tjankovic/2-77-ppd/design_notebook/A_04.jpg

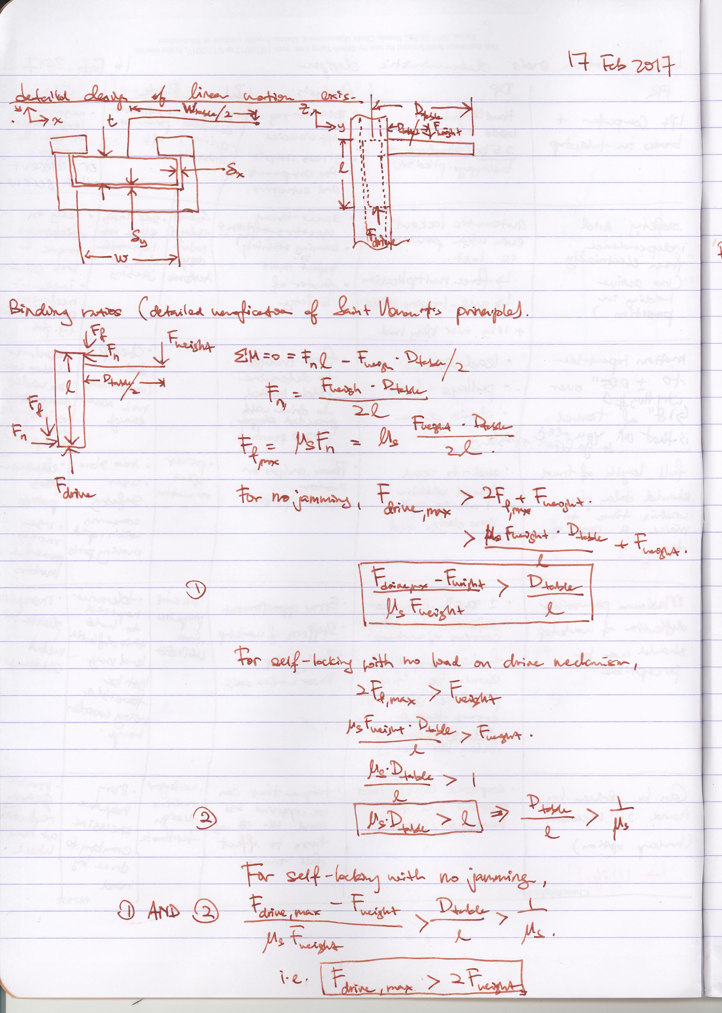
design_notebook/A_04.jpg
