tjankovic/2-77-ppd/design_notebook/A_01.jpg

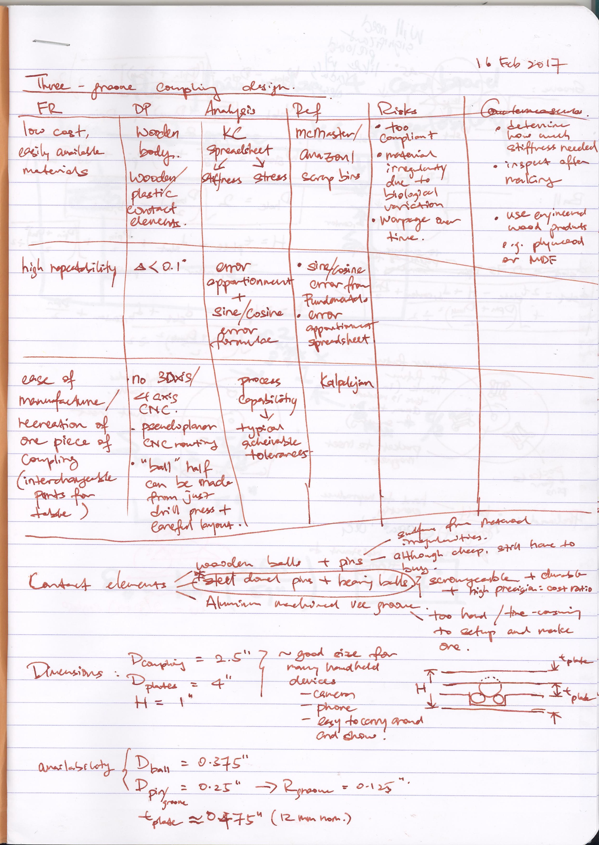
design_notebook/A_01.jpg
