tjankovic/2-77-ppd/design_spreadsheets/Detailed Engineering.xlsx

Sheet: structure
Desktop - simply supported |  |  | Material: baltic birch plywood
span length (mm) | 750 |  | mass density (kg/mm^3) | 0.00000068
thickness (mm) -- z | 18 |  | shear strength plywood (MPa) | 1.9 | http://www.matweb.com/search/DataSheet.aspx?MatGUID=bd6620450973496ea2578c283e9fb807
depth (mm) -- y | 500 |  | tensile strength plywood (MPa) | 30 | http://www.matweb.com/search/DataSheet.aspx?MatGUID=216748b4202446868305405c8cfe51a3
width (mm) -- x | 750
area (mm^2) | 9000 |  | Loading: center of desktop
I_thickness bending (mm^4) | 243000 |  | design live load (N) | 197
distance to extreme fiber (mm) | 9 |  | dead load (N) | 45.0279 | Technically distributed, but concentrated load is conservative
first moment of area (mm^3) | 20250 |  | total central load (N) | 242.0279
max bending moment (Nmm) | 45380.23125
max bending stress (Mpa) | 1.680749306
Tensile Safety Factor | 17.84918185
max shear force (N) | 121.01395
max shear stress (Mpa) | 0.02016899167
Shear Safety Factor | 94.20401532
Bracket -- cantilever leg + flange leg |  |  | Material: steel | average values provided by markforged
cantilever leg – bending |  |  | mass density (kg/mm^3) | 1.6e-06 | http://www.matweb.com/search/DataSheet.aspx?MatGUID=afc003f4fb40465fa3df05129f0e88e6
cantilever length (mm) | 25 |  | tensile strength (Mpa) | 370 | http://www.matweb.com/search/DataSheet.aspx?MatGUID=afc003f4fb40465fa3df05129f0e88e6
skin thickness (mm) | 1 |  | shear yield strength (Mpa) | 214.6 | https://en.wikipedia.org/wiki/Shear_strength
width (mm) | 45
spacer thickness (mm) | 18 |  | Loading: center of desktop, at edge
area (mm^2) | 90 |  | design live load (N) | 197
I_thickness bending (mm^4) | 8130.0 |  | dead load (N) | 45.0279 | Technically distributed, but concentrated load is at edge conservative
I_width_bending (mm^4) | 15187.5 |  | total central load (N) | 242.0279
distance to extreme fiber (mm) | 10 |  | load per bracket (N) | 121.01395
first moment of area (mm^3) | 5.625 |  | desktop depth (mm) | 500
max bending moment (Nmm) | 3025.34875
max bending stress (Mpa) | 3.721216175
Tensile Safety Factor | 99.42985912
max shear force (N) | 121.01395
max shear stress (Mpa) | 0.001860608087
Shear Safety Factor | 115338.6366
cantilever leg – torsion
cantilever length (mm) | 25
thickness (mm) | 1
width (mm) | 45
area (mm^2) | 45
I_polar (mm^4) | 23317.5
distance to extreme fiber (mm) | 22.50555487
max torque per bracket (Nmm) | 30253.4875
max torsional stress (Mpa) | 29.20002243
Torsion Safety Factor | 7.349309424
flange leg – axial loading
length under tension (mm) | 25
thickness (mm) | 1
width (mm) | 50
area (mm^2) | 50
max axial load (N) | 121.01395
max tensile stress (Mpa) | 2.420279
Safety Factor | 152.8749371
Columns - cantilever |  |  | Material: Solid European Birch
backplate |  |  | shear strength birch (MPa) | 11.8 | http://www.matweb.com/search/DataSheet.aspx?MatGUID=216748b4202446868305405c8cfe51a3
thickness (mm) x | 18 |  | tensile strength birch (MPa) | 130 | http://www.matweb.com/search/DataSheet.aspx?MatGUID=216748b4202446868305405c8cfe51a3
depth (mm) -- y | 125 |  | vertical load (N) | 242.0279 | worst-case where load concentrated at edge
height (mm) -- z | 600 |  | offset from column (mm) | 375
area (mm^2) | 2250
I_depth bending (mm^4) | 60750
spacers
thickness (mm) x | 50
depth (mm) -- y | 18
height (mm) -- z | 600
area_total (mm^2) | 1800
I_depth bending_both (mm^4) | 375000
keepers
thickness (mm) x | 18
depth (mm) -- y | 30.5
height (mm) -- z | 600
area_total (mm^2) | 1098
I_depth bending_both (mm^4) | 29646
overall
centroid distance from backplate (mm) | 35.39
I_depth bending (mm^4) | 4037678.517
distance to extreme fiber (mm) | 50.61
max bending moment (Nmm) | 45380.23125
max bending stress (MPa) | 0.5687972691
Safety Factor | 228.5524335
Feet -- cantilever |  |  | Material: Solid European Birch
length (mm) | 250 |  | shear strength birch (MPa) | 11.8 | http://www.matweb.com/search/DataSheet.aspx?MatGUID=216748b4202446868305405c8cfe51a3
height (mm) -- z | 50 |  | tensile strength birch (MPa) | 130 | http://www.matweb.com/search/DataSheet.aspx?MatGUID=216748b4202446868305405c8cfe51a3
thickness (mm) -- x | 18 |  | tip load (N) | 242.0279
area_total (mm^2) | 1800 |  | tip offset (mm) | 250
I_height bending_both (mm^4) | 375000
distance to extreme fiber (mm) | 25
first moment of area (mm^3) | 11250 | conservatively assume load at extreme corner, therefore felt entirely by one foot
max bending moment (Nmm) | 60506.975
max bending stress (MPa) | 4.033798333
Axial Safety Factor | 32.22768945
max shear force (N) | 242.0279
max shear stress (Mpa) | 0.4033798333
Shear Safety Factor | 29.25282581

Sheet: joints and bearings
bracket to slider
bolt hole bearing stress | worst-case where lateral friction in joint is completely relieved |  | Material: Mild Steel
bolt diameter (mm) | 5 |  | mass density (kg/mm^3) | 7.8e-06 | http://www.matweb.com/search/DataSheet.aspx?MatGUID=afc003f4fb40465fa3df05129f0e88e6
flange thickness (mm) | 2.67 |  | tensile yield strength (Mpa) | 250 | http://www.matweb.com/search/DataSheet.aspx?MatGUID=afc003f4fb40465fa3df05129f0e88e6
number of bolts | 4 |  | shear yield strength (Mpa) | 145 | https://en.wikipedia.org/wiki/Shear_strength
bearing area per bolt (mm^2) | 13.35
total bearing area (mm^2) | 53.4 |  | Loading: center of desktop
bearing stress (Mpa) | 2.27 |  | design live load (N) | 197
Safety Factor | 110.32 |  | dead load (N) | 45.0279 | Technically distributed, but concentrated load is conservative
 |  |  | total central load (N) | 242.0279
 |  |  | load per bracket (N) | 121.01395
slider in boxway
theta_y – slider prying keeper rail | conservatively assume load concentrated at tip of keeper rail |  | Material: Solid European Birch
slider length (mm) | 125 |  | shear strength birch (MPa) | 11.8 | http://www.matweb.com/search/DataSheet.aspx?MatGUID=216748b4202446868305405c8cfe51a3
keeper rail thickness (mm) | 18 |  | tensile strength birch (MPa) | 130 | http://www.matweb.com/search/DataSheet.aspx?MatGUID=216748b4202446868305405c8cfe51a3
keeper rail overhang (mm) | 12.5 |  | compressive yield strength (Mpa) | 10.8
contact patch length (mm) – extreme thirds of slider | 41.7
contact patch area (mm^2) | 520.8 |  | Loading: cantilever tip of bracket
contact patch separation (mm) | 41.66666667 |  | slider thickness – x (mm) | 50
effective cantilever width (mm) | 125 |  | bracket cantilevered length (mm) | 25
I_effective, keeper rail (mm^4) | 60750 |  | load per bracket (N) | 121.01395
distance to extreme fiber (mm) | 9 |  | moment about centroid of slider (Nmm) | 6050.6975
max bending moment (Nmm) | 1815.20925 |  | reaction force at contact patch (N) | 145.21674
max bending stress (Mpa) | 0.2689198889
Bending Safety Factor | 483.4153418
bearing stress (Mpa) | 0.2788161408
Crush Safety Factor | 38.73520367
theta x – sider prying spacer rail | conservatively assume load concentrated at tip of keeper rail |  | Loading: point load at front edge of desktop
slider length (mm) | 125 |  | desktop depth – y (mm) | 250
spacer rail height (mm) | 50 |  | total central load (N) | 242.0279 | worst-case where load concentrated at edge
spacer rail thickness (mm) | 18 |  | moment about centroid of slider (Nmm) | 60506.975
contact patch length (mm) – extreme thirds of slider | 41.7 |  | reaction force at contact patch (N) | 1452.1674
contact patch area (mm^2) | 2083.3
contact patch separation (mm) | 41.66666667
effective cantilever width (mm) | 125
I_effective, spacer rail (mm^4) | 60750
distance to extreme fiber (mm) | 9
max bending moment (Nmm) | 72608.37
max bending stress (Mpa) | 10.75679556
Bending Safety Factor | 12.08538354
bearing stress (Mpa) | 0.697040352
Crush Safety Factor | 15.49408147
column to foot
bolts in shear -- worst case where friction completely relieved |  |  | Bolt: ISO Class 12.9 SHCS
fulcrum offset from bolt (mm) | 101 |  | Proof load (Mpa) | 970
bolt diameter (mm) | 5 |  | Approximate shear strength (Mpa) | 562.6 | Von Mises
bolt engagement length (mm) | 12
number of bolts | 2 |  | Loading: point load at front edge of desktop
shear area per bolt (mm^2) | 19.63495408 |  | desktop depth – y (mm) | 250
shear load per bolt (N) | 299.5394802 |  | total central load (N) | 242.0279
max shear stress (Mpa) | 15.25542046 |  | moment about centroid of slider (Nmm) | 60506.975
Safety Factor | 36.87869513 |  | shear load to be carried by rear bolts (N) | 599.0789604
bolt hole radial crush -- worst case where friction completely relieved |  |  | Material: Solid European Birch
bolt engagement length (mm) | 12 |  | shear strength birch (MPa) | 11.8 | http://www.matweb.com/search/DataSheet.aspx?MatGUID=216748b4202446868305405c8cfe51a3
effective contact patch length (mm) | 6 | halve engagement length, considering use of threaded insert | tensile strength birch (MPa) | 130 | http://www.matweb.com/search/DataSheet.aspx?MatGUID=216748b4202446868305405c8cfe51a3
effective contact patch area (mm^2) | 30 |  | compressive yield strength (Mpa) | 10.8
bearing stress over contact patch (Mpa) | 9.98464934
Safety Factor | 1.08166042
joint friction from clamping -- how far until above 2 cases become relevant |  |  | Bolt frictional characteristics
bolt torque (Nmm) | 3000 | 3 Nm | coefficient of friction - steel on steel, lubricated | 0.3
clamping force per bolt (N) | 2000
coefficient of friction -- wood-to-wood | 0.3 | conservatively, actual range 0.2-0.6
frictional limit from clamping (N) | 1200
Safety Factor until friction fully relieved | 2.003074852
bolt pull-through from preload
flat head bolt head diameter (mm) | 12
flat head bolt clearance hole diameter (mm) | 6.6
flat head bolt bearing area (mm^2) | 78.88539153
bearing stress (Mpa) | 25.35323665
Safety Factor until wood locally crushed | 0.4259811143 | Overdriving
feet thickness (mm) | 18
shear area (mm^2) | 678.5840132
shear stress in wood below bolt (Mpa) | 2.947313761
Safety Factor until bolt pulls through | 4.003645678
fixed leadscrew block to boxway
bolts pullout -- worst case where preload completely relieved |  |  | Bolt: ISO Class 12.9 SHCS
fulcrum offset from bolt (mm) | 11.7 |  | Proof load (Mpa) | 970
bolt minor diameter (mm) | 5 |  | Approximate shear strength (Mpa) | 562.6
bolt engagement length (mm) | 12
number of bolts | 2 |  | Loading on block: load per leadscrew, concentrated on one side
cross-sectional area per bolt (mm^2) | 19.63495408 |  | total central load (N) | 242.0279
tensile load per bolt (N) | 217.2045256 |  | offset of edge from load (mm) | 21
max tensile stress in bolt (Mpa) | 11.06213565 |  | moment between fulcrum and bolts (Nmm) | 5082.5859
Safety Factor Until Bolt Breaks | 87.6865038
shear load per bolt (N) | 121.01395
max shear stress in bolt (Mpa) | 6.163189864
Safety Factor Until Bolt Shears | 91.28389882
max shear stress in wood below bolt (Mpa) | 0.2954630249
Safety Factor until bolt pulls through | 39.93731535
bolt hole radial crush -- worst case where clamping completely relieved |  |  | Material: Solid European Birch
bolt engagement length (mm) | 18 |  | shear strength birch (MPa) | 11.8
effective contact patch length (mm) | 6 | halve engagement length, considering use of threaded insert | tensile strength birch (MPa) | 130
effective contact patch area (mm^2) | 30 |  | compressive yield strength (Mpa) | 10.8
bearing stress over contact patch (Mpa) | 4.033798333
Safety Factor | 2.677377278
joint preload -- how far until above 2 cases become relevant |  |  | Bolt frictional characteristics
bolt torque (Nmm) | 2000 | 2 Nm, lightly nipped down | coefficient of friction - steel on steel, lubricated | 0.3
clamping force per bolt (N) | 1333.333333
coefficient of friction -- aluminum-to-wood | 0.3 | conservatively, actual range 0.2-0.6
frictional limit from clamping (N) | 800
Safety Factor until friction fully relieved | 3.683164509
bolt pull-through from preload
sex bolt head diameter (mm) | 13
sex bolt clearance hole diameter (mm) | 7.93 | 5/16"
sex bolt bearing area (mm^2) | 83.34260465
bearing stress (Mpa) | 15.99822011
Safety Factor until wood locally crushed | 0.6750750977 | Overdriving
boxway baseplate thickness (mm) | 18
shear area (mm^2) | 735.1326809
shear stress in wood below bolt (Mpa) | 1.813731545
Safety Factor until bolt pulls through | 6.505924226

Sheet: tip vs. slip
Coefficient of friction, wood on wood | 0.25
CG Height (mm) | 300 | approximating as midway up to first order
Mass of entire structure (kg) | 8.78
Dead weight of structure (N) | 86.1318
Desktop height at top of travel (mm) | 398.2 | from Solidworks
Design live load (N) | 197
Feet support span (mm) | 500
Desktop depth (mm) | 500
Offset of CG from front edge (mm) | 250
Offset of design load from front edge (mm) | 375 | conservatively assume concentrated 3/4 of the way back
Support force magnitude (N) | 283.1318
Support force offset from front edge at cusp of tipping (mm) | 500
Max lateral load before sliding (N) | 70.78295
Moments about front edge of feet at cusp of tipping
From dead weight (Nmm) | -21532.95
From design load (Nmm) | -73875
From support force (Nmm) | 141565.9
Tolerable lateral load before tipping (N) | 115.9164992
Factor of safety against tipping | 1.637633063

Sheet: actuator
Base Analysis
Lifting load capacity
motor torque rating (Nmm) | 600 | motor datasheet
number of motors | 2
leadscrew diameter (mm) | 10
leadnut coefficient of friction | 0.25 | igus polymer nut, light oil lubrication
coefficient of friction, slider pads on wood | 0.20
dead load (N) | 45.0279
design live load (N) | 197
total load (N) | 242.0279
slider effective length (mm) | 100
edge loading offset from center of friction (mm) | 250
moment resisted by sliders, per slider (Nmm) | 24625
contact force at each pad (N) | 246.25
frictional force at each pad (N) | 49.25
total frictional force in system, 4 pads in contact (N) | 197
total actuation force required (N) | 439.0279
lifting force at verge of stalling, per motor (N) | 240.00
ok to lift? | YES
Actuation speed (power analysis)
motor drive voltage, per motor (V) | 12 | wall wart power supply
motor drive current, per motor (A) | 0.50 | wall wart power supply, total 1A, split between 2 motors, switch-mode so almost 100% efficient
electrical power input, per motor (W) | 6
motor efficiency | 0.90 | approximate for stepper motors
drivetrain efficiency | 0.30 | approximate for sliding contact nut
net efficiency, motor to slider | 0.27
power available to lift per motor (W) | 1.62
max lifting speed allowed (mm/s) | 7.379941001
max lifting speed allowed (mm/min) | 442.7964601

Sheet: ls-friction-sweep
Close the loop: what gives? - leadscrew coefficient of friction
motor torque rating (Nmm) | 600
number of motors | 2
leadscrew diameter (mm) | 10
leadnut coefficient of friction | 0.43 | Max value allowable before failure to lift, ceteris paribus
coefficient of friction, slider pads on wood | 0.20
dead load (N) | 45.0279
design live load (N) | 117.72 | actual liftable live load = 12 kg
total load (N) | 162.7479
slider effective length (mm) | 100
edge loading offset from center of friction (mm) | 250
moment resisted by sliders, per slider (Nmm) | 14715
contact force at each pad (N) | 147.15
frictional force at each pad (N) | 29.43
total frictional force in system, 4 pads in contact (N) | 117.72
total actuation force required (N) | 280.4679
lifting force at verge of stalling, per motor (N) | 140.23
surplus lifting force (N) | -4.24929226e-07

Sheet: slider-friction-sweep
Close the loop: what gives? - slider coefficient of friction
motor torque rating (Nmm) | 600
number of motors | 2
leadscrew diameter (mm) | 10
leadnut coefficient of friction | 0.25
coefficient of friction, slider pads on wood | 0.54 | Max value allowable before failure to lift, ceteris paribus
dead load (N) | 45.0279
design live load (N) | 117.72 | actual live load lifted = 12kg
total load (N) | 162.7479
slider effective length (mm) | 100
edge loading offset from center of friction (mm) | 250
moment resisted by sliders, per slider (Nmm) | 14715
contact force at each pad (N) | 147.15
frictional force at each pad (N) | 79.31302525
total frictional force in system, 4 pads in contact (N) | 317.252101
total actuation force required (N) | 480.000001
lifting force at verge of stalling, per motor (N) | 240.00
surplus lifting force (N) | -9.999999406e-07

Sheet: min-deviation-sweep
Close the loop: what gives? - ls or slider coefficient of friction, minimum deviation condition
motor torque rating (Nmm) | 600
number of motors | 2
leadscrew diameter (mm) | 10
leadnut coefficient of friction | 0.37
coefficient of friction, slider pads on wood | 0.28
dead load (N) | 45.0279
design live load (N) | 117.72
total load (N) | 162.7479
slider effective length (mm) | 100
edge loading offset from center of friction (mm) | 250
moment resisted by sliders, per slider (Nmm) | 14715
contact force at each pad (N) | 147.15
frictional force at each pad (N) | 40.90967773
total frictional force in system, 4 pads in contact (N) | 163.6387109
total actuation force required (N) | 326.3866109
lifting force at verge of stalling, per motor (N) | 163.19
surplus lifting force (N) | 2.313407776e-07
initial estimate for leadscrew frictional coefficient | 0.25
initial estimate for slider frictional coefficient | 0.20
sum sq of parameter shift from ls and slider frictional coefficients | 0.020
