tjankovic/2-77-ppd/design_spreadsheets/Bearing Preload/Bearing Preload Toy Design.ods

Material Properties
Young’s Modulus (Gpa) | 0.001
Young’s Modulus (N/mm^2) | 1
Geometry
Slider length (mm) | 101.5
Slider height (mm) | 43
Area (mm^2) | 4364.5
Rubber pad thickness (mm) | 9.5
Stiffness (N/mm) | 459.4
Preload
Surface imperfection characteristic dimension (mm) | 0.1
Preload displacement (mm) | 1
Preload force (N) | 459
Friction
Coefficient of static friction | 0.3
Additional friction force caused by preload (N) | 138
Fabrication |  | inches
Original slider width (mm) | 49.149 | 1.935
Original radial clearance (mm) | 0.5 | 0.0196850394
Slot width (mm) | 50.292 | 1.98
New overall undeformed width (mm) | 51.292 | 2.0193700787
Bearing pad thickness (mm) | 5.08 | 0.2
New slider body thickness (mm) | 36.712 | 1.4453543307
