tjankovic/2-77-ppd/design_spreadsheets/Bearing Preload/Compliant Slider Preload.xlsx

Compliant material shore A: | 10
approximate modulus (N/mm^2) | 0.4126825567
uncompressed thickness of patch (mm) | 3.175
width of patch (mm) | 50
height of patch (mm) | 50
patch area (mm^2) | 2500
coefficient of friction | 0.15 | tribo tape on waxed wood
allowable actuation force penalty per patch (N) | 20
desired preload force (N) | 133.3333333
desired preload stress (N/mm^2) | 0.05333333333
desired preload strain | 0.1292357345
desired preload deflection (mm) | 0.410323457
thickness of tribo tape (mm) | 0.65
total thickness of foam and tribo tape (mm) | 3.825
depth of inlay (mm) | 3.414676543
depth of inlay rounded to reasonable number (mm) | 3.5
actual preload strain | 0.1023622047
actual preload stress (N/mm^2) | 0.04224309636
actual preload force (N) | 105.6077409
actual actuation force penalty per patch (N) | 15.84116113 |  | 75.125
