tjankovic/2-77-ppd/kinematic_coupling/Analysis/kinematic_coupling_R2.xlsx

Kinematic_Coupling_3Groove_Design.xls
To design three groove kinematic couplings
Written by Alex Slocum long ago. Last modified 2012/10/28 by Alex Slocum
Metric units only! Enters numbers in BOLD, Results in RED |  |  |  |  | Material properties
Standard 120 degree equal size groove coupling? (contact forces are inclined at 45 to the XY plane. For non standard designs, enter geometry after results section) |  |  |  | TRUE | User defined material | Aluminum
 |  |  |  |  | Yield stress
System geometry (XY plane is assumed to contain the ball centers) |  |  |  |  | plastic | 34500000
Dbeq (mm) = | 9.525 | Equivalent diameter ball to contact the groove at the same points | 3/8" |  | RC 62 Steel | 1724000000
Rbminor (mm) = | 4.7625 | "Ball" minor radius |  |  | CARBIDE | 2758000000
Rbmajor (mm) = | 4.7625 | "Ball" major radius |  |  | user defined | 276000000
Rgroove (mm) = | 3.175 | Groove radius (negative for a trough) | 1/4" |  | Elastic modulus
Costheta = | 1 | Is ball major radius along groove axis? |  |  | plastic | 2070000000
Dcoupling (mm) = | 63.5 | Coupling diameter | 2.5" |  | RC 62 Steel | 204100000000
Fpreload (N) = | -1.48 | Preload force over each ball (negative pushes ball into groove) | 1 lbf centralized, 0.333 lbf/ball |  | CARBIDE | 310300000000
Xerr (mm) = | 0.0 | X location of error reporting |  |  | user defined | 68000000000
Yerr (mm) = | 0.0 | Y location of error reporting |  |  | Poisson ratio
Zerr (mm) = | 0.0 | Z location of error reporting |  |  | plastic | 0.20
Auto select material values (enter other_4 to the right) |  |  |  |  | RC 62 Steel | 0.29
Matlabball = | 2 | Enter 1 for plastic, 2 for steel, 3 for carbide, 4 for user defined, 5 where each ball and groove is defined individually |  |  | CARBIDE | 0.30
Matlabgroove = | 2 |  |  |  | user defined | 0.29
Min. yield strength (Pa, psi) |  | 1724000000 | 249855.0725
Largest contact ellipse major diameter (mm) |  | 0.165
Smallest contact ellipse major diameter (mm) |  | 0.090
Largest contact stress ratio |  | 0.51
RMS applied force (N) |  | 23.32380758
RMS stiffness (N/micron) |  | 59.91923827
Z displacement caused by preload (mm) |  | 0.0001778583012
Applied Z load at zero inclination (N) | -10
inclination angle (degrees) | 0
Applied force's Z,Y,Z values and coordinates |  |  |  | Coupling centroid location
FLx (N) = | 12.00 | XL (mm) = | 0 | xc (mm) | 0.000 |  | XL (m) = | 0.000
FLy (N) = | 0 | YL (mm) = | 0 | yc (mm) | 0.000 |  | YL (m) = | 0.000
FLz (N) = | -20 | ZL (mm) = | 0 | zc (mm) | 0.000 |  | ZL (m) = | 0.000
Results: Hertz stresses and deformations
Error displacements at the point of interest due to applied load (preload displacement subtracted off) (micron)
DeltaX (mm) | -0.0002 |  | DeltaY (mm) | 0.0000 |  | DeltaZ (mm) | 0.0003
resulting rotation (degrees) wrt center) | -0.0004 |  |  | 0.0000
Vector displacement (mm) | 0.0004
Groove normal forces (preload + applied load) (N) |  | Contact stress (preload + applied load) (Pa) |  | Max shear stress/(ult. tensile/2) | Deflection (+into ball) (m) |  |  | Contact ellipse size (m)
 |  |  |  |  | from: | Applied Load | Preload only | Rmajor | Rminor
Ball-Groove 1 |  | Ball-Groove 1 |  |  | Ball-Groove 1 |  |  | Ball-Groove 1
Fbnone | 11.4 | sigone | 1471880669 | 0.512 | delone | 9.855162823e-07 | 2.514735207e-07 | 8.237648434e-05 | 4.496073615e-05
Fbntwo | 0.1 | sigtwo | 307105377.5 | 0.107 | deltwo | -1.976202491e-07 | 2.514735207e-07 | 1.718779299e-05 | 9.381024597e-06
Ball-Groove 2 |  | Ball-Groove 2 |  |  | Ball-Groove 2 |  |  | Ball-Groove 2
Fbnthree | 2.9 | sigthree | 935572878.2 | 0.326 | delthree | 2.483087962e-07 | 2.514735207e-07 | 5.23611125e-05 | 2.857847337e-05
Fbnfour | 8.6 | sigfour | 1338640408 | 0.466 | delfour | 7.717011168e-07 | 2.514735207e-07 | 7.491947161e-05 | 4.08907302e-05
Ball-Groove 3 |  | Ball-Groove 3 |  |  |  |  |  | Ball-Groove 3
Fbnfive | 2.9 | sigfive | 935572878.2 | 0.326 | delfive | 2.483087962e-07 | 2.518101264e-07 | 5.23611125e-05 | 2.857847337e-05
Fbnsix | 8.6 | sigsix | 1338640408 | 0.466 | delsix | 7.717011168e-07 | 2.514735207e-07 | 7.491947161e-05 | 4.08907302e-05
Results: Error motions |  |  | Xerr | Yerr | Zerr
Error motions are at X,Y,Z coordinates (m) |  |  | 0.000 | 0.000 | 0.000
deltaX | -2.011163539e-07 |  | RMS | 3.892540735e-07
deltaY | 0 |  | Homogenous Transformation Matrix:
deltaZ | 3.332730801e-07 |  | 1 | -5.061173026e-07 | 0 | -2.011163539e-07
EpsX | -1.723110154e-06 | -9.872693944e-05 | 5.061173026e-07 | 1 | 1.723110154e-06 | 0
EpsY | 0 |  | 0 | -1.723110154e-06 | 1 | 3.332730801e-07
EpsZ | 5.061173026e-07 |  | 0 | 0 | 0 | 1
Generic data entry for non-120 degree couplings
NOTE! For calculation of angular errors, the coupling is assumed to lie in the XY plane.
Ball 1 must lie in quadrants 1 0r 2, and Balls 2 & 3 must lie in quadrants 3 and 4
Enter X,Y,Z coordinates and alpha, beta, gamma direction cosines for Ball 1
Dball (m) | 0.0095
Dcoupling (m) | 0.064
 | Contact point 1 |  | Contact point 2
Xba = | 0.003368 | Xbb = | -0.003368
Yba = | 0.031750 | Ybb = | 0.031750
Zba = | -0.003368 | Zbb = | -0.003368
Aba = | -0.707107 | Abb = | 0.707107
Bba = | 0.000000 | Bbb = | 0.000000
Gba = | 0.707107 | Gbb = | 0.707107 |  | User values if matlabs = 5
Enter characteristics for groove 1 and ball 1
Egone = | 204100000000 | Groove material elastic modulus, or enter value (mm):
vgone = | 0.29000 | Groove material Poisson ratio, or enter value (mm):
Rgone = | 0.003175 | Groove radius of curvature
Ebone = | 204100000000 | Ball material elastic modulus, or enter value (Pa):
vbone = | 0.29 | Ball material Poisson ratio, or enter value (Pa):
Eeone = | 1.114204607e+11 | Equivelent modulus
Dbone = | 0.009525 | Equivelent diameter ball that would contact the groove at the same points
Rpone = | 0.0047625 | "Ball" major radius of curvature, or enter value (mm):
Raone = | 0.0047625 | "Ball" minor radius of curvture, or enter value (mm):
Reone = | 0.001360714286 | Equivelent radius
ctone = | 0.4285714286 | Cos(theta)
theta_1 = | 1.127885283
alpha_1 = | 1.387752383
beta_1 = | 0.757429371
lambda_1 = | 0.7164610809
Sone = | 1724000000 | Allowable Hertz stress, or enter value:
Enter X,Y,Z coordinates and alpha, beta, gamma direction cosines for Ball 2
 | Contact point 3 |  | Contact point 4
Xbc = | -0.029180 | Xbd = | -0.025813
Ybc = | -0.012959 | Ybd = | -0.018791
Zbc = | -0.003368 | Zbd = | -0.003368
Abc = | 0.353553 | Abd = | -0.353553
Bbc = | -0.612372 | Bbd = | 0.612372
Gbc = | 0.707107 | Gbd = | 0.707107 |  | User values if matlabs = 5
Enter characteristics for groove 2 and pin 2
Egtwo = | 204100000000 | Groove material elastic modulus, or enter value (mm):
vgtwo = | 0.29000 | Groove material Poisson ratio, or enter value (mm):
Rgtwo = | 0.003175 | Groove radius of curvature
Ebtwo = | 204100000000 | Ball material elastic modulus, or enter value (Pa):
vbtwo = | 0.29 | Ball material Poisson ratio, or enter value (Pa):
Eetwo = | 1.114204607e+11 | Equivelent modulus
Dbtwo = | 0.009525 | Equivelent diameter ball that would contact the groove at the same points
Rptwo = | 0.0047625 | "Ball" major radius of curvature, or enter value (mm):
Ratwo = | 0.0047625 | "Ball" minor radius of curvture, or enter value (mm):
Retwo = | 0.001360714286 | Equivelent radius
cttwo = | 0.4285714286 | Cos(theta)
theta_2 = | 1.127885283
alpha_2 = | 1.387752383
beta_2 = | 0.757429371
lambda_2 = | 0.7164610809
Stwo = | 1724000000 | Allowable Hertz stress
Enter X,Y,Z coordinates and alpha, beta, gamma direction cosines for Ball 3
 | Contact point 5 |  | Contact point 6
Xbe = | 0.025813 | Xbf = | 0.029180
Ybe = | -0.018791 | Ybf = | -0.012959
Zbe = | -0.003368 | Zbf = | -0.003368
Abe = | 0.353553 | Abf = | -0.353553
Bbe = | 0.612372 | Bbf = | -0.612372
Gbe = | 0.707107 | Gbf = | 0.707107 |  | User values if matlabs = 5
Enter characteristics for groove 3 and ball 3
Egthree = | 204100000000 | Groove material elastic modulus, or enter value (mm):
vgthree = | 0.29000 | Groove material Poisson ratio, or enter value (mm):
Rgthree = | 0.003175 | Groove radius of curvature
Ebthree = | 204100000000 | Ball material elastic modulus, or enter value (Pa):
vbthree = | 0.29 | Ball material Poisson ratio, or enter value (Pa):
Eethree = | 1.114204607e+11 | Equivelent modulus
Dbthree = | 0.009525 | Equivelent diameter ball that would contact the groove at the same points
Rpthree = | 0.0047625 | "Ball" major radius of curvature, or enter value (mm):
Rathree = | 0.0047625 | "Ball" minor radius of curvture, or enter value (mm):
Rethree = | 0.001360714286 | Equivelent radius
ctthree = | 0.4285714286 | Cos(theta)
theta_3 = | 1.127885283
alpha_3 = | 1.387752383
beta_3 = | 0.757429371
lambda_3 = | 0.7164610809
Sthree = | 1724000000 | Allowable Hertz stress
Preload forces' X,Y,Z components and coordinates
Fpxone = | 0 | Fpxtwo = | 0 | Fpxthree = | 0
Fpyone = | 0 | Fpytwo = | 0 | Fpythree = | 0
Fpzone = | -1.48 | Fpztwo = | -1.48 | Fpzthree = | -1.48
Xpone = | 0 | Xptwo = | -0.02749630657 | Xpthree = | 0.02749630657
Ypone = | 0.03175 | Yptwo = | -0.015875 | Ypthree = | -0.015875
Zpone = | 0.01905 | Zptwo = | 0.01905 | Zpthree = | 0.01905
Calculations:
Build Force Moment equilibrium matrices: AF = B (Equations 1-6)
Matrix A |  |  |  |  |  | Matrix F | B with loads | B w/o loads
Fbn1 | Fbn2 | Fbn3 | Fbn4 | Fbn5 | Fbn6
-0.7071067812 | 0.7071067812 | 0.3535533906 | -0.3535533906 | 0.3535533906 | -0.3535533906 | Fbn1 | -12 | 0 | Sum forces X direction
0 | 0 | -0.6123724357 | 0.6123724357 | 0.6123724357 | -0.6123724357 | Fbn2 | 0 | 0 | Sum forces Y direction
0.7071067812 | 0.7071067812 | 0.7071067812 | 0.7071067812 | 0.7071067812 | 0.7071067812 | Fbn3 | 24.44 | 4.44 | Sum forces Z direction
0.0224506403 | 0.0224506403 | -0.01122532015 | -0.01122532015 | -0.01122532015 | -0.01122532015 | Fbn4 | 0 | 0 | Sum moments X axis
0 | 0 | 0.01944282483 | 0.01944282483 | -0.01944282483 | -0.01944282483 | Fbn5 | 0 | 0 | Sum moments Y axis
0.0224506403 | -0.0224506403 | 0.0224506403 | -0.0224506403 | 0.0224506403 | -0.0224506403 | Fbn6 | 0 | 0 | Sum moments Z axis
Res. Forces with applied loads |  | Res forces with preload only
fbnone | 11.42 | fone | 1.05
fbntwo | 0.10 | ftwo | 1.05
fbnthree | 2.93 | fthree | 1.05
fbnfour | 8.59 | ffour | 1.05
fbnfive | 2.93 | ffive | 1.05
fbnsix | 8.59 | fsix | 1.05
Original ball corrdinates
xboneO | 0.0000000 | xbtwoO | -0.0274963 | xbthreeO | 0.0274963
yboneO | 0.0317500 | ybtwoO | -0.0158750 | ybthreeO | -0.0158750
zboneO | 0.0000000 | zbtwoO | 0.0000000 | zbthreeO | 0.0000000
New ball coordinates (=original + ball deflection*direction cosines)
xboneN | -0.0000004183 | xbtwoN | -0.0274964 | xbthreeN | 0.0274962
yboneN | 0.0317500 | ybtwoN | -0.0158748 | ybthreeN | -0.0158752
zboneN | 0.0000003 | zbtwoN | 0.0000004 | zbthreeN | 0.0000004
Ball centers' deflections
dxone | -4.183019322e-07 | dxtwo | -9.252356478e-08 | dxthree | -9.252356478e-08
dyone | 0 | dytwo | 1.602555151e-07 | dythree | -1.602555151e-07
dzone | 2.78563314e-07 | dztwo | 3.606279632e-07 | dzthree | 3.606279632e-07
Theory applicability check:
Initiial dist. between balls |  | Final dist. between balls |  | Difference
LotI | 0.05499261314 | LotN | 0.05499231147 | DLotI | 3.016740986e-07
LttI | 0.05499261314 | LttN | 0.05499261314 | DLttI | -9.340098139e-13
LtoI | 0.05499261314 | LtoN | 0.05499291482 | DLtoI | -3.016749631e-07
Change in length/distance between balls |  |  | Deflection/ball radius |  | Ratio (should be >5)
5.485720379e-06 |  |  | 0.0002069325527 |  | 37.72203802
1.698427772e-11 |  |  | 0.0001620369799 |  | 9540410.408
5.4857361e-06 |  |  | 0.0001620369799 |  | 29.53787367
Coupling centroid is assumed to be at intersection of coupling triangle's angle bisectors |  |  |  |  |  | but if only apply load over balls, gives erroroneous value
Initial centroid |  | Distance from ball to centroid |  | Error motion at centroid from weighted ball motions |  | initial theory was dzone*(LotI-Dcone)/LotI+dztwo*(LttI-Dctwo)/LttI+dzthree*(LtoI-Dcthree)/LtoI
xci | 0.000000000 | Dcone | 0.031750000 | dxc | -2.011163539e-07 | -4.022327078e-07
yci | 0.000000000 | Dctwo | 0.031750000 | dyc | 0
zci | 0.000000000 | Dcthree | 0.031750000 | dzc | 3.332730801e-07
Original angles between balls |  |  | Original altitude lengths
Angone | 60.0000000000 | angle at ball 1 | Aone | 0.0476 | Ball 1 to side 2 3
Angtwo | 60.0000000000 | angle at ball 2 | Atwo | 0.0476 | Ball 2 to side 1 3
Angthree | 60.0000000000 | angle at ball 3 | Athree | 0.0476 | Ball 3 to side 2 1
New angles between balls |  |  | Original sides' angle with X axis
AngoneN | 60.0000 | angle at ball 1 | Aot | 60 | Side opposite ball 3
AngtwoN | 60.0005 | angle at ball 2 | Att | 0 | Side opposite ball 1
AngthreeN | 59.9995 | angle at ball 3 | Ato | 120 | Side opposite ball 2
New sides' angle with X axis
AotN | 60.00021047 | Side opposite ball 3 |  | 0
AttN | -0.0003339344735 | Side opposite ball 1 |  | 0
AtoN | 120.0002105 | Side opposite ball 2
Original altitudes' slope angles and Y intercepts
AmtwoO | 30 | AbtwoO | 0
AmthreeO | 150 | AbthreeO | 0
Rotation about opposite side (radians)
Ttt | 5.849130543e-06 | rotation about side 23 due to Z motion at ball 1
Tto | 7.572240697e-06 | rotation about side 13 due to Z motion at ball 2
Tot | 7.572240697e-06 | rotation about side 12 due to Z motion at ball 3
Coupling error rotations
EpsX | -1.723110154e-06 |  | EpsZ1 | 1.317486401e-05 | Z rot from ball 1
EpsY | 0 |  | EpsZ2 | -5.828256049e-06 | Z rot from ball 2
EpsZ | 5.061173026e-07 |  | EpsZ3 | -5.828256049e-06 | Z rot from ball 3
Coupling HTM |  |  |  |  | Point of interest
1 | -5.061173026e-07 | 0 | -2.011163539e-07 | Xerr | 0
5.061173026e-07 | 1 | 1.723110154e-06 | 0 | Yerr | 0
0 | -1.723110154e-06 | 1 | 3.332730801e-07 | Zerr | 0
0 | 0 | 0 | 1 | 1 | 1
Error displacements at the point of interest
DeltaX | -2.011163539e-07
DeltaY | 0
DeltaZ | 3.332730801e-07
 | 0
