tjankovic/2-77-ppd/desk CAD/twin_column_design/renderings/march 26/full desk oblique.JPG

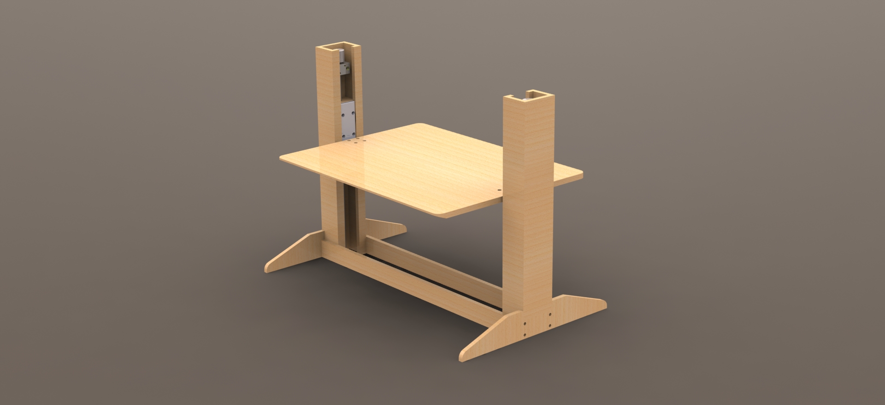
desk CAD/twin_column_design/renderings/march 26/full desk oblique.JPG
