tjankovic/2-77-ppd/Purchasing/Budget.xlsx

Item | Unit | Quantity | Unit Price | Total Cost |  | Beech cut list
3/4" baltic birch plywood 30"x30" panel | panel | 1 | $28.00 | $28.00 |  | Thickness (in) | dressed width (in) | nominal width (in) | length (mm) | length (in) | pieces | volume (in^3)
European beech 3/4" boards | board foot | 8 | $5.50 | $44.00 | boxway backplate | 0.75 | 5 | 6 | 600 | 23.62204724 | 2 | 212.5984252 | 5.94652231
3/4" natural birch plywood 2'x4' panel | panel | 1 | $29.00 | $29.00 | boxway side rails | 0.75 | 2 | 3 | 600 | 23.62204724 | 4 | 212.5984252
Lumber delivery |  | 1 | $40.00 | $40.00 | boxway keeper rails | 0.75 | 1 | 2 | 600 | 23.62204724 | 4 | 141.7322835
 |  |  |  |  | legs | 0.75 | 4 | 5 | 500 | 19.68503937 | 2 | 147.6377953
 |  |  |  | $141.00 | cross ties | 0.75 | 2 | 3 | 800 | 31.49606299 | 2 | 141.7322835
 |  |  |  |  |  |  |  |  |  |  | Total Volume (in^3) | 856.2992126
 |  |  |  |  |  |  |  |  |  |  | Total board footage | 5.94652231
