tjankovic/2-77-ppd/Purchasing/wood material list.xlsx

European beech cut list
Thickness (in) | dressed width (in) | length (mm) | length (in) | quantity
0.75 | 5 | 600 | 23.62204724 | 2
0.75 | 2 | 600 | 23.62204724 | 4
0.75 | 1 | 600 | 23.62204724 | 4
0.75 | 4 | 500 | 19.68503937 | 2
0.75 | 2 | 800 | 31.49606299 | 2
0.75 | 3 | 300 | 11.81102362 | 3
Plywood
Item | Quantity
Baltic birch 30"x30"x3/4" | 1
Natural birch 2'x4'x3/4" | 1
