tjankovic/2-77-ppd/design_spreadsheets/first_order_analysis_single_column_rear_mounted.xls

Sheet: Error Apportionment Summary
Axis_error_apportionment_estimator.xls
To apportion errors between types and axes. By Alex Slocum, last modified SYL 02/27/2017 for Standing Desk
Enter numbers in BOLD, Results in RED
Number of moving axes, N | 1
Total allowable error, dtot (e.g., mm) | 5
 |  |  |  | Apportion of error within each axis (amount allocated to each of X, Y, Z directions) to be determined by sensitive directions
 |  |  |  | Bearings (fb) | Structure (fs) | Actuator (fa) | Sensor (fs) | Cables (fc)
Source of error | Factor (f) | Apportion of error (dtot/f) | Apportion of error per axis | 0.45 | 0.45 | 0.1 | 0 | 0
Based on linear sum of errors
Geometric, fg | 1 | 1.000 | 1.000 | 0.450 | 0.450 | 0.100 | 0.000 | 0.000
Thermal, ft | 0 | 0.000 | 0.000 | 0.000 | 0.000 | 0.000 | 0.000 | 0.000
Load-induced (deflection), fl | 3.8 | 3.800 | 3.800 | 1.710 | 1.710 | 0.380 | 0.000 | 0.000
Process, fp | 0.2 | 0.200 | 0.200 | 0.090 | 0.090 | 0.020 | 0.000 | 0.000
Based on root square sum of errors
Geometric, fg | 1 | 1.271 | 1.271 | 0.888 | 0.888 | 0.197 | 0.000 | 0.000
Thermal, ft | 0 | 0.000 | 0.000 | 0.000 | 0.000 | 0.000 | 0.000 | 0.000
Load-induced (deflection), fl | 3.8 | 4.829 | 4.829 | 3.373 | 3.373 | 0.750 | 0.000 | 0.000
Process, fp | 0.2 | 0.254 | 0.254 | 0.178 | 0.178 | 0.039 | 0.000 | 0.000
 | Average (expected case) of linear and RSS
Geometric, fg | 1 | 1.135 | 1.135 | 0.669 | 0.669 | 0.149 | 0.000 | 0.000
Thermal, ft | 0 | 0.000 | 0.000 | 0.000 | 0.000 | 0.000 | 0.000 | 0.000
Load-induced (deflection), fl | 3.8 | 4.315 | 4.315 | 2.542 | 2.542 | 0.565 | 0.000 | 0.000
Process, fp | 0.2 | 0.227 | 0.227 | 0.134 | 0.134 | 0.030 | 0.000 | 0.000

Sheet: Load Configurations
Live Load
Designed distributed load (N) | 147.15 | 15 kg from stuff on desk
Designed point load (N) | 49.05 | 5 kg from leaning
 | 196.2
Dead Load
Table weight (N) | 63.4584375
Total Load
Total force driving table downwards (N) | 259.6584375

Sheet: Structure
Tabletop
Table width, W_t (mm) | 750 |  | Material Properties for Plywood |  | Source
Table depth, D_t (mm) | 500 |  | Densities (kg/m^3) | 690 | http://www.plywoodeurope.com/plywood-density.html
Table thickness, T_t (mm) | 25 |  | Flexure modulus (GPa) | 9.25 | http://www.matweb.com/search/datasheet.aspx?matguid=bd6620450973496ea2578c283e9fb807&ckck=1
Table mass, M_t (kg) | 6.5
Table weight, F_w,t (N) | 63.4584375 |  | Material Properties for Birch Lumber |  | Source
I_front,back (mm^4) | 976562.5 |  | Flexure modulus (GPa) | 10.6 | http://www.matweb.com/search/datasheet.aspx?matguid=f842feea2ae14f5d9897dbedc72608e8
I_side,side (mm^4) | 651041.6667 |  | Shear modulus (GPa) | 4.1 | http://homepages.which.net/~paul.hills/Materials/MaterialsBody.html | approximating with douglas fir
Vertical Column
Length (mm) | 650
Width (mm) | 150
Depth (mm) | 100
I_front,back (mm^4) | 12500000 | Currently assuming solid, need to account for boxway cutout
I_side,side (mm^4) | 28125000 | Currently assuming solid, need to account for boxway cutout |  |  |  |  | Cantilever Formulae
 |  |  |  |  |  |  | Free-end deflection, point load at free end | (P*L^3)/(3*E*I)
Crossbeam |  |  |  |  |  |  | Slope at free end, point load at free end | (P*L^2)/(2*E*I)
Length (mm) | 800 | Currently picking width + 1in clearance to alleviate pinching |  |  |  |  | Free-end deflection, moment at free end | (M*L^2)/(2*E*I)
Width (mm) | 50 |  |  |  |  |  | Slope at free end, moment at free end | (M*L)/(E*I)
Thickness (mm) | 100
I_side,side (mm^4) | 4166666.667
J (mm^4) | 5208333.333 | http://www.engineersedge.com/polar-moment-inertia.htm
Legs
Length (mm) | 500
Width (mm) | 75
Thickness (mm) | 18
I_front,back (mm^4) | 36450

Sheet: Bearings
Inputs
Bearing length, l_b (mm) | 200
Bearing thickness, t_b (mm) | 60
Bearing width, w_b (mm) | 100
Coefficient of friction, nu | 0.25
Radial clearance, d_rc (mm) | 0.25
Geometric error
Approximate angular error, small angle (deg) | 0.0025
Error at corner due to roll (mm) | 0.9
Error at corner due to pitch (mm) | 1.2
Total error at corner due to wiggle (mm) | 2.2
Self-locking/binding
Max static friction caused by table deadweight only, 2*F_f,max (N) | 59.49228516 | Worst-case scenario for safety
Self-locking under worst-case scenario (due to bearing alone)? | FALSE | F_f = (mu*W*L_t)/(2*L_b) | F_f > (P+W)/2
Minimum passive leadscrew thrust to lock (N) | 200.1661523 | Negative when bearing self-locks

Sheet: Actuation
Motor Specifications
Holding torque (Nmm) | 450
Pullout torque (Nmm) | 337.5 | Estimated as 75% holding torque, need to find torque curve/test
Efficiency | 0.5
Designed operating torque (Nmm) | 303.75 | 90% of pullout torque for safety factor + thermal stability
Leadscrew
Leadscrew diameter (mm) | 8
Leadscrew pitch required (mm/rev) | 1.752316207
Force Analysis for Binding
Payload weight (N) | 259.6584375
Worst-case additional load due to friction (N) | 284.9115234 | 2 * F_f,max
Total actuation force required (N) | 544.5699609

Sheet: Preliminary Error Budgeting
Load-induced errors |  |  | Geometric errors
Tabletop deflection |  |  | Free corner deflection due to bearing clearance (mm) | 2.2
Free-end deflection, front-rear, live loads on corner (mm) | 0.9
Free-end deflection, sideways, live loads on corner (mm) | 0.4
Corner deflection due to tabletop bending (mm) | 1.3
Column bending
theta_end,x (deg) | 0.00055
theta_end,y (deg) | 0.00018
Total corner deflection due to column flexing (mm) | 0.34 | small angle approximation
Crossbeam torsion
theta_mid,front,back (deg) | 0.0018
Corner deflection due to crossbeam torsion (mm) | 0.92 | small angle approximation
Crossbeam bending
theta_mid,side (deg) | 0.0013
Corner deflection due to crossbeam bending (mm) | 0.50 | small angle approximation
Leg bending
Total load-induced error | 3.1 |  | Total geometric error | 2.2

Sheet: Edit History
Event # | Date: | By: | Summary of edits made
1 | 2016-03-18 | Alex Slocum | Formatting to be more clear
2 | 2017-02-27 | Shien Yang Lee | Specify allowable errors for desk
3 | 2017-03-10 | Shien Yang Lee | Populate binding and self-locking formulae
4 | 2017-03-10 | Shien Yang Lee | Add actuator and load configuration
5 | 2017-03-11 | Shien Yang Lee | Edit to consider single boxway leadscrew drive
