tjankovic/2-77-ppd/design_spreadsheets/first_order_analysis_self_locking_belt_drive.xls

Sheet: Error Apportionment Summary
Axis_error_apportionment_estimator.xls
To apportion errors between types and axes. By Alex Slocum, last modified SYL 02/27/2017 for Standing Desk
Enter numbers in BOLD, Results in RED
Number of moving axes, N | 1
Total allowable error, dtot (e.g., mm) | 3
 |  |  |  | Apportion of error within each axis (amount allocated to each of X, Y, Z directions) to be determined by sensitive directions
 |  |  |  | Bearings (fb) | Structure (fs) | Actuator (fa) | Sensor (fs) | Cables (fc)
Source of error | Factor (f) | Apportion of error (dtot/f) | Apportion of error per axis | 1 | 1 | 0.2 | 0 | 0
Based on linear sum of errors
Geometric, fg | 1 | 1.364 | 1.364 | 0.620 | 0.620 | 0.124 | 0.000 | 0.000
Thermal, ft | 0 | 0.000 | 0.000 | 0.000 | 0.000 | 0.000 | 0.000 | 0.000
Load-induced (deflection), fl | 1 | 1.364 | 1.364 | 0.620 | 0.620 | 0.124 | 0.000 | 0.000
Process, fp | 0.2 | 0.273 | 0.273 | 0.124 | 0.124 | 0.025 | 0.000 | 0.000
Based on root square sum of errors
Geometric, fg | 1 | 2.100 | 2.100 | 1.471 | 1.471 | 0.294 | 0.000 | 0.000
Thermal, ft | 0 | 0.000 | 0.000 | 0.000 | 0.000 | 0.000 | 0.000 | 0.000
Load-induced (deflection), fl | 1 | 2.100 | 2.100 | 1.471 | 1.471 | 0.294 | 0.000 | 0.000
Process, fp | 0.2 | 0.420 | 0.420 | 0.294 | 0.294 | 0.059 | 0.000 | 0.000
 | Average (expected case) of linear and RSS
Geometric, fg | 1 | 1.732 | 1.732 | 1.045 | 1.045 | 0.209 | 0.000 | 0.000
Thermal, ft | 0 | 0.000 | 0.000 | 0.000 | 0.000 | 0.000 | 0.000 | 0.000
Load-induced (deflection), fl | 1 | 1.732 | 1.732 | 1.045 | 1.045 | 0.209 | 0.000 | 0.000
Process, fp | 0.2 | 0.346 | 0.346 | 0.209 | 0.209 | 0.042 | 0.000 | 0.000

Sheet: Bearings
Sliding bearing
Inputs
Bearing length, l_b (mm) | 50
Bearing thickness, t_b (mm) | 30
Bearing width, w_b (mm) | 30
Coefficient of friction, nu | 0.4
Radial clearance, d_rc (mm) | 0.5
Geometric error
Approximate angular error, small angle (deg) | 0.02
Error at corner due to roll (mm) | 7.5
Error at corner due to pitch (mm) | 10.0
Total error at corner due to wiggle (mm) | 17.5
Binding
Max static friction caused by table deadweight (N) | 137.070225
Self-locking under worst-case scenario? | TRUE | F_f = (mu*W*L_t)/(2*L_b) | F_f > (P+W)/2

Sheet: Actuation
Belt/chain drive
Belt attachment point offset from center of bearing (mm) | 25
Belt attachment angle, alpha (deg) | 0
Actuation force (N) | 5000
Effective reduction required (x) | 158.0246914
Sufficient force to move down under worst-case scenario? | 4784.050875
Motor Specifications
Holding torque (Nmm) | 450
Pullout torque (Nmm) | 337.5 | Estimated as 75% holding torque, need to find torque curve/test
Efficiency | 0.75
Designed operating torque (Nmm) | 253.125 | 75% of pullout torque for safety factor + thermal stability
Output shaft diameter (mm) | 8
Simple Conservation of Energy Calculation
Payload weight (N) | 241.890075

Sheet: Structure
Inputs
Table width, W_t (mm) | 750 | Material | Densities (kg/m^3) | Source
Table depth, D_t (mm) | 500 | Plywood | 690 | http://www.plywoodeurope.com/plywood-density.html
Table thickness, T_t (mm) | 18
Table mass, M_t (kg) | 4.7
Table weight, F_w,t (N) | 45.690075

Sheet: Load Configurations
Live Load
Designed distributed load (N) | 147.15
Designed point load (N) | 49.05

Sheet: Edit History
Event # | Date: | By: | Summary of edits made
1 | 2016-03-18 | Alex Slocum | Formatting to be more clear
2 | 2017-02-27 | Shien Yang Lee | Specify allowable errors for desk
3 | 2017-03-10 | Shien Yang Lee | Populate binding and self-locking formulae
4 | 2017-03-10 | Shien Yang Lee | Add actuator and load configuration
