tjankovic/2-77-ppd/design_spreadsheets/Error Budgets/error_budget_spreadsheet_twin_column.xlsx

Sheet: Summary
Error_Budget_Spreadsheet.xls
Suumary of Results
Written by Aex Slocum 2015.08.30, last edit 2016.05.24 by AHS |  |  |  |  |  |  |  | For servo axes, cells give value to servo motions, & corresponding coordinates of axes in worksheet "Axes' CS and Loads" are to be driven by these values
Last edit: | 2017.05.14 | By: | Shien Yang Lee | Please enter edits in "Edit History" Worksheet
Inputs in BLACK in Yellow background cells: |  | Input | BE CONSISTANT WITH UNITS!
Outputs in RED in Green background cells: |  | Output |  |  |  |  |  | User enter servo axes:
Axes' coordinates and applied loads are defined in worksheet "Axes' CS & Loads" |  |  |  |  |  |  |  | Name | Axis | position | offset from CS origin | Extra length of actuator for mounting
Axes' coordinates and applied loads are defined in worksheet "Axes' CS & Loads" |  |  |  |  |  |  |  | Z servo | 3 | 0 | 50 | 125
 |  |  |  |  |  |  |  |  |  |  |  |  | NOTE: because Z axis has bearing blocks fixed to Y carriage.
All Axes | For the Entire Machine
 | Number of axes | All axes' Geometric Errors |  |  |  | F=kX displacement
 | 5 | Random |  |  | Systematic
 |  | Sum | RSS | Avg(SUM, RSS) | Sum | Sum
 | deltaX | 1.6 | 1.1 | 1.3 | 0.0 | 0.01725920366
 | deltaY | 1.7 | 1.2 | 1.5 | 0.0 | 0.4
 | deltaZ | 2.8 | 1.9 | 2.3 | 0.0 | -2.5
 | Vector displacement | 3.6 | 2.5 | 3.0 | 0.0 | 2.5
Axis | Table | Geometric Errors |  | F=kX displacement
1 |  | Random | Systematic |  | Random Geometric Errors at point of interest in final (ref) CS |  |  |  |  | Systematic Geometric Errors at point of interest in final (ref) CS |  |  |  |  | F=kx Displacements at point of interest in final (ref) CS
Axis on? |  | Avg(SUM, RSS) | Sum | Sum |  | Pure translation | By epsx gain | By epsy gain | By epsz gain |  | Pure translation | By epsx gain | By epsy gain | By epsz gain |  | Pure translation | By epsx gain | By epsy gain | By epsz gain
yes | deltaX | 0.380348 | 0.000000 | -0.000001 | deltaX | 0.050000 | 0.000000 | 0.000009 | 0.353585 | deltaX | 0.000000 | 0.000000 | 0.000000 | 0.000000 | deltaX | 0.000000 | 0.000000 | -0.000001 | 0.000000
1 | deltaY | 0.486615 | 0.000000 | 0.000054 | deltaY | 0.050000 | 0.000250 | 0.000000 | 0.460136 | deltaY | 0.000000 | 0.000000 | 0.000000 | 0.000000 | deltaY | 0.000000 | 0.000054 | 0.000000 | 0.000000
 | deltaZ | 0.535241 | 0.000000 | -0.855575 | deltaZ | 0.050000 | 0.500000 | 0.017678 | 0.000000 | deltaZ | 0.000000 | 0.000000 | 0.000000 | 0.000000 | deltaZ | -0.745889 | -0.107419 | -0.002268 | 0.000000
Axis | Bracket | Geometric Errors |  | F=kX displacement
2 |  | Random | Systematic |  | Random Geometric Errors at point of interest in final (ref) CS |  |  |  |  | Systematic Geometric Errors at point of interest in final (ref) CS |  |  |  |  | F=kx Displacements at point of interest in final (ref) CS
Axis on? |  | Avg(SUM, RSS) | Sum | Sum |  | Pure translation | By epsx gain | By epsy gain | By epsz gain |  | Pure translation | By epsx gain | By epsy gain | By epsz gain |  | Pure translation | By epsx gain | By epsy gain | By epsz gain
yes | deltaX | 0.023005 | 0.000000 | 0.001848 | deltaX | 0.010000 | 0.000000 | 0.016617 | 0.000000 | deltaX | 0.000000 | 0.000000 | 0.000000 | 0.000000 | deltaX | 0.000000 | 0.000000 | 0.001848 | 0.000000
1 | deltaY | 0.023013 | 0.000000 | -0.001590 | deltaY | 0.010000 | 0.016625 | 0.000000 | 0.000000 | deltaY | 0.000000 | 0.000000 | 0.000000 | 0.000000 | deltaY | 0.000000 | -0.001590 | 0.000000 | 0.000000
 | deltaZ | 0.161958 | 0.000000 | -0.021538 | deltaZ | 0.010000 | 0.083342 | 0.100008 | 0.000000 | deltaZ | 0.000000 | 0.000000 | 0.000000 | 0.000000 | deltaZ | -0.002449 | -0.007969 | -0.011120 | 0.000000
Axis | Z-bearing | Geometric Errors |  | F=kX displacement
3 |  | Random | Systematic |  | Random Geometric Errors at point of interest in final (ref) CS |  |  |  |  | Systematic Geometric Errors at point of interest in final (ref) CS |  |  |  |  | F=kx Displacements at point of interest in final (ref) CS
Axis on? |  | Avg(SUM, RSS) | Sum | Sum |  | Pure translation | By epsx gain | By epsy gain | By epsz gain |  | Pure translation | By epsx gain | By epsy gain | By epsz gain |  | Pure translation | By epsx gain | By epsy gain | By epsz gain
yes | deltaX | 0.989629 | 0.000000 | 0.055025 | deltaX | 0.220000 | 0.000000 | 0.155512 | 0.779244 | deltaX | 0.000000 | 0.000000 | 0.000000 | 0.000000 | deltaX | 0.000000 | 0.000000 | 0.055025 | 0.000000
1 | deltaY | 1.089894 | 0.000000 | -0.010064 | deltaY | 0.220000 | 0.219450 | 0.000000 | 0.842428 | deltaY | 0.000000 | 0.000000 | 0.000000 | 0.000000 | deltaY | 0.000000 | -0.010064 | 0.000000 | 0.000000
 | deltaZ | 1.782505 | 0.000000 | -0.391214 | deltaZ | 0.220000 | 1.100110 | 0.842116 | 0.000000 | deltaZ | 0.000000 | 0.000000 | 0.000000 | 0.000000 | deltaZ | -0.042797 | -0.050451 | -0.297966 | 0.000000
Axis | Column | Geometric Errors |  | F=kX displacement
4 |  | Random | Systematic |  | Random Geometric Errors at point of interest in final (ref) CS |  |  |  |  | Systematic Geometric Errors at point of interest in final (ref) CS |  |  |  |  | F=kx Displacements at point of interest in final (ref) CS
Axis on? |  | Avg(SUM, RSS) | Sum | Sum |  | Pure translation | By epsx gain | By epsy gain | By epsz gain |  | Pure translation | By epsx gain | By epsy gain | By epsz gain |  | Pure translation | By epsx gain | By epsy gain | By epsz gain
yes | deltaX | 0.128203 | 0.000000 | -0.039208 | deltaX | 0.010000 | 0.000000 | 0.091207 | 0.050478 | deltaX | 0.000000 | 0.000000 | 0.000000 | 0.000000 | deltaX | -0.023571 | 0.000000 | -0.015637 | 0.000000
1 | deltaY | 0.075408 | 0.000000 | 0.397054 | deltaY | 0.010000 | 0.025278 | 0.000000 | 0.054571 | deltaY | 0.000000 | 0.000000 | 0.000000 | 0.000000 | deltaY | 0.012564 | 0.384489 | 0.000000 | 0.000000
 | deltaZ | 0.230306 | 0.000000 | -0.802626 | deltaZ | 0.010000 | 0.050492 | 0.196749 | 0.000000 | deltaZ | 0.000000 | 0.000000 | 0.000000 | 0.000000 | deltaZ | -0.000876 | -0.768018 | -0.033732 | 0.000000
Axis | Leg | Geometric Errors |  | F=kX displacement
5 |  | Random | Systematic |  | Random Geometric Errors at point of interest in final (ref) CS |  |  |  |  | Systematic Geometric Errors at point of interest in final (ref) CS |  |  |  |  | F=kx Displacements at point of interest in final (ref) CS
Axis on? |  | Avg(SUM, RSS) | Sum | Sum |  | Pure translation | By epsx gain | By epsy gain | By epsz gain |  | Pure translation | By epsx gain | By epsy gain | By epsz gain |  | Pure translation | By epsx gain | By epsy gain | By epsz gain
yes | deltaX | 0.031002 | 0.000000 | -0.000404 | deltaX | 0.010000 | 0.000000 | 0.025027 | 0.000027 | deltaX | 0.000000 | 0.000000 | 0.000000 | 0.000000 | deltaX | 0.000000 | 0.000000 | -0.000404 | 0.000000
1 | deltaY | 0.074670 | 0.000000 | 0.000131 | deltaY | 0.010000 | 0.025000 | 0.000000 | 0.054000 | deltaY | 0.000000 | 0.000000 | 0.000000 | 0.000000 | deltaY | 0.000000 | 0.000131 | 0.000000 | 0.000000
 | deltaZ | 0.059453 | 0.000000 | -0.421805 | deltaZ | 0.010000 | 0.000012 | 0.053987 | 0.000000 | deltaZ | 0.000000 | 0.000000 | 0.000000 | 0.000000 | deltaZ | -0.420934 | 6.563942626e-08 | -0.000871 | 0.000000
Axis | X-axis | Geometric Errors |  | F=kX displacement
6 |  | Random | Systematic |  | Random Geometric Errors at point of interest in final (ref) CS |  |  |  |  | Systematic Geometric Errors at point of interest in final (ref) CS |  |  |  |  | F=kx Displacements at point of interest in final (ref) CS
Axis on? |  | Avg(SUM, RSS) | Sum | Sum |  | Pure translation | By epsx gain | By epsy gain | By epsz gain |  | Pure translation | By epsx gain | By epsy gain | By epsz gain |  | Pure translation | By epsx gain | By epsy gain | By epsz gain
no | deltaX | 0.015501 | 0.000000 | -0.000248 | deltaX | 0.005000 | 0.000000 | 0.012513 | 0.000013 | deltaX | 0.000000 | 0.000000 | 0.000000 | 0.000000 | deltaX | 0.000974 | 0.000000 | -0.001223 | 0.000000
0 | deltaY | 0.037335 | 0.000000 | 0.000350 | deltaY | 0.005000 | 0.012500 | 0.000000 | 0.027000 | deltaY | 0.000000 | 0.000000 | 0.000000 | 0.000000 | deltaY | 0.000159 | 0.000191 | 0.000000 | 0.000000
 | deltaZ | 0.029726 | 0.000000 | -0.002793 | deltaZ | 0.005000 | 0.000006 | 0.026994 | 0.000000 | deltaZ | 0.000000 | 0.000000 | 0.000000 | 0.000000 | deltaZ | -0.000155 | 9.552240318e-08 | -0.002638 | 0.000000
Axis | Bed & Frame | Geometric Errors |  | F=kX displacement
7 |  | Random | Systematic |  | Random Geometric Errors at point of interest in final (ref) CS |  |  |  |  | Systematic Geometric Errors at point of interest in final (ref) CS |  |  |  |  | F=kx Displacements at point of interest in final (ref) CS
Axis on? |  | Avg(SUM, RSS) | Sum | Sum |  | Pure translation | By epsx gain | By epsy gain | By epsz gain |  | Pure translation | By epsx gain | By epsy gain | By epsz gain |  | Pure translation | By epsx gain | By epsy gain | By epsz gain
no | deltaX | 0.005000 | 0.000000 | 0.000000 | deltaX | 0.005000 | 0.000000 | 0.000000 | 0.000000 | deltaX | 0.000000 | 0.000000 | 0.000000 | 0.000000 | deltaX | 0.000000 | 0.000000 | 0.000000 | 0.000000
0 | deltaY | 0.005000 | 0.000000 | 0.000000 | deltaY | 0.005000 | 0.000000 | 0.000000 | 0.000000 | deltaY | 0.000000 | 0.000000 | 0.000000 | 0.000000 | deltaY | 0.000000 | 0.000000 | 0.000000 | 0.000000
 | deltaZ | 0.005000 | 0.000000 | -0.001759 | deltaZ | 0.005000 | 0.000000 | 0.000000 | 0.000000 | deltaZ | 0.000000 | 0.000000 | 0.000000 | 0.000000 | deltaZ | -0.001759 | 0.000000 | 0.000000 | 0.000000
Axis | Thing 8 | Geometric Errors |  | F=kX displacement
8 |  | Random | Systematic |  | Random Geometric Errors at point of interest in final (ref) CS |  |  |  |  | Systematic Geometric Errors at point of interest in final (ref) CS |  |  |  |  | F=kx Displacements at point of interest in final (ref) CS
Axis on? |  | Avg(SUM, RSS) | Sum | Sum |  | Pure translation | By epsx gain | By epsy gain | By epsz gain |  | Pure translation | By epsx gain | By epsy gain | By epsz gain |  | Pure translation | By epsx gain | By epsy gain | By epsz gain
no | deltaX | 0.005000 | 0.000000 | 0.000000 | deltaX | 0.005000 | 0.000000 | 0.000000 | 0.000000 | deltaX | 0.000000 | 0.000000 | 0.000000 | 0.000000 | deltaX | 0.000000 | 0.000000 | 0.000000 | 0.000000
0 | deltaY | 0.005000 | 0.000000 | 0.000000 | deltaY | 0.005000 | 0.000000 | 0.000000 | 0.000000 | deltaY | 0.000000 | 0.000000 | 0.000000 | 0.000000 | deltaY | 0.000000 | 0.000000 | 0.000000 | 0.000000
 | deltaZ | 0.005000 | 0.000000 | -0.000092 | deltaZ | 0.005000 | 0.000000 | 0.000000 | 0.000000 | deltaZ | 0.000000 | 0.000000 | 0.000000 | 0.000000 | deltaZ | -0.000092 | 0.000000 | 0.000000 | 0.000000
Axis | Thing 9 | Geometric Errors |  | F=kX displacement
9 |  | Random | Systematic |  | Random Geometric Errors at point of interest in final (ref) CS |  |  |  |  | Systematic Geometric Errors at point of interest in final (ref) CS |  |  |  |  | F=kx Displacements at point of interest in final (ref) CS
Axis on? |  | Avg(SUM, RSS) | Sum | Sum |  | Pure translation | By epsx gain | By epsy gain | By epsz gain |  | Pure translation | By epsx gain | By epsy gain | By epsz gain |  | Pure translation | By epsx gain | By epsy gain | By epsz gain
no | deltaX | 0.005001 | 0.000000 | -1.809489474e-09 | deltaX | 0.005000 | 0.000000 | 4.999999532e-07 | 4.999999582e-07 | deltaX | 0.000000 | 0.000000 | 0.000000 | 0.000000 | deltaX | 0.000000 | 0.000000 | -1.809489474e-09 | 0.000000
0 | deltaY | 0.005550 | 0.000000 | 0.000000 | deltaY | 0.005000 | 0.000000 | 0.000000 | 0.001000 | deltaY | 0.000000 | 0.000000 | 0.000000 | 0.000000 | deltaY | 0.000000 | 0.000000 | 0.000000 | 0.000000
 | deltaZ | 0.005550 | 0.000000 | -0.000096 | deltaZ | 0.005000 | 0.000000 | 0.001000 | 0.000000 | deltaZ | 0.000000 | 0.000000 | 0.000000 | 0.000000 | deltaZ | -0.000092 | 0.000000 | -0.000004 | 0.000000
Axis | Thing 10 | Geometric Errors |  | F=kX displacement
10 |  | Random | Systematic |  | Random Geometric Errors at point of interest in final (ref) CS |  |  |  |  | Systematic Geometric Errors at point of interest in final (ref) CS |  |  |  |  | F=kx Displacements at point of interest in final (ref) CS
Axis on? |  | Avg(SUM, RSS) | Sum | Sum |  | Pure translation | By epsx gain | By epsy gain | By epsz gain |  | Pure translation | By epsx gain | By epsy gain | By epsz gain |  | Pure translation | By epsx gain | By epsy gain | By epsz gain
no | deltaX | 0.005001 | 0.000000 | -7.237957898e-09 | deltaX | 0.005000 | 0.000000 | 0.000001 | 0.000001 | deltaX | 0.000000 | 0.000000 | 0.000000 | 0.000000 | deltaX | 0.000000 | 0.000000 | -7.237957898e-09 | 0.000000
0 | deltaY | 0.006193 | 0.000000 | 0.000000 | deltaY | 0.005000 | 0.000000 | 0.000000 | 0.002000 | deltaY | 0.000000 | 0.000000 | 0.000000 | 0.000000 | deltaY | 0.000000 | 0.000000 | 0.000000 | 0.000000
 | deltaZ | 0.006193 | 0.000000 | -0.000107 | deltaZ | 0.005000 | 0.000000 | 0.002000 | 0.000000 | deltaZ | 0.000000 | 0.000000 | 0.000000 | 0.000000 | deltaZ | -0.000092 | 0.000000 | -0.000014 | 0.000000

Sheet: CSs and Loads
Error Budget Spreadsheet
Axes' Coordinate Systems and Loads Applied
Written by Aex Slocum 2015.08.30
Inputs in BLACK in Yellow background cells: |  | Input
Outputs in RED in Green background cells: |  | Output
Axes' coordinates and applied loads are defined in worksheet "Axes' CS & Loads"
Axes' coordinates and applied loads are defined in worksheet "Axes' CS & Loads"
Number of axes used (NOT including reference frame), Naxes |  | 5 | Note that axes beyond this number are automatically "turned off"
 | NOTE axis 1 is the axis (structure) that HOLDS the tool, it doe NOT have to be located at tool point)
CS 1 | Coordinates of point of interest (POI) in this CS (0,0,0 is at CS center of stiffness) |  |  | Error motions of CS Origin along & about its axes. Values from Axis_1 worksheet
 | X coordinate of point of interest in this CS | -325 |  | Random Geometric Errors |  | Systematic Geometric Errors |  |  |  |  |  |  | Random Errors at point of interest in current CS |  |  |  |  | Random Geometric Errors at point of interest in final (ref) CS |  |  |  |  |  | F=kx=attachment defl+structural defl at POI in current CS
 | Y coordinate of point of interest in CS | 250 |  | deltaX | 0.050000 | deltaX | 0.000000 |  |  |  |  |  |  | Pure translation | By epsx gain | By epsy gain | By epsz gain |  | Pure translation | By epsx gain | By epsy gain | By epsz gain |  | Pure translation | By epsx gain | By epsy gain | By epsz gain
 | Z coordinate of point of interest in CS | 0 |  | deltaY | 0.050000 | deltaY | 0.000000 |  |  |  |  |  | deltaX | 0.050000 | 0.000000 | 0.000009 | 0.353585 | deltaX | 0.050000 | 0.000000 | 0.000009 | 0.353585 | deltaX | 0.000000 | 0 | -1.133877693e-06 | 0
1 | Coordinates of this CS in the next CS |  |  | deltaZ | 0.050000 | deltaZ | 0.000000 |  |  |  |  |  | deltaY | 0.050000 | 0.000250 | 0.000000 | 0.460136 | deltaY | 0.050000 | 0.000250 | 0.000000 | 0.460136 | deltaY | 0.000000 | 5.37093093e-05 | 0 | 0
1 | Rotation about this CS's X axis to align Y axes (degrees) | 0 |  | EpsilonX | 0.002000 | EpsilonX | 0.000000 |  |  |  |  |  | deltaZ | 0.050000 | 0.500000 | 0.017678 | 0.000000 | deltaZ | 0.050000 | 0.500000 | 0.017678 | 0.000000 | deltaZ | -0.745889 | -0.1074186096 | -0.002267755198 | 0
Enter name below | Rotation about resulting Y axis to align axes (degrees) | 0 |  | EpsilonY | 0.000054 | EpsilonY | 0.000000 |  |  |  |  |  | unity | 1 | 1 | 1 | 1 | unity | 1.000000 | 1.000000 | 1.000000 | 1.000000 | unity | 1 | 1 | 1 | 1 |  | 1.000000 | 0.000000 | 0.000000 | 0.000000 | 1.000000 | 0.000000 | 0.001000 | 0.000000 | 1.000000 | -0.001000 | 0.000000 | 0.000000
 | rotation about resulting Z axis to align axes (degrees) | 0 | where is CS 1's origin in CS 2? | EpsilonZ | 0.001415 | EpsilonZ | 0.000000 |  |  |  |  |  |  |  |  |  |  |  |  |  |  |  |  |  |  |  |  |  | 0.000000 | 1.000000 | -0.001000 | 0.000000 | 0.000000 | 1.000000 | 0.000000 | 0.000000 | 0.001000 | 1.000000 | 0.000000 | 0.000000
 | X translation of this CS's origin along next CS's X axis | 25 |  | This CS origin F=kx Displacements + structural angular displ from next CS |  | Stiffness of this CS origin wrt its axes |  | Next CS CS Origin structural angular displ |  | Next CS CS Origin structural angular displ in this CS |  |  | Systematic Errors at point of interest in current CS |  |  |  |  | Systematic Geometric Errors at point of interest in final (ref) CS |  |  |  |  |  | F=kx=attachment defl+structural defl at POI in final (ref) CS |  |  |  |  | 0.000000 | 0.001000 | 1.000000 | 0.000000 | -0.001000 | 0.000000 | 1.000000 | 0.000000 | 0.000000 | 0.000000 | 1.000000 | 0.000000
 | Y translation of aligned CS along next CS's Y axis | 0 |  | deltaX | 0.000000 | KX | 2312800 | EpsilonX | -0.000385 | EpsilonX | -0.000385212452 |  |  | Pure translation | By epsx gain | By epsy gain | By epsz gain |  | Pure translation | By epsx gain | By epsy gain | By epsz gain |  | Pure translation | By epsx gain | By epsy gain | By epsz gain |  | 0.000000 | 0.000000 | 0.000000 | 1.000000 | 0.000000 | 0.000000 | 0.000000 | 1.000000 | 0.000000 | 0.000000 | 0.000000 | 1.000000
Table | Z translation of aligned CS along next CS's Z axis | -50 |  | deltaY | 0.000000 | KY | 2319135.545 | EpsilonY | -0.000007 | EpsilonY | -6.818754542e-06 |  | deltaX | 0.000000 | 0.000000 | 0.000000 | 0.000000 | deltaX | 0.000000 | 0.000000 | 0.000000 | 0.000000 | deltaX | 0 | 0 | -1.133877693e-06 | 0
 | Resulting coordintes of point of interest in the next CS |  |  | deltaZ | -0.000103 | KZ | 2312800 | EpsilonZ | 0.000000 | EpsilonZ | 0 |  | deltaY | 0.000000 | 0.000000 | 0.000000 | 0.000000 | deltaY | 0.000000 | 0.000000 | 0.000000 | 0.000000 | deltaY | 0 | 5.37093093e-05 | 0 | 0
 | X coordinate of point of interest in next CS | -300.000 |  | EpsilonX | -0.000430 | KrotX | 1580291667 | Unity | 1 | Unity | 1 |  | deltaZ | 0.000000 | 0.000000 | 0.000000 | 0.000000 | deltaZ | 0.000000 | 0.000000 | 0.000000 | 0.000000 | deltaZ | -0.7458889976 | -0.1074186096 | -0.002267755198 | 0
 | Y coordinate of point of interest in next CS | 250.000 |  | EpsilonY | -0.000007 | KrotY | 4.887137917e+11 |  |  |  |  |  | unity | 1 | 1 | 1 | 1 | unity | 1 | 1 | 1 | 1 | unity | 1 | 1 | 1 | 1
 | Z coordinate of point of interest in next CS | -50.000 |  | EpsilonZ | 0.000000 | KrotZ | 490428875000 |  |  |  |  |  |  |  |  |  |  |  |  |  |  |  |  |  |  |  |  |  |  |  |  |  |  |  |  |  |  |  |  |  |  | Position, error, & error gain of tool tip due to epsx |  |  |  | Position, error, & error gain of tool tip due to epsY |  |  |  | Position, error, & error gain of tool tip due to epsZ
 | Applied loads at point of interest in this axis' CS |  |  | This CS POI F=kx structural displacements |  | POI displacements = Structure compliance matrix * Force & Moment at POI |  |  |  |  |  | POI's F's & M's | Error gain matrix: rotational errors' effects (at this CS origin) on point of interest |  |  |  |  |  |  |  |  |  |  |  |  |  |  |  | HTM for epsX = | 0.001 |  |  | HTM for epsY = 0.001 | 0.001 |  |  | HTM for epsZ = | 0.001 |  |  |  | position | error | error gain |  | position | error | error gain |  | position | error | error gain
 | Fx= | 0 |  | deltaX | 0.000000 | -3.628033295e-06 | 0 | 0 | 0 | 0 | 0 | 0 |  | epsx's gains | epsy's gains | epsz's gains |  |  |  |  |  |  |  |  |  |  | X in CS_N-1 | -325 | 1.000000 | 0.000000 | 0.000000 | 0.000000 | 1.000000 | 0.000000 | 0.001000 | 0.000000 | 1.000000 | -0.001000 | 0.000000 | 0.000000 | x | -325.000000 | 0.000000 | 0.000000 | x | -324.999838 | 0.000162 | 0.162500 | x | -325.249837 | -0.249837 | -249.837458
 | Fy= | 0 |  | deltaY | 0.000000 | 0 | 4.664614236e-08 | 0 | 0 | 0 | 0 | 0 | deltaX | 0.000 | 0.162 | -249.837 |  |  |  |  |  |  |  |  |  |  | Y in CS_N-1 | 250 | 0.000000 | 1.000000 | -0.001000 | 0.000000 | 0.000000 | 1.000000 | 0.000000 | 0.000000 | 0.001000 | 1.000000 | 0.000000 | 0.000000 | y | 249.999875 | -0.000125 | -0.125000 | y | 250.000000 | 0.000000 | 0.000000 | y | 249.674875 | -0.325125 | -325.124946
 | Fz= | -239.02604 |  | deltaZ | -0.745786 | 0 | 0 | 0.002743420238 | 8.569617571e-06 | 0 | 0 | -239.02604 | deltaY | -0.125 | 0.000 | -325.125 |  |  |  |  |  |  |  |  |  |  | Z in CS_N-1 | 0 | 0.000000 | 0.001000 | 1.000000 | 0.000000 | -0.001000 | 0.000000 | 1.000000 | 0.000000 | 0.000000 | 0.000000 | 1.000000 | 0.000000 | z | 0.250000 | 0.250000 | 249.999958 | z | 0.325000 | 0.325000 | 324.999946 | z | 0.000000 | 0.000000 | 0.000000
 | unity | 1 |  | EpsilonX | -0.002044 | 0 | 0 | 8.569617571e-06 | -4.487141098e-10 | 0 | 0 | -10506.51 | deltaZ | 250.000 | 325.000 | 0.000 |  |  |  |  |  |  |  |  |  |  |  | 1 | 0.000000 | 0.000000 | 0.000000 | 1.000000 | 0.000000 | 0.000000 | 0.000000 | 1.000000 | 0.000000 | 0.000000 | 0.000000 | 1.000000 |  | 1.000000 |  |  |  | 1.000000 |  |  |  | 1.000000
 | Mx= | -10506.51 |  | EpsilonY | 0.000000 | 0 | 0 | 0 | 0 | 2.239526725e-08 | 0 | 0 |  | HTM Rotation matrix to align this CS with the next CS |  |  |  |  | HTM Rotation matrix to align this CS with final (ref) CS |  |  |  |  |  |  |  |  |  | HTM for ThetaX user specified orientation |  |  |  | HTM for ThetaY user specified orientation |  |  |  | HTM for ThetaZ user specified orientation
 | My= | 0 |  | EpsilonZ | 0.000000 | 0 | 0 | 0 | 0 | 0 | 3.807848356e-13 | 0 |  | 1.000 | 0.000 | 0.000 | 0.000 |  | 1.000 | 0.000 | 0.000 | 0.000 |  |  |  |  | X in CS_N | -325 | 1 | 0 | 0 | 0 | 1 | 0 | 0 | 0 | 1 | 0 | 0 | 0
 | Mz= | 0 |  |  |  |  |  |  |  |  |  |  |  | 0.000 | 1.000 | 0.000 | 0.000 |  | 0.000 | 1.000 | 0.000 | 0.000 |  |  |  |  | Y in CS_N | 250 | 0 | 1 | 0 | 0 | 0 | 1 | 0 | 0 | 0 | 1 | 0 | 0
 | unity | 1 |  |  |  |  |  |  |  |  |  |  |  | 0.000 | 0.000 | 1.000 | 0.000 |  | 0.000 | 0.000 | 1.000 | 0.000 |  |  |  |  | Z in CS_N | 0 | 0 | 0 | 1 | 0 | 0 | 0 | 1 | 0 | 0 | 0 | 1 | 0
 | Applied loads at Center of Stiffness in this axis' CS |  | Resulting loads at this CS Center of Stiffness |  |  |  |  |  |  |  |  |  |  | 0.000 | 0.000 | 0.000 | 1.000 |  | 0.000 | 0.000 | 0.000 | 1.000 |  |  |  |  |  | 1 | 0 | 0 | 0 | 1 | 0 | 0 | 0 | 1 | 0 | 0 | 0 | 1
 | Fx= | 0 | Fx= | 0
 | Fy= | 0 | Fy= | 0
 | Fz= | 0 | Fz= | -239.02604
 | unity | 1 | unity | 1
 | Mx= | 0 | Mx= | -70263.02
 | My= | 0 | My= | -77683.463
 | Mz= | 0 | Mz= | 0
 | unity | 1 | unity | 1
CS 2 | Coordinates of previous axis CS origin becomes the point of interest (POI) in present CS |  |  | Error motions of CS Origin along & about its axes. Values from Axis_2 worksheet
 | X coordinate of point of interest in this CS | -300.000 |  | Random Geometric Errors |  | Systematic Geometric Errors |  |  |  |  |  |  | Random Errors at point of interest in current CS |  |  |  |  | Random Geometric Errors at point of interest in final (ref) CS |  |  |  |  |  | F=kx=attachment defl+structural defl at POI in current CS
 | Y coordinate of point of interest in CS | 250.000 |  | deltaX | 0.010000 | deltaX | 0.000000 |  |  |  |  |  |  | Pure translation | By epsx gain | By epsy gain | By epsz gain |  | Pure translation | By epsx gain | By epsy gain | By epsz gain |  | Pure translation | By epsx gain | By epsy gain | By epsz gain
 | Z coordinate of point of interest in CS | -50.000 |  | deltaY | 0.010000 | deltaY | 0.000000 |  |  |  |  |  | deltaX | 0.010000 | 0.000000 | 0.016617 | 0.000000 | deltaX | 0.010000 | 0.000000 | 0.016617 | 0.000000 | deltaX | 0.000000 | 0 | 0.001847554904 | 0
2 | Coordinates of this CS in the next CS |  |  | deltaZ | 0.010000 | deltaZ | 0.000000 |  |  |  |  |  | deltaY | 0.010000 | 0.016625 | 0.000000 | 0.000000 | deltaY | 0.010000 | 0.016625 | 0.000000 | 0.000000 | deltaY | 0.000000 | -0.001589732935 | 0 | 0
1 | Rotation about this CS's X axis to align Y axes (degrees) | 0 |  | EpsilonX | 0.000333 | EpsilonX | 0.000000 |  |  |  |  |  | deltaZ | 0.010000 | 0.083342 | 0.100008 | 0.000000 | deltaZ | 0.010000 | 0.083342 | 0.100008 | 0.000000 | deltaZ | -0.002449 | -0.007969382999 | -0.01111961204 | 0
Enter name below | Rotation about resulting Y axis to align axes (degrees) | 0 |  | EpsilonY | 0.000333 | EpsilonY | 0.000000 |  |  |  |  |  | unity | 1 | 1 | 1 | 1 | unity | 1.000000 | 1.000000 | 1.000000 | 1.000000 | unity | 1 | 1 | 1 | 1
 | rotation about resulting Z axis to align axes (degrees) | 0 |  | EpsilonZ | 0.000000 | EpsilonZ | 0.000000
 | X translation of this CS's origin along next CS's X axis | 30 |  | This CS origin F=kx Displacements + structural angular displ from next CS |  | Stiffness of this CS origin wrt its axes |  | Next CS CS Origin structural angular displ |  | Next CS CS Origin structural angular displ in this CS |  |  | Systematic Errors at point of interest in current CS |  |  |  |  | Systematic Geometric Errors at point of interest in final (ref) CS |  |  |  |  |  | F=kx=attachment defl+structural defl at POI in final (ref) CS
 | Y translation of aligned CS along next CS's Y axis | 0 |  | deltaX | 0.000000 | KX | 2000000 | EpsilonX | 0.000000 | EpsilonX | 0 |  |  | Pure translation | By epsx gain | By epsy gain | By epsz gain |  | Pure translation | By epsx gain | By epsy gain | By epsz gain |  | Pure translation | By epsx gain | By epsy gain | By epsz gain
Bracket | Z translation of aligned CS along next CS's Z axis | 0 |  | deltaY | 0.000000 | KY | 2000000 | EpsilonY | 0.000000 | EpsilonY | 0 |  | deltaX | 0.000000 | 0.000000 | 0.000000 | 0.000000 | deltaX | 0.000000 | 0.000000 | 0.000000 | 0.000000 | deltaX | 0 | 0 | 0.001847554904 | 0
 | Resulting coordintes of point of interest in the next CS |  |  | deltaZ | -0.000120 | KZ | 2000000 | EpsilonZ | 0.000000 | EpsilonZ | 0 |  | deltaY | 0.000000 | 0.000000 | 0.000000 | 0.000000 | deltaY | 0.000000 | 0.000000 | 0.000000 | 0.000000 | deltaY | 0 | -0.001589732935 | 0 | 0
 | X coordinate of point of interest in next CS | -270.000 |  | EpsilonX | -0.000032 | KrotX | 2204375000 | Unity | 1 | Unity | 1 |  | deltaZ | 0.000000 | 0.000000 | 0.000000 | 0.000000 | deltaZ | 0.000000 | 0.000000 | 0.000000 | 0.000000 | deltaZ | -0.002449254155 | -0.007969382999 | -0.01111961204 | 0
 | Y coordinate of point of interest in next CS | 250.000 |  | EpsilonY | -0.000037 | KrotY | 1934791667 |  |  |  |  |  | unity | 1 | 1 | 1 | 1 | unity | 1 | 1 | 1 | 1 | unity | 1 | 1 | 1 | 1
 | Z coordinate of point of interest in next CS | -50.000 |  | EpsilonZ | 0.000000 | KrotZ | 134791666.7 |  |  |  |  |  |  |  |  |  |  |  |  |  |  |  |  |  |  |  |  |  |  |  |  |  |  |  |  |  |  |  |  |  |  | Position, error, & error gain of tool tip due to epsx |  |  |  | Position, error, & error gain of tool tip due to epsY |  |  |  | Position, error, & error gain of tool tip due to epsZ
 | Loads from previous axes applied at previous axis CS origin but in present CS orientation |  |  | This CS POI F=kx structural displacements |  | POI displacements = Structure compliance matrix * Force & Moment at POI |  |  |  |  |  | POI's F's & M's | Error gain matrix: rotational errors' effects (at this CS origin) on point of interest |  |  |  |  |  |  |  |  |  |  |  |  |  |  |  | HTM for epsX = | 0.001 |  |  | HTM for epsY = 0.001 | 0.001 |  |  | HTM for epsZ = | 0.001 |  |  |  | position | error | error gain |  | position | error | error gain |  | position | error | error gain
 | Fx= | 0 |  | deltaX | 0.000000 | 6.709608159e-07 | 0 | 0 | 0 | 0 | 0 | 0 |  | epsx's gains | epsy's gains | epsz's gains |  |  |  |  |  |  |  |  |  |  | X in CS_N-1 | -300.0 | 1.000000 | 0.000000 | 0.000000 | 0.000000 | 1.000000 | 0.000000 | 0.001000 | 0.000000 | 1.000000 | -0.001000 | 0.000000 | 0.000000 | x | -300.000000 | 0.000000 | 0.000000 | x | -300.049850 | -0.049850 | -49.849992 | x | -300.249850 | -0.249850 | -249.849958
 | Fy= | 0 |  | deltaY | 0.000000 | 0 | 8.283466863e-07 | 0 | 0 | 0 | -4.970080118e-08 | 0 | deltaX | 0.000 | -49.850 | -249.850 |  |  |  |  |  |  |  |  |  |  | Y in CS_N-1 | 250 | 0.000000 | 1.000000 | -0.001000 | 0.000000 | 0.000000 | 1.000000 | 0.000000 | 0.000000 | 0.001000 | 1.000000 | 0.000000 | 0.000000 | y | 250.049875 | 0.049875 | 49.874992 | y | 250.000000 | 0.000000 | 0.000000 | y | 249.699875 | -0.300125 | -300.124950
 | Fz= | -239.02604 |  | deltaZ | -0.002330 | 0 | 0 | 4.754540929e-07 | 0 | 2.852724557e-08 | 0 | -239.02604 | deltaY | 49.875 | 0.000 | -300.125 |  |  |  |  |  |  |  |  |  |  | Z in CS_N-1 | -50 | 0.000000 | 0.001000 | 1.000000 | 0.000000 | -0.001000 | 0.000000 | 1.000000 | 0.000000 | 0.000000 | 0.000000 | 1.000000 | 0.000000 | z | -49.749975 | 0.250025 | 250.024958 | z | -49.699975 | 0.300025 | 300.024950 | z | -50.000000 | 0.000000 | 0.000000
 | unity | 1 |  | EpsilonX | -0.000385 | 0 | 0 | 0 | 5.48243517e-09 | 0 | 0 | -70263.02 | deltaZ | 250.025 | 300.025 | 0.000 |  |  |  |  |  |  |  |  |  |  |  | 1 | 0.000000 | 0.000000 | 0.000000 | 1.000000 | 0.000000 | 0.000000 | 0.000000 | 1.000000 | 0.000000 | 0.000000 | 0.000000 | 1.000000 |  | 1.000000 |  |  |  | 1.000000 |  |  |  | 1.000000
 | Mx= | -70263.02 |  | EpsilonY | -0.000007 | 0 | 0 | 2.852724557e-08 | 0 | 0 | 0 | -77683.463 |  | HTM Rotation matrix to align this CS with the next CS |  |  |  |  | HTM Rotation matrix to align this CS with final (ref) CS |  |  |  |  |  |  |  |  |  | HTM for ThetaX user specified orientation |  |  |  | HTM for ThetaY user specified orientation |  |  |  | HTM for ThetaZ user specified orientation
 | My= | -77683.463 |  | EpsilonZ | 0.000000 | 0 | -4.970080118e-08 | 0 | 0 | 0 | 3.976064094e-09 | 0 |  | 1.000 | 0.000 | 0.000 | 0.000 |  | 1.000 | 0.000 | 0.000 | 0.000 |  |  |  |  | X in CS_N | -300 | 1 | 0 | 0 | 0 | 1 | 0 | 0 | 0 | 1 | 0 | 0 | 0
 | Mz= | 0 |  |  |  |  |  |  |  |  |  |  |  | 0.000 | 1.000 | 0.000 | 0.000 |  | 0.000 | 1.000 | 0.000 | 0.000 |  |  |  |  | Y in CS_N | 250 | 0 | 1 | 0 | 0 | 0 | 1 | 0 | 0 | 0 | 1 | 0 | 0
 | unity | 1 |  |  |  |  |  |  |  |  |  |  |  | 0.000 | 0.000 | 1.000 | 0.000 |  | 0.000 | 0.000 | 1.000 | 0.000 |  |  |  |  | Z in CS_N | -50 | 0 | 0 | 1 | 0 | 0 | 0 | 1 | 0 | 0 | 0 | 1 | 0
 | Applied loads loads at Center of Stiffness in this axis' CS |  | Resulting loads at this CS Center of Stiffness |  |  |  |  |  |  |  |  |  |  | 0.000 | 0.000 | 0.000 | 1.000 |  | 0.000 | 0.000 | 0.000 | 1.000 |  |  |  |  |  | 1 | 0 | 0 | 0 | 1 | 0 | 0 | 0 | 1 | 0 | 0 | 0 | 1
 | Fx= | 0 | Fx= | 0
 | Fy= | 0 | Fy= | 0
 | Fz= | 0 | Fz= | -239.02604
 | unity | 1 | unity | 1
 | Mx= | 0 | Mx= | -70263.02
 | My= | 0 | My= | -71707.812
 | Mz= | 0 | Mz= | 0
 | unity | 1 | unity | 1
CS 3 | Coordinates of previous axis CS origin becomes the point of interest (POI) in present CS |  |  | Error motions of CS Origin along & about its axes. Values from Axis_3 worksheet
 | X coordinate of point of interest in this CS | -270.000 |  | Random Geometric Errors |  | Systematic Geometric Errors |  |  |  |  |  |  | Random Errors at point of interest in current CS |  |  |  |  | Random Geometric Errors at point of interest in final (ref) CS |  |  |  |  |  | F=kx=attachment defl+structural defl at POI in current CS
 | Y coordinate of point of interest in CS | 250.000 |  | deltaX | 0.220000 | deltaX | 0.000000 |  |  |  |  |  |  | Pure translation | By epsx gain | By epsy gain | By epsz gain |  | Pure translation | By epsx gain | By epsy gain | By epsz gain |  | Pure translation | By epsx gain | By epsy gain | By epsz gain
 | Z coordinate of point of interest in CS | -50.000 |  | deltaY | 0.220000 | deltaY | 0.000000 |  |  |  |  |  | deltaX | 0.220000 | 0.000000 | 0.155512 | 0.779244 | deltaX | 0.220000 | 0.000000 | 0.155512 | 0.779244 | deltaX | 0.000000 | 0 | 0.05502482142 | 0
3 | Coordinates of this CS in the next CS |  |  | deltaZ | 0.220000 | deltaZ | 0.000000 |  |  |  |  |  | deltaY | 0.220000 | 0.219450 | 0.000000 | 0.842428 | deltaY | 0.220000 | 0.219450 | 0.000000 | 0.842428 | deltaY | 0.000000 | -0.01006394991 | 0 | 0
1 | Rotation about this CS's X axis to align Y axes (degrees) | 0 |  | EpsilonX | 0.004400 | EpsilonX | 0.000000 |  |  |  |  |  | deltaZ | 0.220000 | 1.100110 | 0.842116 | 0.000000 | deltaZ | 0.220000 | 1.100110 | 0.842116 | 0.000000 | deltaZ | -0.042797 | -0.0504509088 | -0.2979660565 | 0
Enter name below | Rotation about resulting Y axis to align axes (degrees) | 0 |  | EpsilonY | 0.003119 | EpsilonY | 0.000000 |  |  |  |  |  | unity | 1 | 1 | 1 | 1 | unity | 1.000000 | 1.000000 | 1.000000 | 1.000000 | unity | 1 | 1 | 1 | 1
 | rotation about resulting Z axis to align axes (degrees) | 0 |  | EpsilonZ | 0.003119 | EpsilonZ | 0.000000
 | X translation of this CS's origin along next CS's X axis | 0 |  | This CS origin F=kx Displacements + structural angular displ from next CS |  | Stiffness of this CS origin wrt its axes |  | Next CS CS Origin structural angular displ |  | Next CS CS Origin structural angular displ in this CS |  |  | Systematic Errors at point of interest in current CS |  |  |  |  | Systematic Geometric Errors at point of interest in final (ref) CS |  |  |  |  |  | F=kx=attachment defl+structural defl at POI in final (ref) CS
 | Y translation of aligned CS along next CS's Y axis | 0 |  | deltaX | 0.000000 | KX | 30136 | EpsilonX | -0.000144 | EpsilonX | -0.0001435934107 |  |  | Pure translation | By epsx gain | By epsy gain | By epsz gain |  | Pure translation | By epsx gain | By epsy gain | By epsz gain |  | Pure translation | By epsx gain | By epsy gain | By epsz gain
Z-bearing | Z translation of aligned CS along next CS's Z axis | 175 |  | deltaY | 0.000000 | KY | 482176 | EpsilonY | -0.000269 | EpsilonY | -0.0002693862 |  | deltaX | 0.000000 | 0.000000 | 0.000000 | 0.000000 | deltaX | 0.000000 | 0.000000 | 0.000000 | 0.000000 | deltaX | 0 | 0 | 0.05502482142 | 0
 | Resulting coordintes of point of interest in the next CS |  |  | deltaZ | -0.042797 | KZ | 5585.053606 | EpsilonZ | 0.000000 | EpsilonZ | 0 |  | deltaY | 0.000000 | 0.000000 | 0.000000 | 0.000000 | deltaY | 0.000000 | 0.000000 | 0.000000 | 0.000000 | deltaY | 0 | -0.01006394991 | 0 | 0
 | X coordinate of point of interest in next CS | -270.000 |  | EpsilonX | -0.000202 | KrotX | 1207474200 | Unity | 1 | Unity | 1 |  | deltaZ | 0.000000 | 0.000000 | 0.000000 | 0.000000 | deltaZ | 0.000000 | 0.000000 | 0.000000 | 0.000000 | deltaZ | -0.04279744777 | -0.0504509088 | -0.2979660565 | 0
 | Y coordinate of point of interest in next CS | 250.000 |  | EpsilonY | -0.001103 | KrotY | 77374200 |  |  |  |  |  | unity | 1 | 1 | 1 | 1 | unity | 1 | 1 | 1 | 1 | unity | 1 | 1 | 1 | 1
 | Z coordinate of point of interest in next CS | 125.000 |  | EpsilonZ | 0.000000 | KrotZ | 126949934200 |  |  |  |  |  |  |  |  |  |  |  |  |  |  |  |  |  |  |  |  |  |  |  |  |  |  |  |  |  |  |  |  |  |  | Position, error, & error gain of tool tip due to epsx |  |  |  | Position, error, & error gain of tool tip due to epsY |  |  |  | Position, error, & error gain of tool tip due to epsZ
 | Loads from previous axes applied at previous axis CS origin but in present CS orientation |  |  | This CS POI F=kx structural displacements |  | POI displacements = Structure compliance matrix * Force & Moment at POI |  |  |  |  |  | POI's F's & M's | Error gain matrix: rotational errors' effects (at this CS origin) on point of interest |  |  |  |  |  |  |  |  |  |  |  |  |  |  |  | HTM for epsX = | 0.001 |  |  | HTM for epsY = 0.001 | 0.001 |  |  | HTM for epsZ = | 0.001 |  |  |  | position | error | error gain |  | position | error | error gain |  | position | error | error gain
 | Fx= | 0 |  | deltaX | 0.000000 | 0 | 0 | 0 | 0 | 0 | 0 | 0 |  | epsx's gains | epsy's gains | epsz's gains |  |  |  |  |  |  |  |  |  |  | X in CS_N-1 | -270 | 1.000000 | 0.000000 | 0.000000 | 0.000000 | 1.000000 | 0.000000 | 0.001000 | 0.000000 | 1.000000 | -0.001000 | 0.000000 | 0.000000 | x | -270.000000 | 0.000000 | 0.000000 | x | -270.049865 | -0.049865 | -49.864992 | x | -270.249865 | -0.249865 | -249.864958
 | Fy= | 0 |  | deltaY | 0.000000 | 0 | 0 | 0 | 0 | 0 | 0 | 0 | deltaX | 0.000 | -49.865 | -249.865 |  |  |  |  |  |  |  |  |  |  | Y in CS_N-1 | 250 | 0.000000 | 1.000000 | -0.001000 | 0.000000 | 0.000000 | 1.000000 | 0.000000 | 0.000000 | 0.001000 | 1.000000 | 0.000000 | 0.000000 | y | 250.049875 | 0.049875 | 49.874992 | y | 250.000000 | 0.000000 | 0.000000 | y | 249.729875 | -0.270125 | -270.124955
 | Fz= | -239.02604 |  | deltaZ | 0.000000 | 0 | 0 | 0 | 0 | 0 | 0 | -239.02604 | deltaY | 49.875 | 0.000 | -270.125 |  |  |  |  |  |  |  |  |  |  | Z in CS_N-1 | -50 | 0.000000 | 0.001000 | 1.000000 | 0.000000 | -0.001000 | 0.000000 | 1.000000 | 0.000000 | 0.000000 | 0.000000 | 1.000000 | 0.000000 | z | -49.749975 | 0.250025 | 250.024958 | z | -49.729975 | 0.270025 | 270.024955 | z | -50.000000 | 0.000000 | 0.000000
 | unity | 1 |  | EpsilonX | 0.000000 | 0 | 0 | 0 | 0 | 0 | 0 | -70263.02 | deltaZ | 250.025 | 270.025 | 0.000 |  |  |  |  |  |  |  |  |  |  |  | 1 | 0.000000 | 0.000000 | 0.000000 | 1.000000 | 0.000000 | 0.000000 | 0.000000 | 1.000000 | 0.000000 | 0.000000 | 0.000000 | 1.000000 |  | 1.000000 |  |  |  | 1.000000 |  |  |  | 1.000000
 | Mx= | -70263.02 |  | EpsilonY | 0.000000 | 0 | 0 | 0 | 0 | 0 | 0 | -71707.812 |  | HTM Rotation matrix to align this CS with the next CS |  |  |  |  | HTM Rotation matrix to align this CS with final (ref) CS |  |  |  |  |  |  |  |  |  | HTM for ThetaX user specified orientation |  |  |  | HTM for ThetaY user specified orientation |  |  |  | HTM for ThetaZ user specified orientation
 | My= | -71707.812 |  | EpsilonZ | 0.000000 | 0 | 0 | 0 | 0 | 0 | 0 | 0 |  | 1.000 | 0.000 | 0.000 | 0.000 |  | 1.000 | 0.000 | 0.000 | 0.000 |  |  |  |  | X in CS_N | -270 | 1 | 0 | 0 | 0 | 1 | 0 | 0 | 0 | 1 | 0 | 0 | 0
 | Mz= | 0 |  |  |  |  |  |  |  |  |  |  |  | 0.000 | 1.000 | 0.000 | 0.000 |  | 0.000 | 1.000 | 0.000 | 0.000 |  |  |  |  | Y in CS_N | 250 | 0 | 1 | 0 | 0 | 0 | 1 | 0 | 0 | 0 | 1 | 0 | 0
 | unity | 1 |  |  |  |  |  |  |  |  |  |  |  | 0.000 | 0.000 | 1.000 | 0.000 |  | 0.000 | 0.000 | 1.000 | 0.000 |  |  |  |  | Z in CS_N | -50 | 0 | 0 | 1 | 0 | 0 | 0 | 1 | 0 | 0 | 0 | 1 | 0
 | Applied loads loads at Center of Stiffness in this axis' CS |  | Resulting loads at this CS Center of Stiffness |  |  |  |  |  |  |  |  |  |  | 0.000 | 0.000 | 0.000 | 1.000 |  | 0.000 | 0.000 | 0.000 | 1.000 |  |  |  |  |  | 1 | 0 | 0 | 0 | 1 | 0 | 0 | 0 | 1 | 0 | 0 | 0 | 1
 | Fx= | 0 | Fx= | 0
 | Fy= | 0 | Fy= | 0
 | Fz= | 0 | Fz= | -239.02604
 | unity | 1 | unity | 1
 | Mx= | 0 | Mx= | -70263.02
 | My= | 0 | My= | -64537.0308
 | Mz= | 0 | Mz= | 0
 | unity | 1 | unity | 1
CS 4 | Coordinates of previous axis CS origin becomes the point of interest (POI) in present CS |  |  | Error motions of CS Origin along & about its axes. Values from Axis_4 worksheet
 | X coordinate of point of interest in this CS | -270.000 |  | Random Geometric Errors |  | Systematic Geometric Errors |  |  |  |  |  |  | Random Errors at point of interest in current CS |  |  |  |  | Random Geometric Errors at point of interest in final (ref) CS |  |  |  |  |  | F=kx=attachment defl+structural defl at POI in current CS
 | Y coordinate of point of interest in CS | 250.000 |  | deltaX | 0.010000 | deltaX | 0.000000 |  |  |  |  |  |  | Pure translation | By epsx gain | By epsy gain | By epsz gain |  | Pure translation | By epsx gain | By epsy gain | By epsz gain |  | Pure translation | By epsx gain | By epsy gain | By epsz gain
 | Z coordinate of point of interest in CS | 125.000 |  | deltaY | 0.010000 | deltaY | 0.000000 |  |  |  |  |  | deltaX | 0.010000 | 0.000000 | 0.091207 | 0.050478 | deltaX | 0.010000 | 0.000000 | 0.091207 | 0.050478 | deltaX | -0.023571 | 0 | -0.01563703503 | 0
4 | Coordinates of this CS in the next CS |  |  | deltaZ | 0.010000 | deltaZ | 0.000000 |  |  |  |  |  | deltaY | 0.010000 | 0.025278 | 0.000000 | 0.054571 | deltaY | 0.010000 | 0.025278 | 0.000000 | 0.054571 | deltaY | 0.012564 | 0.3844890915 | 0 | 0
1 | Rotation about this CS's X axis to align Y axes (degrees) | 0 |  | EpsilonX | 0.000202 | EpsilonX | 0.000000 |  |  |  |  |  | deltaZ | 0.010000 | 0.050492 | 0.196749 | 0.000000 | deltaZ | 0.010000 | 0.050492 | 0.196749 | 0.000000 | deltaZ | -0.000876 | -0.7680179205 | -0.03373174687 | 0
Enter name below | Rotation about resulting Y axis to align axes (degrees) | 0 |  | EpsilonY | 0.000729 | EpsilonY | 0.000000 |  |  |  |  |  | unity | 1 | 1 | 1 | 1 | unity | 1.000000 | 1.000000 | 1.000000 | 1.000000 | unity | 1 | 1 | 1 | 1
 | rotation about resulting Z axis to align axes (degrees) | 0 |  | EpsilonZ | 0.000202 | EpsilonZ | 0.000000
 | X translation of this CS's origin along next CS's X axis | 0 |  | This CS origin F=kx Displacements + structural angular displ from next CS |  | Stiffness of this CS origin wrt its axes |  | Next CS CS Origin structural angular displ |  | Next CS CS Origin structural angular displ in this CS |  |  | Systematic Errors at point of interest in current CS |  |  |  |  | Systematic Geometric Errors at point of interest in final (ref) CS |  |  |  |  |  | F=kx=attachment defl+structural defl at POI in final (ref) CS
 | Y translation of aligned CS along next CS's Y axis | -250 |  | deltaX | 0.000000 | KX | 2588000 | EpsilonX | -0.003062 | EpsilonX | -0.003062424312 |  |  | Pure translation | By epsx gain | By epsy gain | By epsz gain |  | Pure translation | By epsx gain | By epsy gain | By epsz gain |  | Pure translation | By epsx gain | By epsy gain | By epsz gain
Column | Z translation of aligned CS along next CS's Z axis | 0 |  | deltaY | 0.000000 | KY | 0 | EpsilonY | -0.000097 | EpsilonY | -9.731752329e-05 |  | deltaX | 0.000000 | 0.000000 | 0.000000 | 0.000000 | deltaX | 0.000000 | 0.000000 | 0.000000 | 0.000000 | deltaX | -0.0235712925 | 0 | -0.01563703503 | 0
 | Resulting coordintes of point of interest in the next CS |  |  | deltaZ | -0.000092 | KZ | 2588000 | EpsilonZ | 0.000000 | EpsilonZ | 0 |  | deltaY | 0.000000 | 0.000000 | 0.000000 | 0.000000 | deltaY | 0.000000 | 0.000000 | 0.000000 | 0.000000 | deltaY | 0.01256442344 | 0.3844890915 | 0 | 0
 | X coordinate of point of interest in next CS | -270.000 |  | EpsilonX | -0.003073 | KrotX | 6745622000 | Unity | 1 | Unity | 1 |  | deltaZ | 0.000000 | 0.000000 | 0.000000 | 0.000000 | deltaZ | 0.000000 | 0.000000 | 0.000000 | 0.000000 | deltaZ | -0.0008761775928 | -0.7680179205 | -0.03373174687 | 0
 | Y coordinate of point of interest in next CS | 0.000 |  | EpsilonY | -0.000125 | KrotY | 2334591667 |  |  |  |  |  | unity | 1 | 1 | 1 | 1 | unity | 1 | 1 | 1 | 1 | unity | 1 | 1 | 1 | 1
 | Z coordinate of point of interest in next CS | 125.000 |  | EpsilonZ | 0.000000 | KrotZ | 6476038667 |  |  |  |  |  |  |  |  |  |  |  |  |  |  |  |  |  |  |  |  |  |  |  |  |  |  |  |  |  |  |  |  |  |  | Position, error, & error gain of tool tip due to epsx |  |  |  | Position, error, & error gain of tool tip due to epsY |  |  |  | Position, error, & error gain of tool tip due to epsZ
 | Loads from previous axes applied at previous axis CS origin but in present CS orientation |  |  | This CS POI F=kx structural displacements |  | POI displacements = Structure compliance matrix * Force & Moment at POI |  |  |  |  |  | POI's F's & M's | Error gain matrix: rotational errors' effects (at this CS origin) on point of interest |  |  |  |  |  |  |  |  |  |  |  |  |  |  |  | HTM for epsX = | 0.001 |  |  | HTM for epsY = 0.001 | 0.001 |  |  | HTM for epsZ = | 0.001 |  |  |  | position | error | error gain |  | position | error | error gain |  | position | error | error gain
 | Fx= | 0 |  | deltaX | -0.023571 | 4.261094895e-05 | 0 | 0 | 0 | 3.652367053e-07 | 0 | 0 |  | epsx's gains | epsy's gains | epsz's gains |  |  |  |  |  |  |  |  |  |  | X in CS_N-1 | -270 | 1.000000 | 0.000000 | 0.000000 | 0.000000 | 1.000000 | 0.000000 | 0.001000 | 0.000000 | 1.000000 | -0.001000 | 0.000000 | 0.000000 | x | -270.000000 | 0.000000 | 0.000000 | x | -269.874865 | 0.125135 | 125.134979 | x | -270.249865 | -0.249865 | -249.864958
 | Fy= | 0 |  | deltaY | 0.012564 | 0 | 2.086231706e-05 | 0 | -1.788198606e-07 | 0 | 0 | 0 | deltaX | 0.000 | 125.135 | -249.865 |  |  |  |  |  |  |  |  |  |  | Y in CS_N-1 | 250 | 0.000000 | 1.000000 | -0.001000 | 0.000000 | 0.000000 | 1.000000 | 0.000000 | 0.000000 | 0.001000 | 1.000000 | 0.000000 | 0.000000 | y | 249.874875 | -0.125125 | -125.124979 | y | 250.000000 | 0.000000 | 0.000000 | y | 249.729875 | -0.270125 | -270.124955
 | Fz= | -239.02604 |  | deltaZ | -0.000784 | 0 | 0 | 3.279216886e-06 | 0 | 0 | 0 | -239.02604 | deltaY | -125.125 | 0.000 | -270.125 |  |  |  |  |  |  |  |  |  |  | Z in CS_N-1 | 125 | 0.000000 | 0.001000 | 1.000000 | 0.000000 | -0.001000 | 0.000000 | 1.000000 | 0.000000 | 0.000000 | 0.000000 | 1.000000 | 0.000000 | z | 125.249937 | 0.249937 | 249.937458 | z | 125.269937 | 0.269937 | 269.937455 | z | 125.000000 | 0.000000 | 0.000000
 | unity | 1 |  | EpsilonX | -0.000144 | 0 | -1.788198606e-07 | 0 | 2.043655549e-09 | 0 | 0 | -70263.02 | deltaZ | 249.937 | 269.937 | 0.000 |  |  |  |  |  |  |  |  |  |  |  | 1 | 0.000000 | 0.000000 | 0.000000 | 1.000000 | 0.000000 | 0.000000 | 0.000000 | 1.000000 | 0.000000 | 0.000000 | 0.000000 | 1.000000 |  | 1.000000 |  |  |  | 1.000000 |  |  |  | 1.000000
 | Mx= | -70263.02 |  | EpsilonY | -0.000269 | 3.652367053e-07 | 0 | 0 | 0 | 4.174133775e-09 | 0 | -64537.0308 |  | HTM Rotation matrix to align this CS with the next CS |  |  |  |  | HTM Rotation matrix to align this CS with final (ref) CS |  |  |  |  |  |  |  |  |  | HTM for ThetaX user specified orientation |  |  |  | HTM for ThetaY user specified orientation |  |  |  | HTM for ThetaZ user specified orientation
 | My= | -64537.0308 |  | EpsilonZ | 0.000000 | 0 | 0 | 0 | 0 | 0 | 3.258441977e-09 | 0 |  | 1.000 | 0.000 | 0.000 | 0.000 |  | 1.000 | 0.000 | 0.000 | 0.000 |  |  |  |  | X in CS_N | -270 | 1 | 0 | 0 | 0 | 1 | 0 | 0 | 0 | 1 | 0 | 0 | 0
 | Mz= | 0 |  |  |  |  |  |  |  |  |  |  |  | 0.000 | 1.000 | 0.000 | 0.000 |  | 0.000 | 1.000 | 0.000 | 0.000 |  |  |  |  | Y in CS_N | 250 | 0 | 1 | 0 | 0 | 0 | 1 | 0 | 0 | 0 | 1 | 0 | 0
 | unity | 1 |  |  |  |  |  |  |  |  |  |  |  | 0.000 | 0.000 | 1.000 | 0.000 |  | 0.000 | 0.000 | 1.000 | 0.000 |  |  |  |  | Z in CS_N | 125 | 0 | 0 | 1 | 0 | 0 | 0 | 1 | 0 | 0 | 0 | 1 | 0
 | Applied loads loads at Center of Stiffness in this axis' CS |  | Resulting loads at this CS Center of Stiffness |  |  |  |  |  |  |  |  |  |  | 0.000 | 0.000 | 0.000 | 1.000 |  | 0.000 | 0.000 | 0.000 | 1.000 |  |  |  |  |  | 1 | 0 | 0 | 0 | 1 | 0 | 0 | 0 | 1 | 0 | 0 | 0 | 1
 | Fx= | 0 | Fx= | 0
 | Fy= | 0 | Fy= | 0
 | Fz= | 0 | Fz= | -239.02604
 | unity | 1 | unity | 1
 | Mx= | 0 | Mx= | -70263.02
 | My= | 0 | My= | -64537.0308
 | Mz= | 0 | Mz= | 0
 | unity | 1 | unity | 1
CS 5 | Coordinates of previous axis CS origin becomes the point of interest (POI) in present CS |  |  | Error motions of CS Origin along & about its axes. Values from Axis_5 worksheet
 | X coordinate of point of interest in this CS | -270.000 |  | Random Geometric Errors |  | Systematic Geometric Errors |  |  |  |  |  |  | Random Errors at point of interest in current CS |  |  |  |  | Random Geometric Errors at point of interest in final (ref) CS |  |  |  |  |  | F=kx=attachment defl+structural defl at POI in current CS
 | Y coordinate of point of interest in CS | 0.000 |  | deltaX | 0.010000 | deltaX | 0.000000 |  |  |  |  |  |  | Pure translation | By epsx gain | By epsy gain | By epsz gain |  | Pure translation | By epsx gain | By epsy gain | By epsz gain |  | Pure translation | By epsx gain | By epsy gain | By epsz gain
 | Z coordinate of point of interest in CS | 125.000 |  | deltaY | 0.010000 | deltaY | 0.000000 |  |  |  |  |  | deltaX | 0.010000 | 0.000000 | 0.025027 | 0.000027 | deltaX | 0.010000 | 0.000000 | 0.025027 | 0.000027 | deltaX | 0.000000 | 0 | -0.0004037112579 | 0
5 | Coordinates of this CS in the next CS |  |  | deltaZ | 0.010000 | deltaZ | 0.000000 |  |  |  |  |  | deltaY | 0.010000 | 0.025000 | 0.000000 | 0.054000 | deltaY | 0.010000 | 0.025000 | 0.000000 | 0.054000 | deltaY | 0.000000 | 0.0001312788416 | 0 | 0
1 | Rotation about this CS's X axis to align Y axes (degrees) | 0 |  | EpsilonX | 0.000200 | EpsilonX | 0.000000 |  |  |  |  |  | deltaZ | 0.010000 | 0.000012 | 0.053987 | 0.000000 | deltaZ | 0.010000 | 0.000012 | 0.053987 | 0.000000 | deltaZ | -0.420934 | 6.563942626e-08 | -0.0008708739176 | 0
Enter name below | Rotation about resulting Y axis to align axes (degrees) | 0 |  | EpsilonY | 0.000200 | EpsilonY | 0.000000 |  |  |  |  |  | unity | 1 | 1 | 1 | 1 | unity | 1.000000 | 1.000000 | 1.000000 | 1.000000 | unity | 1 | 1 | 1 | 1
 | rotation about resulting Z axis to align axes (degrees) | 0 |  | EpsilonZ | 0.000200 | EpsilonZ | 0.000000
 | X translation of this CS's origin along next CS's X axis | 0 |  | This CS origin F=kx Displacements + structural angular displ from next CS |  | Stiffness of this CS origin wrt its axes |  | Next CS CS Origin structural angular displ |  | Next CS CS Origin structural angular displ in this CS |  |  | Systematic Errors at point of interest in current CS |  |  |  |  | Systematic Geometric Errors at point of interest in final (ref) CS |  |  |  |  |  | F=kx=attachment defl+structural defl at POI in final (ref) CS
 | Y translation of aligned CS along next CS's Y axis | 0 |  | deltaX | 0.000000 | KX | 4000000 | EpsilonX | 0.000000 | EpsilonX | 0 |  |  | Pure translation | By epsx gain | By epsy gain | By epsz gain |  | Pure translation | By epsx gain | By epsy gain | By epsz gain |  | Pure translation | By epsx gain | By epsy gain | By epsz gain
Leg | Z translation of aligned CS along next CS's Z axis | 0 |  | deltaY | 0.000000 | KY | 4000000 | EpsilonY | 0.000000 | EpsilonY | 0 |  | deltaX | 0.000000 | 0.000000 | 0.000000 | 0.000000 | deltaX | 0.000000 | 0.000000 | 0.000000 | 0.000000 | deltaX | 0 | 0 | -0.0004037112579 | 0
 | Resulting coordintes of point of interest in the next CS |  |  | deltaZ | -0.000060 | KZ | 4000000 | EpsilonZ | 0.000000 | EpsilonZ | 0 |  | deltaY | 0.000000 | 0.000000 | 0.000000 | 0.000000 | deltaY | 0.000000 | 0.000000 | 0.000000 | 0.000000 | deltaY | 0 | 0.0001312788416 | 0 | 0
 | X coordinate of point of interest in next CS | -270.000 |  | EpsilonX | -0.000001 | KrotX | 10004000000 | Unity | 1 | Unity | 1 |  | deltaZ | 0.000000 | 0.000000 | 0.000000 | 0.000000 | deltaZ | 0.000000 | 0.000000 | 0.000000 | 0.000000 | deltaZ | -0.4209339665 | 6.563942626e-08 | -0.0008708739176 | 0
 | Y coordinate of point of interest in next CS | 0.000 |  | EpsilonY | -0.000003 | KrotY | 20004000000 |  |  |  |  |  | unity | 1 | 1 | 1 | 1 | unity | 1 | 1 | 1 | 1 | unity | 1 | 1 | 1 | 1
 | Z coordinate of point of interest in next CS | 125.000 |  | EpsilonZ | 0.000000 | KrotZ | 10004000000 |  |  |  |  |  |  |  |  |  |  |  |  |  |  |  |  |  |  |  |  |  |  |  |  |  |  |  |  |  |  |  |  |  |  | Position, error, & error gain of tool tip due to epsx |  |  |  | Position, error, & error gain of tool tip due to epsY |  |  |  | Position, error, & error gain of tool tip due to epsZ
 | Loads from previous axes applied at previous axis CS origin but in present CS orientation |  |  | This CS POI F=kx structural displacements |  | POI displacements = Structure compliance matrix * Force & Moment at POI |  |  |  |  |  | POI's F's & M's | Error gain matrix: rotational errors' effects (at this CS origin) on point of interest |  |  |  |  |  |  |  |  |  |  |  |  |  |  |  | HTM for epsX = | 0.001 |  |  | HTM for epsY = 0.001 | 0.001 |  |  | HTM for epsZ = | 0.001 |  |  |  | position | error | error gain |  | position | error | error gain |  | position | error | error gain
 | Fx= | 0 |  | deltaX | 0.000000 | 0.001228983401 | 0 | 0 | 0 | 0 | -0.03981906218 | 0 |  | epsx's gains | epsy's gains | epsz's gains |  |  |  |  |  |  |  |  |  |  | X in CS_N-1 | -270 | 1.000000 | 0.000000 | 0.000000 | 0.000000 | 1.000000 | 0.000000 | 0.001000 | 0.000000 | 1.000000 | -0.001000 | 0.000000 | 0.000000 | x | -270.000000 | 0.000000 | 0.000000 | x | -269.874865 | 0.125135 | 125.134979 | x | -269.999865 | 0.000135 | 0.135000
 | Fy= | 0 |  | deltaY | 0.000000 | 0 | 6.371049949e-06 | 0 | 0 | 0 | 0 | 0 | deltaX | 0.000 | 125.135 | 0.135 |  |  |  |  |  |  |  |  |  |  | Y in CS_N-1 | 0 | 0.000000 | 1.000000 | -0.001000 | 0.000000 | 0.000000 | 1.000000 | 0.000000 | 0.000000 | 0.001000 | 1.000000 | 0.000000 | 0.000000 | y | -0.125000 | -0.125000 | -124.999979 | y | 0.000000 | 0.000000 | 0.000000 | y | -0.270000 | -0.270000 | -269.999955
 | Fz= | -239.02604 |  | deltaZ | -0.420874 | 0 | 0 | 0.0006371049949 | 3.822629969e-06 | 0 | 0 | -239.02604 | deltaY | -125.000 | 0.000 | -270.000 |  |  |  |  |  |  |  |  |  |  | Z in CS_N-1 | 125 | 0.000000 | 0.001000 | 1.000000 | 0.000000 | -0.001000 | 0.000000 | 1.000000 | 0.000000 | 0.000000 | 0.000000 | 1.000000 | 0.000000 | z | 124.999938 | -0.000062 | -0.062500 | z | 125.269937 | 0.269937 | 269.937455 | z | 125.000000 | 0.000000 | 0.000000
 | unity | 1 |  | EpsilonX | -0.003062 | 0 | 0 | 3.822629969e-06 | 3.058103976e-08 | 0 | 0 | -70263.02 | deltaZ | -0.062 | 269.937 | 0.000 |  |  |  |  |  |  |  |  |  |  |  | 1 | 0.000000 | 0.000000 | 0.000000 | 1.000000 | 0.000000 | 0.000000 | 0.000000 | 1.000000 | 0.000000 | 0.000000 | 0.000000 | 1.000000 |  | 1.000000 |  |  |  | 1.000000 |  |  |  | 1.000000
 | Mx= | -70263.02 |  | EpsilonY | -0.000097 | 0 | 0 | 0 | 0 | 1.507933075e-09 | 0 | -64537.0308 |  | HTM Rotation matrix to align this CS with the next CS |  |  |  |  | HTM Rotation matrix to align this CS with final (ref) CS |  |  |  |  |  |  |  |  |  | HTM for ThetaX user specified orientation |  |  |  | HTM for ThetaY user specified orientation |  |  |  | HTM for ThetaZ user specified orientation
 | My= | -64537.0308 |  | EpsilonZ | 0.000000 | -0.03981906218 | 0 | 0 | 0 | 0 | 5.899120323e-08 | 0 |  | 1.000 | 0.000 | 0.000 | 0.000 |  | 1.000 | 0.000 | 0.000 | 0.000 |  |  |  |  | X in CS_N | -270 | 1 | 0 | 0 | 0 | 1 | 0 | 0 | 0 | 1 | 0 | 0 | 0
 | Mz= | 0 |  |  |  |  |  |  |  |  |  |  |  | 0.000 | 1.000 | 0.000 | 0.000 |  | 0.000 | 1.000 | 0.000 | 0.000 |  |  |  |  | Y in CS_N | 0 | 0 | 1 | 0 | 0 | 0 | 1 | 0 | 0 | 0 | 1 | 0 | 0
 | unity | 1 |  |  |  |  |  |  |  |  |  |  |  | 0.000 | 0.000 | 1.000 | 0.000 |  | 0.000 | 0.000 | 1.000 | 0.000 |  |  |  |  | Z in CS_N | 125 | 0 | 0 | 1 | 0 | 0 | 0 | 1 | 0 | 0 | 0 | 1 | 0
 | Applied loads loads at Center of Stiffness in this axis' CS |  | Resulting loads at this CS Center of Stiffness |  |  |  |  |  |  |  |  |  |  | 0.000 | 0.000 | 0.000 | 1.000 |  | 0.000 | 0.000 | 0.000 | 1.000 |  |  |  |  |  | 1 | 0 | 0 | 0 | 1 | 0 | 0 | 0 | 1 | 0 | 0 | 0 | 1
 | Fx= | 0 | Fx= | 0
 | Fy= | 0 | Fy= | 0
 | Fz= | 0 | Fz= | -239.02604
 | unity | 1 | unity | 1
 | Mx= | 0 | Mx= | -10506.51
 | My= | 0 | My= | -64537.0308
 | Mz= | 0 | Mz= | 0
 | unity | 1 | unity | 1
CS 6 | Coordinates of previous axis CS origin becomes the point of interest (POI) in present CS |  |  | Error motions of CS Origin along & about its axes. Values from Axis_6 worksheet
 | X coordinate of point of interest in this CS | -270.000 |  | Random Geometric Errors |  | Systematic Geometric Errors |  |  |  |  |  |  | Random Errors at point of interest in current CS |  |  |  |  | Random Geometric Errors at point of interest in final (ref) CS |  |  |  |  |  | F=kx=attachment defl+structural defl at POI in current CS
 | Y coordinate of point of interest in CS | 0.000 |  | deltaX | 0.005000 | deltaX | 0.000000 |  |  |  |  |  |  | Pure translation | By epsx gain | By epsy gain | By epsz gain |  | Pure translation | By epsx gain | By epsy gain | By epsz gain |  | Pure translation | By epsx gain | By epsy gain | By epsz gain
 | Z coordinate of point of interest in CS | 125.000 |  | deltaY | 0.005000 | deltaY | 0.000000 |  |  |  |  |  | deltaX | 0.005000 | 0.000000 | 0.012513 | 0.000013 | deltaX | 0.005000 | 0.000000 | 0.012513 | 0.000013 | deltaX | 0.000974 | 0 | -0.001222724412 | 0
6 | Coordinates of this CS in the next CS |  |  | deltaZ | 0.005000 | deltaZ | 0.000000 |  |  |  |  |  | deltaY | 0.005000 | 0.012500 | 0.000000 | 0.027000 | deltaY | 0.005000 | 0.012500 | 0.000000 | 0.027000 | deltaY | 0.000159 | 0.0001910447904 | 0 | 0
0 | Rotation about this CS's X axis to align Y axes (degrees) | 0 |  | EpsilonX | 0.000100 | EpsilonX | 0.000000 |  |  |  |  |  | deltaZ | 0.005000 | 0.000006 | 0.026994 | 0.000000 | deltaZ | 0.005000 | 0.000006 | 0.026994 | 0.000000 | deltaZ | -0.000155 | 9.552240318e-08 | -0.002637624732 | 0
Enter name below | Rotation about resulting Y axis to align axes (degrees) | 0 |  | EpsilonY | 0.000100 | EpsilonY | 0.000000 |  |  |  |  |  | unity | 1 | 1 | 1 | 1 | unity | 1.000000 | 1.000000 | 1.000000 | 1.000000 | unity | 1 | 1 | 1 | 1
 | rotation about resulting Z axis to align axes (degrees) | 0 |  | EpsilonZ | 0.000100 | EpsilonZ | 0.000000
 | X translation of this CS's origin along next CS's X axis | 270 |  | This CS origin F=kx Displacements + structural angular displ from next CS |  | Stiffness of this CS origin wrt its axes |  | Next CS CS Origin structural angular displ |  | Next CS CS Origin structural angular displ in this CS |  |  | Systematic Errors at point of interest in current CS |  |  |  |  | Systematic Geometric Errors at point of interest in final (ref) CS |  |  |  |  |  | F=kx=attachment defl+structural defl at POI in final (ref) CS
 | Y translation of aligned CS along next CS's Y axis | 0 |  | deltaX | 0.000000 | KX | 261799.3878 | EpsilonX | 0.000000 | EpsilonX | 0 |  |  | Pure translation | By epsx gain | By epsy gain | By epsz gain |  | Pure translation | By epsx gain | By epsy gain | By epsz gain |  | Pure translation | By epsx gain | By epsy gain | By epsz gain
X-axis | Z translation of aligned CS along next CS's Z axis | -125 |  | deltaY | 0.000000 | KY | 2588000 | EpsilonY | 0.000000 | EpsilonY | 0 |  | deltaX | 0.000000 | 0.000000 | 0.000000 | 0.000000 | deltaX | 0.000000 | 0.000000 | 0.000000 | 0.000000 | deltaX | 0.0009744120814 | 0 | -0.001222724412 | 0
 | Resulting coordintes of point of interest in the next CS |  |  | deltaZ | -0.000092 | KZ | 2588000 | EpsilonZ | 0.000000 | EpsilonZ | 0 |  | deltaY | 0.000000 | 0.000000 | 0.000000 | 0.000000 | deltaY | 0.000000 | 0.000000 | 0.000000 | 0.000000 | deltaY | 0.0001586324959 | 0.0001910447904 | 0 | 0
 | X coordinate of point of interest in next CS | 0.000 |  | EpsilonX | -0.000002 | KrotX | 6874375000 | Unity | 1 | Unity | 1 |  | deltaZ | 0.000000 | 0.000000 | 0.000000 | 0.000000 | deltaZ | 0.000000 | 0.000000 | 0.000000 | 0.000000 | deltaZ | -0.0001550027895 | 9.552240318e-08 | -0.002637624732 | 0
 | Y coordinate of point of interest in next CS | 0.000 |  | EpsilonY | -0.000010 | KrotY | 6604791667 |  |  |  |  |  | unity | 1 | 1 | 1 | 1 | unity | 1 | 1 | 1 | 1 | unity | 1 | 1 | 1 | 1
 | Z coordinate of point of interest in next CS | 0.000 |  | EpsilonZ | 0.000000 | KrotZ | 6604791667 |  |  |  |  |  |  |  |  |  |  |  |  |  |  |  |  |  |  |  |  |  |  |  |  |  |  |  |  |  |  |  |  |  |  | Position, error, & error gain of tool tip due to epsx |  |  |  | Position, error, & error gain of tool tip due to epsY |  |  |  | Position, error, & error gain of tool tip due to epsZ
 | Loads from previous axes applied at previous axis CS origin but in present CS orientation |  |  | This CS POI F=kx structural displacements |  | POI displacements = Structure compliance matrix * Force & Moment at POI |  |  |  |  |  | POI's F's & M's | Error gain matrix: rotational errors' effects (at this CS origin) on point of interest |  |  |  |  |  |  |  |  |  |  |  |  |  |  |  | HTM for epsX = | 0.001 |  |  | HTM for epsY = 0.001 | 0.001 |  |  | HTM for epsZ = | 0.001 |  |  |  | position | error | error gain |  | position | error | error gain |  | position | error | error gain
 | Fx= | 0 |  | deltaX | 0.000974 | 7.045964655e-06 | 0 | 0 | 0 | -1.509849569e-08 | 0 | 0 |  | epsx's gains | epsy's gains | epsz's gains |  |  |  |  |  |  |  |  |  |  | X in CS_N-1 | -270 | 1.000000 | 0.000000 | 0.000000 | 0.000000 | 1.000000 | 0.000000 | 0.001000 | 0.000000 | 1.000000 | -0.001000 | 0.000000 | 0.000000 | x | -270.000000 | 0.000000 | 0.000000 | x | -269.874865 | 0.125135 | 125.134979 | x | -269.999865 | 0.000135 | 0.135000
 | Fy= | 0 |  | deltaY | 0.000159 | 0 | 7.045964655e-06 | 0 | -1.509849569e-08 | 0 | 0 | 0 | deltaX | 0.000 | 125.135 | 0.135 |  |  |  |  |  |  |  |  |  |  | Y in CS_N-1 | 0 | 0.000000 | 1.000000 | -0.001000 | 0.000000 | 0.000000 | 1.000000 | 0.000000 | 0.000000 | 0.001000 | 1.000000 | 0.000000 | 0.000000 | y | -0.125000 | -0.125000 | -124.999979 | y | 0.000000 | 0.000000 | 0.000000 | y | -0.270000 | -0.270000 | -269.999955
 | Fz= | -239.02604 |  | deltaZ | -0.000063 | 0 | 0 | 2.620778188e-07 | 0 | 0 | 0 | -239.02604 | deltaY | -125.000 | 0.000 | -270.000 |  |  |  |  |  |  |  |  |  |  | Z in CS_N-1 | 125 | 0.000000 | 0.001000 | 1.000000 | 0.000000 | -0.001000 | 0.000000 | 1.000000 | 0.000000 | 0.000000 | 0.000000 | 1.000000 | 0.000000 | z | 124.999938 | -0.000062 | -0.062500 | z | 125.269937 | 0.269937 | 269.937455 | z | 125.000000 | 0.000000 | 0.000000
 | unity | 1 |  | EpsilonX | -8.811274318e-08 | 0 | -1.509849569e-08 | 0 | 8.386490203e-12 | 0 | 0 | -10506.51 | deltaZ | -0.062 | 269.937 | 0.000 |  |  |  |  |  |  |  |  |  |  |  | 1 | 0.000000 | 0.000000 | 0.000000 | 1.000000 | 0.000000 | 0.000000 | 0.000000 | 1.000000 | 0.000000 | 0.000000 | 0.000000 | 1.000000 |  | 1.000000 |  |  |  | 1.000000 |  |  |  | 1.000000
 | Mx= | -10506.51 |  | EpsilonY | -0.000003 | -1.509849569e-08 | 0 | 0 | 0 | 4.313855911e-11 | 0 | -64537.0308 |  | HTM Rotation matrix to align this CS with the next CS |  |  |  |  | HTM Rotation matrix to align this CS with final (ref) CS |  |  |  |  |  |  |  |  |  | HTM for ThetaX user specified orientation |  |  |  | HTM for ThetaY user specified orientation |  |  |  | HTM for ThetaZ user specified orientation
 | My= | -64537.0308 |  | EpsilonZ | 0.000000 | 0 | 0 | 0 | 0 | 0 | 9.155195191e-11 | 0 |  | 1.000 | 0.000 | 0.000 | 0.000 |  | 1.000 | 0.000 | 0.000 | 0.000 |  |  |  |  | X in CS_N | -270 | 1 | 0 | 0 | 0 | 1 | 0 | 0 | 0 | 1 | 0 | 0 | 0
 | Mz= | 0 |  |  |  |  |  |  |  |  |  |  |  | 0.000 | 1.000 | 0.000 | 0.000 |  | 0.000 | 1.000 | 0.000 | 0.000 |  |  |  |  | Y in CS_N | 0 | 0 | 1 | 0 | 0 | 0 | 1 | 0 | 0 | 0 | 1 | 0 | 0
 | unity | 1 |  |  |  |  |  |  |  |  |  |  |  | 0.000 | 0.000 | 1.000 | 0.000 |  | 0.000 | 0.000 | 1.000 | 0.000 |  |  |  |  | Z in CS_N | 125 | 0 | 0 | 1 | 0 | 0 | 0 | 1 | 0 | 0 | 0 | 1 | 0
 | Applied loads loads at Center of Stiffness in this axis' CS |  | Resulting loads at this CS Center of Stiffness |  |  |  |  |  |  |  |  |  |  | 0.000 | 0.000 | 0.000 | 1.000 |  | 0.000 | 0.000 | 0.000 | 1.000 |  |  |  |  |  | 1 | 0 | 0 | 0 | 1 | 0 | 0 | 0 | 1 | 0 | 0 | 0 | 1
 | Fx= | 0 | Fx= | 0
 | Fy= | 0 | Fy= | 0
 | Fz= | 0 | Fz= | -239.02604
 | unity | 1 | unity | 1
 | Mx= | 0 | Mx= | -10506.51
 | My= | 0 | My= | -64537.0308
 | Mz= | 0 | Mz= | 0
 | unity | 1 | unity | 1
CS 7 | Coordinates of previous axis CS origin becomes the point of interest (POI) in present CS |  |  | Error motions of CS Origin along & about its axes. Values from Axis_7 worksheet
 | X coordinate of point of interest in this CS | 0.000 |  | Random Geometric Errors |  | Systematic Geometric Errors |  |  |  |  |  |  | Random Errors at point of interest in current CS |  |  |  |  | Random Geometric Errors at point of interest in final (ref) CS |  |  |  |  |  | F=kx=attachment defl+structural defl at POI in current CS
 | Y coordinate of point of interest in CS | 0.000 |  | deltaX | 0.005000 | deltaX | 0.000000 |  |  |  |  |  |  | Pure translation | By epsx gain | By epsy gain | By epsz gain |  | Pure translation | By epsx gain | By epsy gain | By epsz gain |  | Pure translation | By epsx gain | By epsy gain | By epsz gain
 | Z coordinate of point of interest in CS | 0.000 |  | deltaY | 0.005000 | deltaY | 0.000000 |  |  |  |  |  | deltaX | 0.005000 | 0.000000 | 0.000000 | 0.000000 | deltaX | 0.005000 | 0.000000 | 0.000000 | 0.000000 | deltaX | 0.000000 | 0 | 0 | 0
7 | Coordinates of this CS in the next CS |  |  | deltaZ | 0.005000 | deltaZ | 0.000000 |  |  |  |  |  | deltaY | 0.005000 | 0.000000 | 0.000000 | 0.000000 | deltaY | 0.005000 | 0.000000 | 0.000000 | 0.000000 | deltaY | 0.000000 | 0 | 0 | 0
0 | Rotation about this CS's X axis to align Y axes (degrees) | 0 |  | EpsilonX | 0.000050 | EpsilonX | 0.000000 |  |  |  |  |  | deltaZ | 0.005000 | 0.000000 | 0.000000 | 0.000000 | deltaZ | 0.005000 | 0.000000 | 0.000000 | 0.000000 | deltaZ | -0.001759 | 0 | 0 | 0
Enter name below | Rotation about resulting Y axis to align axes (degrees) | 0 |  | EpsilonY | 0.000050 | EpsilonY | 0.000000 |  |  |  |  |  | unity | 1 | 1 | 1 | 1 | unity | 1.000000 | 1.000000 | 1.000000 | 1.000000 | unity | 1 | 1 | 1 | 1
 | rotation about resulting Z axis to align axes (degrees) | 0 |  | EpsilonZ | 0.000050 | EpsilonZ | 0.000000
 | X translation of this CS's origin along next CS's X axis | 0 |  | This CS origin F=kx Displacements + structural angular displ from next CS |  | Stiffness of this CS origin wrt its axes |  | Next CS CS Origin structural angular displ |  | Next CS CS Origin structural angular displ in this CS |  |  | Systematic Errors at point of interest in current CS |  |  |  |  | Systematic Geometric Errors at point of interest in final (ref) CS |  |  |  |  |  | F=kx=attachment defl+structural defl at POI in final (ref) CS
 | Y translation of aligned CS along next CS's Y axis | 0 |  | deltaX | 0.000000 | KX | 400000000 | EpsilonX | 0.000000 | EpsilonX | 0 |  |  | Pure translation | By epsx gain | By epsy gain | By epsz gain |  | Pure translation | By epsx gain | By epsy gain | By epsz gain |  | Pure translation | By epsx gain | By epsy gain | By epsz gain
Bed & Frame | Z translation of aligned CS along next CS's Z axis | 0 |  | deltaY | 0.000000 | KY | 400000000 | EpsilonY | 0.000000 | EpsilonY | 0 |  | deltaX | 0.000000 | 0.000000 | 0.000000 | 0.000000 | deltaX | 0.000000 | 0.000000 | 0.000000 | 0.000000 | deltaX | 0 | 0 | 0 | 0
 | Resulting coordintes of point of interest in the next CS |  |  | deltaZ | -0.000001 | KZ | 400000000 | EpsilonZ | 0.000000 | EpsilonZ | 0 |  | deltaY | 0.000000 | 0.000000 | 0.000000 | 0.000000 | deltaY | 0.000000 | 0.000000 | 0.000000 | 0.000000 | deltaY | 0 | 0 | 0 | 0
 | X coordinate of point of interest in next CS | 0.000 |  | EpsilonX | -2.626361991e-09 | KrotX | 4000404375000 | Unity | 1 | Unity | 1 |  | deltaZ | 0.000000 | 0.000000 | 0.000000 | 0.000000 | deltaZ | 0.000000 | 0.000000 | 0.000000 | 0.000000 | deltaZ | -0.001759050286 | 0 | 0 | 0
 | Y coordinate of point of interest in next CS | 0.000 |  | EpsilonY | 0.000000 | KrotY | 4.000134792e+12 |  |  |  |  |  | unity | 1 | 1 | 1 | 1 | unity | 1 | 1 | 1 | 1 | unity | 1 | 1 | 1 | 1
 | Z coordinate of point of interest in next CS | 0.000 |  | EpsilonZ | 0.000000 | KrotZ | 8.000134792e+12 |  |  |  |  |  |  |  |  |  |  |  |  |  |  |  |  |  |  |  |  |  |  |  |  |  |  |  |  |  |  |  |  |  |  | Position, error, & error gain of tool tip due to epsx |  |  |  | Position, error, & error gain of tool tip due to epsY |  |  |  | Position, error, & error gain of tool tip due to epsZ
 | Loads from previous axes applied at previous axis CS origin but in present CS orientation |  |  | This CS POI F=kx structural displacements |  | POI displacements = Structure compliance matrix * Force & Moment at POI |  |  |  |  |  | POI's F's & M's | Error gain matrix: rotational errors' effects (at this CS origin) on point of interest |  |  |  |  |  |  |  |  |  |  |  |  |  |  |  | HTM for epsX = | 0.001 |  |  | HTM for epsY = 0.001 | 0.001 |  |  | HTM for epsZ = | 0.001 |  |  |  | position | error | error gain |  | position | error | error gain |  | position | error | error gain
 | Fx= | 0 |  | deltaX | 0.000000 | 5.705808513e-07 | 0 | 0 | 0 | 0 | -1.588961382e-08 | 0 |  | epsx's gains | epsy's gains | epsz's gains |  |  |  |  |  |  |  |  |  |  | X in CS_N-1 | 0 | 1.000000 | 0.000000 | 0.000000 | 0.000000 | 1.000000 | 0.000000 | 0.001000 | 0.000000 | 1.000000 | -0.001000 | 0.000000 | 0.000000 | x | 0.000000 | 0.000000 | 0.000000 | x | 0.000000 | 0.000000 | 0.000000 | x | 0.000000 | 0.000000 | 0.000000
 | Fy= | 0 |  | deltaY | 0.000000 | 0 | 5.705808513e-07 | 0 | 0 | 0 | 0 | 0 | deltaX | 0.000 | 0.000 | 0.000 |  |  |  |  |  |  |  |  |  |  | Y in CS_N-1 | 0 | 0.000000 | 1.000000 | -0.001000 | 0.000000 | 0.000000 | 1.000000 | 0.000000 | 0.000000 | 0.001000 | 1.000000 | 0.000000 | 0.000000 | y | 0.000000 | 0.000000 | 0.000000 | y | 0.000000 | 0.000000 | 0.000000 | y | 0.000000 | 0.000000 | 0.000000
 | Fz= | -239.02604 |  | deltaZ | -0.001758 | 0 | 0 | 5.07584886e-06 | 5.189093886e-08 | 0 | 0 | -239.02604 | deltaY | 0.000 | 0.000 | 0.000 |  |  |  |  |  |  |  |  |  |  | Z in CS_N-1 | 0 | 0.000000 | 0.001000 | 1.000000 | 0.000000 | -0.001000 | 0.000000 | 1.000000 | 0.000000 | 0.000000 | 0.000000 | 1.000000 | 0.000000 | z | 0.000000 | 0.000000 | 0.000000 | z | 0.000000 | 0.000000 | 0.000000 | z | 0.000000 | 0.000000 | 0.000000
 | unity | 1 |  | EpsilonX | -0.000015 | 0 | 0 | 5.189093886e-08 | 2.043884645e-10 | 0 | 0 | -10506.51 | deltaZ | 0.000 | 0.000 | 0.000 |  |  |  |  |  |  |  |  |  |  |  | 1 | 0.000000 | 0.000000 | 0.000000 | 1.000000 | 0.000000 | 0.000000 | 0.000000 | 1.000000 | 0.000000 | 0.000000 | 0.000000 | 1.000000 |  | 1.000000 |  |  |  | 1.000000 |  |  |  | 1.000000
 | Mx= | -10506.51 |  | EpsilonY | -0.000012 | 0 | 0 | 0 | 0 | 1.877584319e-10 | 0 | -64537.0308 |  | HTM Rotation matrix to align this CS with the next CS |  |  |  |  | HTM Rotation matrix to align this CS with final (ref) CS |  |  |  |  |  |  |  |  |  | HTM for ThetaX user specified orientation |  |  |  | HTM for ThetaY user specified orientation |  |  |  | HTM for ThetaZ user specified orientation
 | My= | -64537.0308 |  | EpsilonZ | 0.000000 | -1.588961382e-08 | 0 | 0 | 0 | 0 | 0 | 0 |  | 1.000 | 0.000 | 0.000 | 0.000 |  | 1.000 | 0.000 | 0.000 | 0.000 |  |  |  |  | X in CS_N | 0 | 1 | 0 | 0 | 0 | 1 | 0 | 0 | 0 | 1 | 0 | 0 | 0
 | Mz= | 0 |  |  |  |  |  |  |  |  |  |  |  | 0.000 | 1.000 | 0.000 | 0.000 |  | 0.000 | 1.000 | 0.000 | 0.000 |  |  |  |  | Y in CS_N | 0 | 0 | 1 | 0 | 0 | 0 | 1 | 0 | 0 | 0 | 1 | 0 | 0
 | unity | 1 |  |  |  |  |  |  |  |  |  |  |  | 0.000 | 0.000 | 1.000 | 0.000 |  | 0.000 | 0.000 | 1.000 | 0.000 |  |  |  |  | Z in CS_N | 0 | 0 | 0 | 1 | 0 | 0 | 0 | 1 | 0 | 0 | 0 | 1 | 0
 | Applied loads loads at Center of Stiffness in this axis' CS |  | Resulting loads at this CS Center of Stiffness |  |  |  |  |  |  |  |  |  |  | 0.000 | 0.000 | 0.000 | 1.000 |  | 0.000 | 0.000 | 0.000 | 1.000 |  |  |  |  |  | 1 | 0 | 0 | 0 | 1 | 0 | 0 | 0 | 1 | 0 | 0 | 0 | 1
 | Fx= | 0 | Fx= | 0
 | Fy= | 0 | Fy= | 0
 | Fz= | 0 | Fz= | -239.02604
 | unity | 1 | unity | 1
 | Mx= | 0 | Mx= | -10506.51
 | My= | 0 | My= | 0
 | Mz= | 0 | Mz= | 0
 | unity | 1 | unity | 1
CS 8 | Coordinates of previous axis CS origin becomes the point of interest (POI) in present CS |  |  | Error motions of CS Origin along & about its axes. Values from Axis_8 worksheet
 | X coordinate of point of interest in this CS | 0.000 |  | Random Geometric Errors |  | Systematic Geometric Errors |  |  |  |  |  |  | Random Errors at point of interest in current CS |  |  |  |  | Random Geometric Errors at point of interest in final (ref) CS |  |  |  |  |  | F=kx=attachment defl+structural defl at POI in current CS
 | Y coordinate of point of interest in CS | 0.000 |  | deltaX | 0.005000 | deltaX | 0.000000 |  |  |  |  |  |  | Pure translation | By epsx gain | By epsy gain | By epsz gain |  | Pure translation | By epsx gain | By epsy gain | By epsz gain |  | Pure translation | By epsx gain | By epsy gain | By epsz gain
 | Z coordinate of point of interest in CS | 0.000 |  | deltaY | 0.005000 | deltaY | 0.000000 |  |  |  |  |  | deltaX | 0.005000 | 0.000000 | 0.000000 | 0.000000 | deltaX | 0.005000 | 0.000000 | 0.000000 | 0.000000 | deltaX | 0.000000 | 0 | 0 | 0
8 | Coordinates of this CS in the next CS |  |  | deltaZ | 0.005000 | deltaZ | 0.000000 |  |  |  |  |  | deltaY | 0.005000 | 0.000000 | 0.000000 | 0.000000 | deltaY | 0.005000 | 0.000000 | 0.000000 | 0.000000 | deltaY | 0.000000 | 0 | 0 | 0
0 | Rotation about this CS's X axis to align Y axes (degrees) | 0 |  | EpsilonX | 0.000100 | EpsilonX | 0.000000 |  |  |  |  |  | deltaZ | 0.005000 | 0.000000 | 0.000000 | 0.000000 | deltaZ | 0.005000 | 0.000000 | 0.000000 | 0.000000 | deltaZ | -0.000092 | 0 | 0 | 0
Enter name below | Rotation about resulting Y axis to align axes (degrees) | 0 |  | EpsilonY | 0.000100 | EpsilonY | 0.000000 |  |  |  |  |  | unity | 1 | 1 | 1 | 1 | unity | 1.000000 | 1.000000 | 1.000000 | 1.000000 | unity | 1 | 1 | 1 | 1
 | rotation about resulting Z axis to align axes (degrees) | 0 |  | EpsilonZ | 0.000100 | EpsilonZ | 0.000000
 | X translation of this CS's origin along next CS's X axis | 10 |  | This CS origin F=kx Displacements + structural angular displ from next CS |  | Stiffness of this CS origin wrt its axes |  | Next CS CS Origin structural angular displ |  | Next CS CS Origin structural angular displ in this CS |  |  | Systematic Errors at point of interest in current CS |  |  |  |  | Systematic Geometric Errors at point of interest in final (ref) CS |  |  |  |  |  | F=kx=attachment defl+structural defl at POI in final (ref) CS
 | Y translation of aligned CS along next CS's Y axis | 0 |  | deltaX | 0.000000 | KX | 6785.840132 | EpsilonX | 0.000000 | EpsilonX | 0 |  |  | Pure translation | By epsx gain | By epsy gain | By epsz gain |  | Pure translation | By epsx gain | By epsy gain | By epsz gain |  | Pure translation | By epsx gain | By epsy gain | By epsz gain
Thing 8 | Z translation of aligned CS along next CS's Z axis | 0 |  | deltaY | 0.000000 | KY | 2588000 | EpsilonY | 0.000000 | EpsilonY | 0 |  | deltaX | 0.000000 | 0.000000 | 0.000000 | 0.000000 | deltaX | 0.000000 | 0.000000 | 0.000000 | 0.000000 | deltaX | 0 | 0 | 0 | 0
 | Resulting coordintes of point of interest in the next CS |  |  | deltaZ | -0.000092 | KZ | 2588000 | EpsilonZ | 0.000000 | EpsilonZ | 0 |  | deltaY | 0.000000 | 0.000000 | 0.000000 | 0.000000 | deltaY | 0.000000 | 0.000000 | 0.000000 | 0.000000 | deltaY | 0 | 0 | 0 | 0
 | X coordinate of point of interest in next CS | 10.000 |  | EpsilonX | -0.000002 | KrotX | 6874375000 | Unity | 1 | Unity | 1 |  | deltaZ | 0.000000 | 0.000000 | 0.000000 | 0.000000 | deltaZ | 0.000000 | 0.000000 | 0.000000 | 0.000000 | deltaZ | -9.235936631e-05 | 0 | 0 | 0
 | Y coordinate of point of interest in next CS | 0.000 |  | EpsilonY | 0.000000 | KrotY | 6604791667 |  |  |  |  |  | unity | 1 | 1 | 1 | 1 | unity | 1 | 1 | 1 | 1 | unity | 1 | 1 | 1 | 1
 | Z coordinate of point of interest in next CS | 0.000 |  | EpsilonZ | 0.000000 | KrotZ | 6604791667 |  |  |  |  |  |  |  |  |  |  |  |  |  |  |  |  |  |  |  |  |  |  |  |  |  |  |  |  |  |  |  |  |  |  | Position, error, & error gain of tool tip due to epsx |  |  |  | Position, error, & error gain of tool tip due to epsY |  |  |  | Position, error, & error gain of tool tip due to epsZ
 | Loads from previous axes applied at previous axis CS origin but in present CS orientation |  |  | This CS POI F=kx structural displacements |  | POI displacements = Structure compliance matrix * Force & Moment at POI |  |  |  |  |  | POI's F's & M's | Error gain matrix: rotational errors' effects (at this CS origin) on point of interest |  |  |  |  |  |  |  |  |  |  |  |  |  |  |  | HTM for epsX = | 0.001 |  |  | HTM for epsY = 0.001 | 0.001 |  |  | HTM for epsZ = | 0.001 |  |  |  | position | error | error gain |  | position | error | error gain |  | position | error | error gain
 | Fx= | 0 |  | deltaX | 0.000000 | 0 | 0 | 0 | 0 | 0 | 0 | 0 |  | epsx's gains | epsy's gains | epsz's gains |  |  |  |  |  |  |  |  |  |  | X in CS_N-1 | 0 | 1.000000 | 0.000000 | 0.000000 | 0.000000 | 1.000000 | 0.000000 | 0.001000 | 0.000000 | 1.000000 | -0.001000 | 0.000000 | 0.000000 | x | 0.000000 | 0.000000 | 0.000000 | x | 0.000000 | 0.000000 | 0.000000 | x | 0.000000 | 0.000000 | 0.000000
 | Fy= | 0 |  | deltaY | 0.000000 | 0 | 0 | 0 | 0 | 0 | 0 | 0 | deltaX | 0.000 | 0.000 | 0.000 |  |  |  |  |  |  |  |  |  |  | Y in CS_N-1 | 0 | 0.000000 | 1.000000 | -0.001000 | 0.000000 | 0.000000 | 1.000000 | 0.000000 | 0.000000 | 0.001000 | 1.000000 | 0.000000 | 0.000000 | y | 0.000000 | 0.000000 | 0.000000 | y | 0.000000 | 0.000000 | 0.000000 | y | 0.000000 | 0.000000 | 0.000000
 | Fz= | -239.02604 |  | deltaZ | 0.000000 | 0 | 0 | 0 | 0 | 0 | 0 | -239.02604 | deltaY | 0.000 | 0.000 | 0.000 |  |  |  |  |  |  |  |  |  |  | Z in CS_N-1 | 0 | 0.000000 | 0.001000 | 1.000000 | 0.000000 | -0.001000 | 0.000000 | 1.000000 | 0.000000 | 0.000000 | 0.000000 | 1.000000 | 0.000000 | z | 0.000000 | 0.000000 | 0.000000 | z | 0.000000 | 0.000000 | 0.000000 | z | 0.000000 | 0.000000 | 0.000000
 | unity | 1 |  | EpsilonX | 0.000000 | 0 | 0 | 0 | 0 | 0 | 0 | -10506.51 | deltaZ | 0.000 | 0.000 | 0.000 |  |  |  |  |  |  |  |  |  |  |  | 1 | 0.000000 | 0.000000 | 0.000000 | 1.000000 | 0.000000 | 0.000000 | 0.000000 | 1.000000 | 0.000000 | 0.000000 | 0.000000 | 1.000000 |  | 1.000000 |  |  |  | 1.000000 |  |  |  | 1.000000
 | Mx= | -10506.51 |  | EpsilonY | 0.000000 | 0 | 0 | 0 | 0 | 0 | 0 | 0 |  | HTM Rotation matrix to align this CS with the next CS |  |  |  |  | HTM Rotation matrix to align this CS with final (ref) CS |  |  |  |  |  |  |  |  |  | HTM for ThetaX user specified orientation |  |  |  | HTM for ThetaY user specified orientation |  |  |  | HTM for ThetaZ user specified orientation
 | My= | 0 |  | EpsilonZ | 0.000000 | 0 | 0 | 0 | 0 | 0 | 0 | 0 |  | 1.000 | 0.000 | 0.000 | 0.000 |  | 1.000 | 0.000 | 0.000 | 0.000 |  |  |  |  | X in CS_N | 0 | 1 | 0 | 0 | 0 | 1 | 0 | 0 | 0 | 1 | 0 | 0 | 0
 | Mz= | 0 |  |  |  |  |  |  |  |  |  |  |  | 0.000 | 1.000 | 0.000 | 0.000 |  | 0.000 | 1.000 | 0.000 | 0.000 |  |  |  |  | Y in CS_N | 0 | 0 | 1 | 0 | 0 | 0 | 1 | 0 | 0 | 0 | 1 | 0 | 0
 | unity | 1 |  |  |  |  |  |  |  |  |  |  |  | 0.000 | 0.000 | 1.000 | 0.000 |  | 0.000 | 0.000 | 1.000 | 0.000 |  |  |  |  | Z in CS_N | 0 | 0 | 0 | 1 | 0 | 0 | 0 | 1 | 0 | 0 | 0 | 1 | 0
 | Applied loads loads at Center of Stiffness in this axis' CS |  | Resulting loads at this CS Center of Stiffness |  |  |  |  |  |  |  |  |  |  | 0.000 | 0.000 | 0.000 | 1.000 |  | 0.000 | 0.000 | 0.000 | 1.000 |  |  |  |  |  | 1 | 0 | 0 | 0 | 1 | 0 | 0 | 0 | 1 | 0 | 0 | 0 | 1
 | Fx= | 0 | Fx= | 0
 | Fy= | 0 | Fy= | 0
 | Fz= | 0 | Fz= | -239.02604
 | unity | 1 | unity | 1
 | Mx= | 0 | Mx= | -10506.51
 | My= | 0 | My= | 0
 | Mz= | 0 | Mz= | 0
 | unity | 1 | unity | 1
CS 9 | Coordinates of previous axis CS origin becomes the point of interest (POI) in present CS |  |  | Error motions of CS Origin along & about its axes. Values from Axis_9 worksheet
 | X coordinate of point of interest in this CS | 10.000 |  | Random Geometric Errors |  | Systematic Geometric Errors |  |  |  |  |  |  | Random Errors at point of interest in current CS |  |  |  |  | Random Geometric Errors at point of interest in final (ref) CS |  |  |  |  |  | F=kx=attachment defl+structural defl at POI in current CS
 | Y coordinate of point of interest in CS | 0.000 |  | deltaX | 0.005000 | deltaX | 0.000000 |  |  |  |  |  |  | Pure translation | By epsx gain | By epsy gain | By epsz gain |  | Pure translation | By epsx gain | By epsy gain | By epsz gain |  | Pure translation | By epsx gain | By epsy gain | By epsz gain
 | Z coordinate of point of interest in CS | 0.000 |  | deltaY | 0.005000 | deltaY | 0.000000 |  |  |  |  |  | deltaX | 0.005000 | 0.000000 | 4.999999532e-07 | 4.999999582e-07 | deltaX | 0.005000 | 0.000000 | 4.999999532e-07 | 4.999999582e-07 | deltaX | 0.000000 | 0 | -1.809489474e-09 | 0
9 | Coordinates of this CS in the next CS |  |  | deltaZ | 0.005000 | deltaZ | 0.000000 |  |  |  |  |  | deltaY | 0.005000 | 0.000000 | 0.000000 | 0.001000 | deltaY | 0.005000 | 0.000000 | 0.000000 | 0.001000 | deltaY | 0.000000 | 0 | 0 | 0
0 | Rotation about this CS's X axis to align Y axes (degrees) | 0 |  | EpsilonX | 0.000100 | EpsilonX | 0.000000 |  |  |  |  |  | deltaZ | 0.005000 | 0.000000 | 0.001000 | 0.000000 | deltaZ | 0.005000 | 0.000000 | 0.001000 | 0.000000 | deltaZ | -0.000092 | 0 | -3.618978648e-06 | 0
Enter name below | Rotation about resulting Y axis to align axes (degrees) | 0 |  | EpsilonY | 0.000100 | EpsilonY | 0.000000 |  |  |  |  |  | unity | 1 | 1 | 1 | 1 | unity | 1.000000 | 1.000000 | 1.000000 | 1.000000 | unity | 1 | 1 | 1 | 1
 | rotation about resulting Z axis to align axes (degrees) | 0 |  | EpsilonZ | 0.000100 | EpsilonZ | 0.000000
 | X translation of this CS's origin along next CS's X axis | 10 |  | This CS origin F=kx Displacements + structural angular displ from next CS |  | Stiffness of this CS origin wrt its axes |  | Next CS CS Origin structural angular displ |  | Next CS CS Origin structural angular displ in this CS |  |  | Systematic Errors at point of interest in current CS |  |  |  |  | Systematic Geometric Errors at point of interest in final (ref) CS |  |  |  |  |  | F=kx=attachment defl+structural defl at POI in final (ref) CS
 | Y translation of aligned CS along next CS's Y axis | 0 |  | deltaX | 0.000000 | KX | 6785.840132 | EpsilonX | 0.000000 | EpsilonX | 0 |  |  | Pure translation | By epsx gain | By epsy gain | By epsz gain |  | Pure translation | By epsx gain | By epsy gain | By epsz gain |  | Pure translation | By epsx gain | By epsy gain | By epsz gain
Thing 9 | Z translation of aligned CS along next CS's Z axis | 0 |  | deltaY | 0.000000 | KY | 2588000 | EpsilonY | 0.000000 | EpsilonY | 0 |  | deltaX | 0.000000 | 0.000000 | 0.000000 | 0.000000 | deltaX | 0.000000 | 0.000000 | 0.000000 | 0.000000 | deltaX | 0 | 0 | -1.809489474e-09 | 0
 | Resulting coordintes of point of interest in the next CS |  |  | deltaZ | -0.000092 | KZ | 2588000 | EpsilonZ | 0.000000 | EpsilonZ | 0 |  | deltaY | 0.000000 | 0.000000 | 0.000000 | 0.000000 | deltaY | 0.000000 | 0.000000 | 0.000000 | 0.000000 | deltaY | 0 | 0 | 0 | 0
 | X coordinate of point of interest in next CS | 20.000 |  | EpsilonX | -0.000002 | KrotX | 6874375000 | Unity | 1 | Unity | 1 |  | deltaZ | 0.000000 | 0.000000 | 0.000000 | 0.000000 | deltaZ | 0.000000 | 0.000000 | 0.000000 | 0.000000 | deltaZ | -9.235936631e-05 | 0 | -3.618978648e-06 | 0
 | Y coordinate of point of interest in next CS | 0.000 |  | EpsilonY | 3.618979251e-07 | KrotY | 6604791667 |  |  |  |  |  | unity | 1 | 1 | 1 | 1 | unity | 1 | 1 | 1 | 1 | unity | 1 | 1 | 1 | 1
 | Z coordinate of point of interest in next CS | 0.000 |  | EpsilonZ | 0.000000 | KrotZ | 6604791667 |  |  |  |  |  |  |  |  |  |  |  |  |  |  |  |  |  |  |  |  |  |  |  |  |  |  |  |  |  |  |  |  |  |  | Position, error, & error gain of tool tip due to epsx |  |  |  | Position, error, & error gain of tool tip due to epsY |  |  |  | Position, error, & error gain of tool tip due to epsZ
 | Loads from previous axes applied at previous axis CS origin but in present CS orientation |  |  | This CS POI F=kx structural displacements |  | POI displacements = Structure compliance matrix * Force & Moment at POI |  |  |  |  |  | POI's F's & M's | Error gain matrix: rotational errors' effects (at this CS origin) on point of interest |  |  |  |  |  |  |  |  |  |  |  |  |  |  |  | HTM for epsX = | 0.001 |  |  | HTM for epsY = 0.001 | 0.001 |  |  | HTM for epsZ = | 0.001 |  |  |  | position | error | error gain |  | position | error | error gain |  | position | error | error gain
 | Fx= | 0 |  | deltaX | 0.000000 | 0 | 0 | 0 | 0 | 0 | 0 | 0 |  | epsx's gains | epsy's gains | epsz's gains |  |  |  |  |  |  |  |  |  |  | X in CS_N-1 | 10 | 1.000000 | 0.000000 | 0.000000 | 0.000000 | 1.000000 | 0.000000 | 0.001000 | 0.000000 | 1.000000 | -0.001000 | 0.000000 | 0.000000 | x | 10.000000 | 0.000000 | 0.000000 | x | 9.999995 | -0.000005 | -0.005000 | x | 9.999995 | -0.000005 | -0.005000
 | Fy= | 0 |  | deltaY | 0.000000 | 0 | 0 | 0 | 0 | 0 | 0 | 0 | deltaX | 0.000 | -0.005 | -0.005 |  |  |  |  |  |  |  |  |  |  | Y in CS_N-1 | 0 | 0.000000 | 1.000000 | -0.001000 | 0.000000 | 0.000000 | 1.000000 | 0.000000 | 0.000000 | 0.001000 | 1.000000 | 0.000000 | 0.000000 | y | 0.000000 | 0.000000 | 0.000000 | y | 0.000000 | 0.000000 | 0.000000 | y | 0.010000 | 0.010000 | 9.999998
 | Fz= | -239.02604 |  | deltaZ | 0.000000 | 0 | 0 | 0 | 0 | 0 | 0 | -239.02604 | deltaY | 0.000 | 0.000 | 10.000 |  |  |  |  |  |  |  |  |  |  | Z in CS_N-1 | 0 | 0.000000 | 0.001000 | 1.000000 | 0.000000 | -0.001000 | 0.000000 | 1.000000 | 0.000000 | 0.000000 | 0.000000 | 1.000000 | 0.000000 | z | 0.000000 | 0.000000 | 0.000000 | z | -0.010000 | -0.010000 | -9.999998 | z | 0.000000 | 0.000000 | 0.000000
 | unity | 1 |  | EpsilonX | 0.000000 | 0 | 0 | 0 | 0 | 0 | 0 | -10506.51 | deltaZ | 0.000 | -10.000 | 0.000 |  |  |  |  |  |  |  |  |  |  |  | 1 | 0.000000 | 0.000000 | 0.000000 | 1.000000 | 0.000000 | 0.000000 | 0.000000 | 1.000000 | 0.000000 | 0.000000 | 0.000000 | 1.000000 |  | 1.000000 |  |  |  | 1.000000 |  |  |  | 1.000000
 | Mx= | -10506.51 |  | EpsilonY | 0.000000 | 0 | 0 | 0 | 0 | 0 | 0 | 0 |  | HTM Rotation matrix to align this CS with the next CS |  |  |  |  | HTM Rotation matrix to align this CS with final (ref) CS |  |  |  |  |  |  |  |  |  | HTM for ThetaX user specified orientation |  |  |  | HTM for ThetaY user specified orientation |  |  |  | HTM for ThetaZ user specified orientation
 | My= | 0 |  | EpsilonZ | 0.000000 | 0 | 0 | 0 | 0 | 0 | 0 | 0 |  | 1.000 | 0.000 | 0.000 | 0.000 |  | 1.000 | 0.000 | 0.000 | 0.000 |  |  |  |  | X in CS_N | 10 | 1 | 0 | 0 | 0 | 1 | 0 | 0 | 0 | 1 | 0 | 0 | 0
 | Mz= | 0 |  |  |  |  |  |  |  |  |  |  |  | 0.000 | 1.000 | 0.000 | 0.000 |  | 0.000 | 1.000 | 0.000 | 0.000 |  |  |  |  | Y in CS_N | 0 | 0 | 1 | 0 | 0 | 0 | 1 | 0 | 0 | 0 | 1 | 0 | 0
 | unity | 1 |  |  |  |  |  |  |  |  |  |  |  | 0.000 | 0.000 | 1.000 | 0.000 |  | 0.000 | 0.000 | 1.000 | 0.000 |  |  |  |  | Z in CS_N | 0 | 0 | 0 | 1 | 0 | 0 | 0 | 1 | 0 | 0 | 0 | 1 | 0
 | Applied loads loads at Center of Stiffness in this axis' CS |  | Resulting loads at this CS Center of Stiffness |  |  |  |  |  |  |  |  |  |  | 0.000 | 0.000 | 0.000 | 1.000 |  | 0.000 | 0.000 | 0.000 | 1.000 |  |  |  |  |  | 1 | 0 | 0 | 0 | 1 | 0 | 0 | 0 | 1 | 0 | 0 | 0 | 1
 | Fx= | 0 | Fx= | 0
 | Fy= | 0 | Fy= | 0
 | Fz= | 0 | Fz= | -239.02604
 | unity | 1 | unity | 1
 | Mx= | 0 | Mx= | -10506.51
 | My= | 0 | My= | 2390.2604
 | Mz= | 0 | Mz= | 0
 | unity | 1 | unity | 1
CS 10 | Coordinates of previous axis CS origin becomes the point of interest (POI) in present CS |  |  | Error motions of CS Origin along & about its axes. Values from Axis_10 worksheet
 | X coordinate of point of interest in this CS | 20.000 |  | Random Geometric Errors |  | Systematic Geometric Errors |  |  |  |  |  |  | Random Errors at point of interest in current CS |  |  |  |  | Random Geometric Errors at point of interest in final (ref) CS |  |  |  |  |  | F=kx=attachment defl+structural defl at POI in current CS
 | Y coordinate of point of interest in CS | 0.000 |  | deltaX | 0.005000 | deltaX | 0.000000 |  |  |  |  |  |  | Pure translation | By epsx gain | By epsy gain | By epsz gain |  | Pure translation | By epsx gain | By epsy gain | By epsz gain |  | Pure translation | By epsx gain | By epsy gain | By epsz gain
 | Z coordinate of point of interest in CS | 0.000 |  | deltaY | 0.005000 | deltaY | 0.000000 |  |  |  |  |  | deltaX | 0.005000 | 0.000000 | 0.000001 | 0.000001 | deltaX | 0.005000 | 0.000000 | 0.000001 | 0.000001 | deltaX | 0.000000 | 0 | -7.237957898e-09 | 0
10 | Coordinates of this CS in the next CS |  |  | deltaZ | 0.005000 | deltaZ | 0.000000 |  |  |  |  |  | deltaY | 0.005000 | 0.000000 | 0.000000 | 0.002000 | deltaY | 0.005000 | 0.000000 | 0.000000 | 0.002000 | deltaY | 0.000000 | 0 | 0 | 0
0 | Rotation about this CS's X axis to align Y axes (degrees) | 0 |  | EpsilonX | 0.000100 | EpsilonX | 0.000000 |  |  |  |  |  | deltaZ | 0.005000 | 0.000000 | 0.002000 | 0.000000 | deltaZ | 0.005000 | 0.000000 | 0.002000 | 0.000000 | deltaZ | -0.000092 | 0 | -1.447591459e-05 | 0
Enter name below | Rotation about resulting Y axis to align axes (degrees) | 0 |  | EpsilonY | 0.000100 | EpsilonY | 0.000000 |  |  |  |  |  | unity | 1 | 1 | 1 | 1 | unity | 1.000000 | 1.000000 | 1.000000 | 1.000000 | unity | 1 | 1 | 1 | 1
 | rotation about resulting Z axis to align axes (degrees) | 0 |  | EpsilonZ | 0.000100 | EpsilonZ | 0.000000
 | X translation of this CS's origin along next CS's X axis | 10 |  | This CS origin F=kx Displacements |  | Stiffness of this CS origin wrt its axes |  |  |  |  |  |  | Systematic Errors at point of interest in current CS |  |  |  |  | Systematic Geometric Errors at point of interest in final (ref) CS |  |  |  |  |  | F=kx=attachment defl+structural defl at POI in final (ref) CS
 | Y translation of aligned CS along next CS's Y axis | 0 |  | deltaX | 0.000000 | KX | 6785.840132 |  |  |  |  |  |  | Pure translation | By epsx gain | By epsy gain | By epsz gain |  | Pure translation | By epsx gain | By epsy gain | By epsz gain |  | Pure translation | By epsx gain | By epsy gain | By epsz gain
Thing 10 | Z translation of aligned CS along next CS's Z axis | 0 |  | deltaY | 0.000000 | KY | 2588000 |  |  |  |  |  | deltaX | 0.000000 | 0.000000 | 0.000000 | 0.000000 | deltaX | 0.000000 | 0.000000 | 0.000000 | 0.000000 | deltaX | 0 | 0 | -7.237957898e-09 | 0
 | Resulting coordintes of point of interest in the next CS |  |  | deltaZ | -0.000092 | KZ | 2588000 |  |  |  |  |  | deltaY | 0.000000 | 0.000000 | 0.000000 | 0.000000 | deltaY | 0.000000 | 0.000000 | 0.000000 | 0.000000 | deltaY | 0 | 0 | 0 | 0
 | X coordinate of point of interest in next CS | 30.000 |  | EpsilonX | -0.000002 | KrotX | 6874375000 |  |  |  |  |  | deltaZ | 0.000000 | 0.000000 | 0.000000 | 0.000000 | deltaZ | 0.000000 | 0.000000 | 0.000000 | 0.000000 | deltaZ | -9.235936631e-05 | 0 | -1.447591459e-05 | 0
 | Y coordinate of point of interest in next CS | 0.000 |  | EpsilonY | 0.000001 | KrotY | 6604791667 |  |  |  |  |  | unity | 1 | 1 | 1 | 1 | unity | 1 | 1 | 1 | 1 | unity | 1 | 1 | 1 | 1
 | Z coordinate of point of interest in next CS | 0.000 |  | EpsilonZ | 0.000000 | KrotZ | 6604791667 |  |  |  |  |  |  |  |  |  |  |  |  |  |  |  |  |  |  |  |  |  |  |  |  |  |  |  |  |  |  |  |  |  |  | Position, error, & error gain of tool tip due to epsx |  |  |  | Position, error, & error gain of tool tip due to epsY |  |  |  | Position, error, & error gain of tool tip due to epsZ
 | Loads from previous axes applied at previous axis CS origin but in present CS orientation |  |  | This CS POI F=kx structural displacements |  | POI displacements = Structure compliance matrix * Force & Moment at POI |  |  |  |  |  | POI's F's & M's | Error gain matrix: rotational errors' effects (at this CS origin) on point of interest |  |  |  |  |  |  |  |  |  |  |  |  |  |  |  | HTM for epsX = | 0.001 |  |  | HTM for epsY = 0.001 | 0.001 |  |  | HTM for epsZ = | 0.001 |  |  |  | position | error | error gain |  | position | error | error gain |  | position | error | error gain
 | Fx= | 0 |  | deltaX | 0.000000 | 0 | 0 | 0 | 0 | 0 | 0 | 0 |  | epsx's gains | epsy's gains | epsz's gains |  |  |  |  |  |  |  |  |  |  | X in CS_N-1 | 20 | 1.000000 | 0.000000 | 0.000000 | 0.000000 | 1.000000 | 0.000000 | 0.001000 | 0.000000 | 1.000000 | -0.001000 | 0.000000 | 0.000000 | x | 20.000000 | 0.000000 | 0.000000 | x | 19.999990 | -0.000010 | -0.010000 | x | 19.999990 | -0.000010 | -0.010000
 | Fy= | 0 |  | deltaY | 0.000000 | 0 | 0 | 0 | 0 | 0 | 0 | 0 | deltaX | 0.000 | -0.010 | -0.010 |  |  |  |  |  |  |  |  |  |  | Y in CS_N-1 | 0 | 0.000000 | 1.000000 | -0.001000 | 0.000000 | 0.000000 | 1.000000 | 0.000000 | 0.000000 | 0.001000 | 1.000000 | 0.000000 | 0.000000 | y | 0.000000 | 0.000000 | 0.000000 | y | 0.000000 | 0.000000 | 0.000000 | y | 0.020000 | 0.020000 | 19.999997
 | Fz= | -239.02604 |  | deltaZ | 0.000000 | 0 | 0 | 0 | 0 | 0 | 0 | -239.02604 | deltaY | 0.000 | 0.000 | 20.000 |  |  |  |  |  |  |  |  |  |  | Z in CS_N-1 | 0 | 0.000000 | 0.001000 | 1.000000 | 0.000000 | -0.001000 | 0.000000 | 1.000000 | 0.000000 | 0.000000 | 0.000000 | 1.000000 | 0.000000 | z | 0.000000 | 0.000000 | 0.000000 | z | -0.020000 | -0.020000 | -19.999997 | z | 0.000000 | 0.000000 | 0.000000
 | unity | 1 |  | EpsilonX | 0.000000 | 0 | 0 | 0 | 0 | 0 | 0 | -10506.51 | deltaZ | 0.000 | -20.000 | 0.000 |  |  |  |  |  |  |  |  |  |  |  | 1 | 0.000000 | 0.000000 | 0.000000 | 1.000000 | 0.000000 | 0.000000 | 0.000000 | 1.000000 | 0.000000 | 0.000000 | 0.000000 | 1.000000 |  | 1.000000 |  |  |  | 1.000000 |  |  |  | 1.000000
 | Mx= | -10506.51 |  | EpsilonY | 0.000000 | 0 | 0 | 0 | 0 | 0 | 0 | 2390.2604 |  | HTM Rotation matrix to align this CS with the next CS |  |  |  | 1 | HTM Rotation matrix to align this CS with final (ref) CS |  |  |  |  |  |  |  |  |  | HTM for ThetaX user specified orientation |  |  |  | HTM for ThetaY user specified orientation |  |  |  | HTM for ThetaZ user specified orientation
 | My= | 2390.2604 |  | EpsilonZ | 0.000000 | 0 | 0 | 0 | 0 | 0 | 0 | 0 |  | 1.000 | 0.000 | 0.000 | 0.000 |  | 1.000 | 0.000 | 0.000 | 0.000 |  |  |  |  | X in CS_N | 20 | 1 | 0 | 0 | 0 | 1 | 0 | 0 | 0 | 1 | 0 | 0 | 0
 | Mz= | 0 |  |  |  |  |  |  |  |  |  |  |  | 0.000 | 1.000 | 0.000 | 0.000 |  | 0.000 | 1.000 | 0.000 | 0.000 |  |  |  |  | Y in CS_N | 0 | 0 | 1 | 0 | 0 | 0 | 1 | 0 | 0 | 0 | 1 | 0 | 0
 | unity | 1 |  |  |  |  |  |  |  |  |  |  |  | 0.000 | 0.000 | 1.000 | 0.000 |  | 0.000 | 0.000 | 1.000 | 0.000 |  |  |  |  | Z in CS_N | 0 | 0 | 0 | 1 | 0 | 0 | 0 | 1 | 0 | 0 | 0 | 1 | 0
 | Applied loads loads at Center of Stiffness in this axis' CS |  | Resulting loads at this CS Center of Stiffness |  |  |  |  |  |  |  |  |  |  | 0.000 | 0.000 | 0.000 | 1.000 |  | 0.000 | 0.000 | 0.000 | 1.000 |  |  |  |  |  | 1 | 0 | 0 | 0 | 1 | 0 | 0 | 0 | 1 | 0 | 0 | 0 | 1
 | Fx= | 0 | Fx= | 0
 | Fy= | 0 | Fy= | 0
 | Fz= | 0 | Fz= | -239.02604
 | unity | 1 | unity | 1
 | Mx= | 0 | Mx= | -10506.51
 | My= | 0 | My= | 4780.5208
 | Mz= | 0 | Mz= | 0
 | unity | 1 | unity | 1
 |  |  |  |  |  |  |  |  |  |  |  |  |  |  |  |  |  |  | Because Xcell is lame and does not have an identity matrix… :-), we define it here
 |  |  |  |  |  |  |  |  |  |  |  |  |  |  |  |  |  |  | 1 | 0 | 0 | 0
 |  |  |  |  |  |  |  |  |  |  |  |  |  |  |  |  |  |  | 0 | 1 | 0 | 0
 |  |  |  |  |  |  |  |  |  |  |  |  |  |  |  |  |  |  | 0 | 0 | 1 | 0
 |  |  |  |  |  |  |  |  |  |  |  |  |  |  |  |  |  |  | 0 | 0 | 0 | 1

Sheet: Edit History
Suggested additions to act on
Event # | Date: | By: | Summary of edits made
1 | 2015.09.15 | AS | cleaned formating, added some explanations, and added random and systematic angular errors for use in the case where using purchased axis
2 | 2015.10.20 | AS | fixed rotation error calculation from running parallelism and added conditional IF in case user has zeros in any cells on Axis_N sheets
3 | 2015.10.21 | AS | made calculation of rotation errors generic wrt linear guide position
4 | 2015.10.28 | AS | Changed error gain calculation by making pertubation angle 1e-6 v 1e-3 to remove roundoff error for very small errors
5 | 2015.10.29 | AS | fixed error calculartions referencing error gains, changed RSS to RMS for attachment points' errors
6 | 2015.11.12 | AS | fixed moment load calculation on CS origins
7 | 2016.02.29 | AS | Random error calculation in Axis CS and loads sheets forced positive by ABS, also error gain calculation by user can enter magnitude of angle for calculating error gain) should not need to be changed though)
8 | 2016.03.06 | AS | Fixed issue of plane of bearing blocks and errors entered--added lots of conditional Ifs so no need to worry about doing vector sum of implied angular errors from bearing blocks being sometimes different depending on orientation…
9 | 2016.03.08 | AS | Structure stiffness matrix added, along with calculations such that the linear and angular deflections of the structure are added accordingly to previous CS origin motions so Abbe errors accounted for
10 | 2016.03.27 | AS | Major revision to have each CS worksheet include bearings, servo, structure assessment to form the complaince matric (no need for old "bearings, servo, structure" worksheet)
11 | 2016.03.30 | AS | added suggested additions to act on
12 | 2016.03.30 | AS | deleted unused "servo stiffness" cells from "Summary" worksheet and added Extra length of actuator for mounting to be added to servo position for calculating the stiffness of actuator in CS worksheets
13 | 2016.05.24 | AS | formatting
14 | 2016.10.20 | AS | corrected label description for moment of inertia calculations
15 | 2016.10.20 | AS | added condition for "Next CS CS Origin structural angular displ" to be multiplied by the on/off (1 or 0) for the next axis being used or not
16 | 2016.10.20 | AS | error gains calculated based on 0.001 radians much more accurate than 0.01
17 | 2017.05.14 | SYL | Update cross-section properties for columns to take into account gap between keeper rails (previously modelled as rectangular tubes)
18 | 2015.05.14 | SYL | Update height of feet to 50 mm instead of 80 mm to account for gap between columns and feet due to manufacturing error -- now acting as helper bearing that engages at some amount of deflection instead of solid bolted joint
19
20
21
22
23
24
25
26
27
28
29
30
31
32

Sheet: CS_1 Table
CS 1 | Table
Geometric errors at CS origin and location and stiffness of points (or bearings) of attachment between coordinate systems
Error motions of CS Origin along & about its axes. Values read used by "Coordinate Systems" worksheet |  |  |  | CAREFUL as this compliance matrix is referenced in the worksheet "CSs and Loads"
Element | Tool | Bearings (if values needed for this CS) |  | Tool in toolholder (cantilever beam): X lateral, Y transverse, Z axial
Structure type | Simply Supported Beam | Size (e.g., rail width) | 25 | dx | _ = _ | -3.628033295e-06 | 0 | 0 | 0 | 0 | 0 | Fx
Material | Plywood | Fmax (N) | 17346 | dy |  | 0 | 4.664614236e-08 | 0 | 0 | 0 | 0 | Fy
Young's Modulus (N/mm^2) | 10719 | k @ medium preload (N/mm) | 647000 | dz |  | 0 | 0 | 0.002743420238 | 8.569617571e-06 | 0 | 0 | Fz
Poison ratio | 0.29 | ball diameter (mm) | 3 | thetaX |  | 0 | 0 | 8.569617571e-06 | -4.487141098e-10 | 0 | 0 | Mx
Shear modulus (N/mm^2) | 4154.651163 | % deflection max load | 0.01 | thetaY |  | 0 | 0 | 0 | 0 | 2.239526725e-08 | 0 | My
Beam properties (rectangular tube) |  | stiffness est (N/mm) | 578200 | thetaZ |  | 0 | 0 | 0 | 0 | 0 | 3.807848356e-13 | Mz
Position along beam | -350 | rail width (mm) | 25 |  |  | Fx | Fy | Fz | Mx | My | Mz
Length (mm) | 700 | roll rotary stiffness (Nmm/radian) | 101093750
Thickness (mm) | 18 | pitch rotary stiffness (Nmm/radian) | 33697916.67
Depth (mm) | 500 | yaw rotary stiffness (Nmm/radian) | 33697916.67
wall (mm) | - | servo system (if values needed for this CS)
Area (mm^2) | 9000 | Ballscrew
I xx // nuetral axis (mm^4) | 340200 | Root diameter (mm) | 11
I yy // nuetral axis (mm^4) | 243000 | Length (mm) | 1000
I zz // nuetral axis (mm^4) | 1.429166667e+10
Ipolar (mm^4) | 187743000 | Modulus | 200000
I/A stiffness to weight ratio |  | shaft stiffness | 19006.63555
ref, simply supported stiffness about Izz (N/mm) |  | factor to derate stiffness of shaft for nut, mounting etc | 3
Notes: Y axis is + into the page so a + X direction force causes a - rotation about Y axis. Cells not used are colored blue
Net stiffness of CS origin (POA@Center of Stiffness) due to attachment points |  | Servo stiffness (if applicable, else make sure to enter "0"
Linear stiffness
KX | 2312800 | 0
KY | 2319135.545 | 6335.545185 |  |  |  | Application note: IF using a purchased linear table with mfg specs for stuffness and accuracy, just enter "1" for number of attach points and then the stiffness and error motion data from the catalog for that "point" (the entire table)
KZ | 2312800 | 0 |  |  |  | CRITICAL: Enter Total number of bearing or attachment points (up to 12) AND zero out numbers in fields for points not used!
Rotation stiffness |  |  |  |  |  | Number of attach points = | 4
KrotX | 1580291667 | 0 |  |  |  |  | Attachment points between current CS origin and next CS: usually in a plane
KrotY | 4.887137917e+11 | 0 |  |  |  | location in axis CS | 1 | 2 | 3 | 4 | 5 | 6 | 7 | 8 | 9 | 10 | 11 | 12
KrotZ | 490428875000 | 0 |  |  |  | X | 0 | 0 | -650 | -650 | 0 | 0 | 0 | 0 | 0 | 0 | 0 | 0
Application note: IF using a purchased axis with mfg specs for stiffness and accuracy, just enter "1" for number of attach points and then the stiffness and error motion data from the catalog for that "point" (the entire table) |  |  |  |  |  | Y | -25 | 25 | 25 | -25 | 0 | 0 | 0 | 0 | 0 | 0 | 0 | 0
 |  |  |  |  |  | Z | 0 | 0 | 0 | 0 | 0 | 0 | 0 | 0 | 0 | 0 | 0 | 0

Sheet: CS_4 Column
CS 4 | Column
Geometric errors at CS origin and location and stiffness of points (or bearings) of attachment between coordinate systems
Error motions of CS Origin along & about its axes. Values read used by "Coordinate Systems" worksheet |  |  |  | CAREFUL as this compliance matrix is referenced in the worksheet "CSs and Loads"
Element | z columns | Bearings (if values needed for this CS) |  | cantilever
Structure type | cantilever | Size (e.g., rail width) | 25 | dx | _ = _ | 4.261094895e-05 | 0 | 0 | 0 | 3.652367053e-07 | 0 | Fx
Material | euro beech | Fmax (N) | 17346 | dy |  | 0 | 2.086231706e-05 | 0 | -1.788198606e-07 | 0 | 0 | Fy
Young's Modulus (N/mm^2) | 10900 | k @ medium preload (N/mm) | 647000 | dz |  | 0 | 0 | 3.279216886e-06 | 0 | 0 | 0 | Fz
Poison ratio | 0.334 | ball diameter (mm) | 3 | thetaX |  | 0 | -1.788198606e-07 | 0 | 2.043655549e-09 | 0 | 0 | Mx
Shear modulus (N/mm^2) | 4085.457271 | % deflection max load | 0.01 | thetaY |  | 3.652367053e-07 | 0 | 0 | 0 | 4.174133775e-09 | 0 | My
Beam properties (rectangular tube, or round, else customize) |  | stiffness est (N/mm) | 578200 | thetaZ |  | 0 | 0 | 0 | 0 | 0 | 3.258441977e-09 | Mz
Position along beam | 175 | rail width (mm) | 25 |  |  | Fx | Fy | Fz | Mx | My | Mz
Length (mm) | 600 | roll rotary stiffness (Nmm/radian) | 101093750
Height (mm) (or diameter) | 111 | pitch rotary stiffness (Nmm/radian) | 33697916.67
Width (mm), or fraction of solid cylinder | 86 | yaw rotary stiffness (Nmm/radian) | 33697916.67
wall (mm) | 18 | servo system (if values needed for this CS)
slot height (mm) | 75
slot width (mm) | 50
gap between keeper rails (mm) | 50
Area of gap b/w keepers (mm^2) | 900
Area of crosssection (mm^2) | 4896 | Ballscrew | Y axis
I width dimension of beam (from SldWorks) (mm^4) | 3846318 | Root diameter (mm) | 18
I height dimension of beam (from Sldworks) (mm^4) | 7856043 | Length (mm) | 0
Ipolar (mm^4) | 13145811 | Modulus | 200000
I/A stiffness to weight ratio | 1604.583946 | shaft stiffness | #DIV/0!
simply supported stiffness about Izz (N/mm) | 1189.317621 | factor to derate stiffness of shaft for nut, mounting etc | 3
Notes: Chunky slab, and bearing blocks essentially mounted back to back so assume structure has zero compliance
Net stiffness of CS origin (POA@Center of Stiffness) due to attachment points |  | Servo stiffness (if applicable, else make sure to enter "0"
Linear stiffness
KX | 2588000 | 0 |  |  |  | Application note: IF using a purchased linear table with mfg specs for stuffness and accuracy, just enter "1" for number of attach points and then the stiffness and error motion data from the catalog for that "point" (the entire table)
KY | 0 | 0 |  |  |  | CRITICAL: Enter Total number of bearing or attachment points (up to 12) AND zero out numbers in fields for points not used!
KZ | 2588000 | 0 |  |  |  | Number of attach points = | 4
Rotation stiffness |  |  |  |  |  |  | Attachment points between current CS origin and next CS: usually in a plane
KrotX | 6745622000 | 0 |  |  |  | location in axis CS | 1 | 2 | 3 | 4 | 5 | 6 | 7 | 8 | 9 | 10 | 11 | 12
KrotY | 2334591667 | 0 |  |  |  | X | 0 | 0 | 0 | 0 | 0 | 0 | 0 | 0 | 0 | 0 | 0 | 0
KrotZ | 6476038667 | 0 |  |  |  | Y | -49.5 | -49.5 | 49.5 | 49.5 | 0 | 0 | 0 | 0 | 0 | 0 | 0 | 0
Application note: IF using a purchased axis with mfg specs for stiffness and accuracy, just enter "1" for number of attach points and then the stiffness and error motion data from the catalog for that "point" (the entire table) |  |  |  |  |  | Z | 40 | 10 | 10 | 40 | 0 | 0 | 0 | 0 | 0 | 0 | 0 | 0
 |  |  |  |  |  | Linear stiffness at the point
 |  |  |  | dowels pullout |  | KX | 647000 | 647000 | 647000 | 647000 | 0 | 0 | 0 | 0 | 0 | 0 | 0 | 0
Additional angular error motions (in event of using a modular axis) |  |  |  | dowel shear |  | KY | 0 | 0 | 0 | 0 | 0 | 0 | 0 | 0 | 0 | 0 | 0 | 0
Random |  |  |  | dowel shear |  | KZ | 647000 | 647000 | 647000 | 647000 | 0 | 0 | 0 | 0 | 0 | 0 | 0 | 0
EpsilonX (radians) | 0 |  |  |  |  | Rotation stiffness at the point
EpsilonY (radians) | 0 |  |  |  |  | KrotX | 101093750 | 101093750 | 101093750 | 101093750 | 0 | 0 | 0 | 0 | 0 | 0 | 0 | 0
EpsilonZ (radians) | 0 |  |  |  |  | KrotY | 33697916.67 | 33697916.67 | 33697916.67 | 33697916.67 | 0 | 0 | 0 | 0 | 0 | 0 | 0 | 0
Systematic |  |  |  |  |  | KrotZ | 33697916.67 | 33697916.67 | 33697916.67 | 33697916.67 | 0 | 0 | 0 | 0 | 0 | 0 | 0 | 0
EpsilonX (radians) | 0 |  |  |  |  | Effective contribution of linear stiffness to rotation stiffness about center of stiffness
EpsilonY (radians) | 0 |  |  |  |  | KrotX | 1585311750 | 1585311750 | 1585311750 | 1585311750 | 0 | 0 | 0 | 0 | 0 | 0 | 0 | 0
EpsilonZ (radians) | 0 |  |  |  |  | KrotY | 1035200000 | 64700000 | 64700000 | 1035200000 | 0 | 0 | 0 | 0 | 0 | 0 | 0 | 0
Net Random RMS error motions of points connecting adjacent CS |  |  |  |  |  | KrotZ | 1585311750 | 1585311750 | 1585311750 | 1585311750 | 0 | 0 | 0 | 0 | 0 | 0 | 0 | 0
DeltaX | 0.01 |  |  |  |  | Random Translational (e.g., running parallelism) error motions of attachment points, NO ZEROS FOR POINTS IN USE, INCLUDING ALONG SERVO AXIS, AT A MINIMUM MAKE SERVO DIRECTION = RUNNING PARALLISM
DeltaY | 0.01 |  |  |  |  | DeltaX | 0.01 | 0.01 | 0.01 | 0.01 | 0 | 0 | 0 | 0 | 0 | 0 | 0 | 0
DeltaZ | 0.01 |  |  |  |  | DeltaY | 0.01 | 0.01 | 0.01 | 0.01 | 0 | 0 | 0 | 0 | 0 | 0 | 0 | 0
EpsilonX | 0.000202020202 |  |  |  |  | DeltaZ | 0.01 | 0.01 | 0.01 | 0.01 | 0 | 0 | 0 | 0 | 0 | 0 | 0 | 0
EpsilonY | 0.0007288689172 |  |  |  |  | Resulting Random Angular error motions about center of stiffness
EpsilonZ | 0.000202020202 |  |  |  |  | EpsilonX | 0.0002020202061 | 0.0002020202061 | 0.0002020201979 | 0.0002020201979 | 0 | 0 | 0 | 0 | 0 | 0 | 0 | 0
Net Systematic RMS (to account for elastic averaging) error motions of points connecting adjacent CS |  |  |  |  |  | EpsilonY | 0.0002499999938 | 0.0009999999 | 0.0009999999 | 0.0002499999938 | 0 | 0 | 0 | 0 | 0 | 0 | 0 | 0
DeltaX | 0 |  |  |  |  | EpsilonZ | 0.0002020202061 | 0.0002020202061 | 0.0002020201979 | 0.0002020201979 | 0 | 0 | 0 | 0 | 0 | 0 | 0 | 0
DeltaY | 0 |  |  |  |  | Systematic Translational Error motions of attachment points (e.g., machining tolerance), ENTER ALL ZEROS OR ALL VALUES FOR A POINT SHOULD BE THE SAME
DeltaZ | 0 |  |  |  |  | DeltaX | 0 | 0 | 0 | 0 | 0 | 0 | 0 | 0 | 0 | 0 | 0 | 0
EpsilonX | 0 |  |  |  |  | DeltaY | 0 | 0 | 0 | 0 | 0 | 0 | 0 | 0 | 0 | 0 | 0 | 0
EpsilonY | 0 |  |  |  |  | DeltaZ | 0 | 0 | 0 | 0 | 0 | 0 | 0 | 0 | 0 | 0 | 0 | 0
EpsilonZ | 0 |  |  |  |  | Resulting Systematic Angular error motions about center of stiffness (each point's angular errors are RSS'd for puspose of assumed spring equilibrium)
 |  |  |  |  |  | EpsilonX | 0 | 0 | 0 | 0 | 0 | 0 | 0 | 0 | 0 | 0 | 0 | 0
 |  |  |  |  |  | EpsilonY | 0 | 0 | 0 | 0 | 0 | 0 | 0 | 0 | 0 | 0 | 0 | 0
 |  |  |  |  |  | EpsilonZ | 0 | 0 | 0 | 0 | 0 | 0 | 0 | 0 | 0 | 0 | 0 | 0
 |  |  |  |  |  | Rotation calculations for random errors from attachment points: logic enables user to just enter coordinates of bearing blocks and running parallelism errors
 |  |  |  |  |  |  | rndm EpsilonX
 |  |  |  |  |  | rotation condition | 0.0002499999938 | 0.0009999999 | 0.0009999999 | 0.0002499999938 | 0 | 0 | 0 | 0 | 0 | 0 | 0 | 0
 |  |  |  |  |  | rotation condition | 0.0002020202061 | 0.0002020202061 | 0.0002020201979 | 0.0002020201979 | 0 | 0 | 0 | 0 | 0 | 0 | 0 | 0
 |  |  |  |  |  | result | 0.0002020202061 | 0.0002020202061 | 0.0002020201979 | 0.0002020201979 | 0 | 0 | 0 | 0 | 0 | 0 | 0 | 0
 |  |  |  |  |  |  | rndm EpsilonY
 |  |  |  |  |  | rotation condition | 10000 | 10000 | 10000 | 10000 | 0 | 0 | 0 | 0 | 0 | 0 | 0 | 0
 |  |  |  |  |  | rotation condition | 0.0002499999938 | 0.0009999999 | 0.0009999999 | 0.0002499999938 | 0.0 | 0.0 | 0.0 | 0.0 | 0.0 | 0.0 | 0.0 | 0.0
 |  |  |  |  |  | result | 0.0002499999938 | 0.0009999999 | 0.0009999999 | 0.0002499999938 | 0 | 0 | 0 | 0 | 0 | 0 | 0 | 0
 |  |  |  |  |  |  | rndm EpsilonZ
 |  |  |  |  |  | rotation condition | 10000 | 10000 | 10000 | 10000 | 0 | 0 | 0 | 0 | 0 | 0 | 0 | 0
 |  |  |  |  |  | rotation condition | 0.0002020202061 | 0.0002020202061 | 0.0002020201979 | 0.0002020201979 | 0 | 0 | 0 | 0 | 0 | 0 | 0 | 0
 |  |  |  |  |  | result | 0.0002020202061 | 0.0002020202061 | 0.0002020201979 | 0.0002020201979 | 0 | 0 | 0 | 0 | 0 | 0 | 0 | 0
 |  |  |  |  |  | Rotation calculations for systematic errors from attachment points: logic enables user to just enter coordinates of of mounting points and mounting point errors
 |  |  |  |  |  |  | sys EpsilonX
 |  |  |  |  |  | rotation condition | 0 | 0 | 0 | 0 | 0 | 0 | 0 | 0 | 0 | 0 | 0 | 0
 |  |  |  |  |  | rotation condition | 0.00000 | 0.00000 | 0.00000 | 0.00000 | 0.00000 | 0.00000 | 0.00000 | 0.00000 | 0.00000 | 0.00000 | 0.00000 | 0.00000
 |  |  |  |  |  | sign | 1 | 1 | 1 | 1 | 1 | 1 | 1 | 1 | 1 | 1 | 1 | 1
 |  |  |  |  |  | result | 0 | 0 | 0 | 0 | 0 | 0 | 0 | 0 | 0 | 0 | 0 | 0
 |  |  |  |  |  |  | sys EpsilonY
 |  |  |  |  |  | rotation condition | 0 | 0 | 0 | 0 | 0 | 0 | 0 | 0 | 0 | 0 | 0 | 0
 |  |  |  |  |  | rotation condition | 0 | 0 | 0 | 0 | 0 | 0 | 0 | 0 | 0 | 0 | 0 | 0
 |  |  |  |  |  | sign | 1 | 1 | 1 | 1 | 1 | 1 | 1 | 1 | 1 | 1 | 1 | 1
 |  |  |  |  |  | result | 0 | 0 | 0 | 0 | 0 | 0 | 0 | 0 | 0 | 0 | 0 | 0
 |  |  |  |  |  |  | sys EpsilonZ
 |  |  |  |  |  | rotation condition | 0 | 0 | 0 | 0 | 0 | 0 | 0 | 0 | 0 | 0 | 0 | 0
 |  |  |  |  |  | rotation condition | 0 | 0 | 0 | 0 | 0 | 0 | 0 | 0 | 0 | 0 | 0 | 0
 |  |  |  |  |  | sign | 1 | 1 | 1 | 1 | 1 | 1 | 1 | 1 | 1 | 1 | 1 | 1
 |  |  |  |  |  | result | 0 | 0 | 0 | 0 | 0 | 0 | 0 | 0 | 0 | 0 | 0 | 0

Sheet: CS_5 Leg
CS 5 | Leg
Geometric errors at CS origin and location and stiffness of points (or bearings) of attachment between coordinate systems
Error motions of CS Origin along & about its axes. Values read used by "Coordinate Systems" worksheet |  |  |  | CAREFUL as this compliance matrix is referenced in the worksheet "CSs and Loads"
Element | Leg | Bearings (if values needed for this CS) |  | Leg simply supported, two members modelled as one
Structure type | Cantilever | Size (e.g., rail width) | 25 | dx | _ = _ | 0.001228983401 | 0 | 0 | 0 | 0 | -0.03981906218 | Fx
Material | european steamed beech | Fmax (N) | 17346 | dy |  | 0 | 6.371049949e-06 | 0 | 0 | 0 | 0 | Fy
Young's Modulus (N/mm^2) | 10900 | k @ medium preload (N/mm) | 647000 | dz |  | 0 | 0 | 0.0006371049949 | 3.822629969e-06 | 0 | 0 | Fz
Poison ratio | 0.334 | ball diameter (mm) | 3 | thetaX |  | 0 | 0 | 3.822629969e-06 | 3.058103976e-08 | 0 | 0 | Mx
Shear modulus (N/mm^2) | 4085.457271 | % deflection max load | 0.01 | thetaY |  | 0 | 0 | 0 | 0 | 1.507933075e-09 | 0 | My
Beam properties (rectangular tube, or round, else customize) |  | stiffness est (N/mm) | 578200 | thetaZ |  | -0.03981906218 | 0 | 0 | 0 | 0 | 5.899120323e-08 | Mz
Position along beam | 250 | rail width (mm) | 25 |  |  | Fx | Fy | Fz | Mx | My | Mz
Length (mm) | 250 | roll rotary stiffness (Nmm/radian) | 101093750
Height (Z direction) (mm) (or diameter) | 50 | pitch rotary stiffness (Nmm/radian) | 33697916.67
Width (X direction) (mm), or fraction of solid cylinder | 36 | yaw rotary stiffness (Nmm/radian) | 33697916.67
wall (mm) | - | servo system (if values needed for this CS)
Area (mm^2) | 1800 | Ballscrew
I width dimension of beam // nuetral axis (mm^4) | 194400 | Root diameter (mm) | 18
I height dimension of beam // nuetral axis (mm^4) | 375000 | Length (mm) | 2500
Ipolar (mm^4) | 569400 | Modulus | 200000
I/A stiffness to weight ratio | 208.3333333 | shaft stiffness | 20357.5204
simply supported stiffness about Izz (N/mm) | 12556.8 | factor to derate stiffness of shaft for nut, mounting etc | 3
Notes: Careful of the sign on the compliances wrt coordinate systems!
Net stiffness of CS origin (POA@Center of Stiffness) due to attachment points |  | Servo stiffness (if applicable, else make sure to enter "0"
Linear stiffness
KX | 4000000 | 0 |  |  |  | Application note: IF using a purchased linear table with mfg specs for stuffness and accuracy, just enter "1" for number of attach points and then the stiffness and error motion data from the catalog for that "point" (the entire table)
KY | 4000000 | 0 |  |  |  | CRITICAL: Enter Total number of bearing or attachment points (up to 12) AND zero out numbers in fields for points not used!
KZ | 4000000 | 0 |  |  |  | Number of attach points = | 4
Rotation stiffness |  |  |  |  |  |  | Attachment points between current CS origin and next CS: usually in a plane
KrotX | 10004000000 | 0 |  |  |  | location in axis CS | 1 | 2 | 3 | 4 | 5 | 6 | 7 | 8 | 9 | 10 | 11 | 12
KrotY | 20004000000 | 0 |  |  |  | X | 50 | -50 | -50 | 50 | 0 | 0 | 0 | 0 | 0 | 0 | 0 | 0
KrotZ | 10004000000 | 0 |  |  |  | Y | 0 | 0 | 0 | 0 | 0 | 0 | 0 | 0 | 0 | 0 | 0 | 0
Application note: IF using a purchased axis with mfg specs for stiffness and accuracy, just enter "1" for number of attach points and then the stiffness and error motion data from the catalog for that "point" (the entire table) |  |  |  |  |  | Z | 50 | 50 | -50 | -50 | 0 | 0 | 0 | 0 | 0 | 0 | 0 | 0
 |  |  |  |  |  | Linear stiffness at the point | Assume bolted joint
 |  |  |  |  |  | KX | 1000000 | 1000000 | 1000000 | 1000000 | 0 | 0 | 0 | 0 | 0 | 0 | 0 | 0
Additional angular error motions (in event of using a modular axis) |  |  |  |  |  | KY | 1000000 | 1000000 | 1000000 | 1000000 | 0 | 0 | 0 | 0 | 0 | 0 | 0 | 0
Random |  |  |  |  |  | KZ | 1000000 | 1000000 | 1000000 | 1000000 | 0 | 0 | 0 | 0 | 0 | 0 | 0 | 0
EpsilonX (radians) | 0 |  |  |  |  | Rotation stiffness at the point
EpsilonY (radians) | 0 |  |  |  |  | KrotX | 1000000 | 1000000 | 1000000 | 1000000 | 0 | 0 | 0 | 0 | 0 | 0 | 0 | 0
EpsilonZ (radians) | 0 |  |  |  |  | KrotY | 1000000 | 1000000 | 1000000 | 1000000 | 0 | 0 | 0 | 0 | 0 | 0 | 0 | 0
Systematic |  |  |  |  |  | KrotZ | 1000000 | 1000000 | 1000000 | 1000000 | 0 | 0 | 0 | 0 | 0 | 0 | 0 | 0
EpsilonX (radians) | 0 |  |  |  |  | Effective contribution of linear stiffness to rotation stiffness about center of stiffness
EpsilonY (radians) | 0 |  |  |  |  | KrotX | 2500000000 | 2500000000 | 2500000000 | 2500000000 | 0 | 0 | 0 | 0 | 0 | 0 | 0 | 0
EpsilonZ (radians) | 0 |  |  |  |  | KrotY | 5000000000 | 5000000000 | 5000000000 | 5000000000 | 0 | 0 | 0 | 0 | 0 | 0 | 0 | 0
Net Random RMS error motions of points connecting adjacent CS |  |  |  |  |  | KrotZ | 2500000000 | 2500000000 | 2500000000 | 2500000000 | 0 | 0 | 0 | 0 | 0 | 0 | 0 | 0
DeltaX | 0.01 |  |  |  |  | Random Translational (e.g., running parallelism) error motions of attachment points, NO ZEROS FOR POINTS IN USE, INCLUDING ALONG SERVO AXIS, AT A MINIMUM MAKE SERVO DIRECTION = RUNNING PARALLISM
DeltaY | 0.01 |  |  |  |  | DeltaX | 0.01 | 0.01 | 0.01 | 0.01 | 0 | 0 | 0 | 0 | 0 | 0 | 0 | 0
DeltaZ | 0.01 |  |  |  |  | DeltaY | 0.01 | 0.01 | 0.01 | 0.01 | 0 | 0 | 0 | 0 | 0 | 0 | 0 | 0
EpsilonX | 0.0002 |  |  |  |  | DeltaZ | 0.01 | 0.01 | 0.01 | 0.01 | 0 | 0 | 0 | 0 | 0 | 0 | 0 | 0
EpsilonY | 0.000199999998 |  |  |  |  | Resulting Random Angular error motions about center of stiffness
EpsilonZ | 0.0002 |  |  |  |  | EpsilonX | 0.000199999996 | 0.000199999996 | 0.000200000004 | 0.000200000004 | 0 | 0 | 0 | 0 | 0 | 0 | 0 | 0
Net Systematic RMS (to account for elastic averaging) error motions of points connecting adjacent CS |  |  |  |  |  | EpsilonY | 0.000199999996 | 0.000199999996 | 0.000200000004 | 0.000199999996 | 0 | 0 | 0 | 0 | 0 | 0 | 0 | 0
DeltaX | 0 |  |  |  |  | EpsilonZ | 0.000199999996 | 0.000200000004 | 0.000200000004 | 0.000199999996 | 0 | 0 | 0 | 0 | 0 | 0 | 0 | 0
DeltaY | 0 |  |  |  |  | Systematic Translational Error motions of attachment points (e.g., machining tolerance), ENTER ALL ZEROS OR ALL VALUES FOR A POINT SHOULD BE THE SAME
DeltaZ | 0 |  |  |  |  | DeltaX | 0 | 0 | 0 | 0 | 0 | 0 | 0 | 0 | 0 | 0 | 0 | 0
EpsilonX | 0 |  |  |  |  | DeltaY | 0 | 0 | 0 | 0 | 0 | 0 | 0 | 0 | 0 | 0 | 0 | 0
EpsilonY | 0 |  |  |  |  | DeltaZ | 0 | 0 | 0 | 0 | 0 | 0 | 0 | 0 | 0 | 0 | 0 | 0
EpsilonZ | 0 |  |  |  |  | Resulting Systematic Angular error motions about center of stiffness (each point's angular errors are RSS'd for puspose of assumed spring equilibrium)
 |  |  |  |  |  | EpsilonX | 0 | 0 | 0 | 0 | 0 | 0 | 0 | 0 | 0 | 0 | 0 | 0
 |  |  |  |  |  | EpsilonY | 0 | 0 | 0 | 0 | 0 | 0 | 0 | 0 | 0 | 0 | 0 | 0
 |  |  |  |  |  | EpsilonZ | 0 | 0 | 0 | 0 | 0 | 0 | 0 | 0 | 0 | 0 | 0 | 0
 |  |  |  |  |  |  |  |  |  |  |  |  |  |  |  |  |  | 0
 |  |  |  |  |  | Rotation calculations for random errors from attachment points: logic enables user to just enter coordinates of bearing blocks and running parallelism errors
 |  |  |  |  |  |  | rndm EpsilonX
 |  |  |  |  |  | rotation condition | 0.000199999996 | 0.000199999996 | 0.000200000004 | 0.000200000004 | 0 | 0 | 0 | 0 | 0 | 0 | 0 | 0
 |  |  |  |  |  | rotation condition | 10000 | 10000 | 10000 | 10000 | 0 | 0 | 0 | 0 | 0 | 0 | 0 | 0
 |  |  |  |  |  | result | 0.000199999996 | 0.000199999996 | 0.000200000004 | 0.000200000004 | 0 | 0 | 0 | 0 | 0 | 0 | 0 | 0
 |  |  |  |  |  |  | rndm EpsilonY
 |  |  |  |  |  | rotation condition | 0.000199999996 | 0.000200000004 | 0.000200000004 | 0.000199999996 | 0 | 0 | 0 | 0 | 0 | 0 | 0 | 0
 |  |  |  |  |  | rotation condition | 0.000199999996 | 0.000199999996 | 0.000200000004 | 0.000200000004 | 0.0 | 0.0 | 0.0 | 0.0 | 0.0 | 0.0 | 0.0 | 0.0
 |  |  |  |  |  | result | 0.000199999996 | 0.000199999996 | 0.000200000004 | 0.000199999996 | 0 | 0 | 0 | 0 | 0 | 0 | 0 | 0
 |  |  |  |  |  |  | rndm EpsilonZ
 |  |  |  |  |  | rotation condition | 0.000199999996 | 0.000200000004 | 0.000200000004 | 0.000199999996 | 0 | 0 | 0 | 0 | 0 | 0 | 0 | 0
 |  |  |  |  |  | rotation condition | 10000 | 10000 | 10000 | 10000 | 0 | 0 | 0 | 0 | 0 | 0 | 0 | 0
 |  |  |  |  |  | result | 0.000199999996 | 0.000200000004 | 0.000200000004 | 0.000199999996 | 0 | 0 | 0 | 0 | 0 | 0 | 0 | 0
 |  |  |  |  |  | Rotation calculations for systematic errors from attachment points: logic enables user to just enter coordinates of of mounting points and mounting point errors
 |  |  |  |  |  |  | sys EpsilonX
 |  |  |  |  |  | rotation condition | 0 | 0 | 0 | 0 | 0 | 0 | 0 | 0 | 0 | 0 | 0 | 0
 |  |  |  |  |  | rotation condition | 0.00000 | 0.00000 | 0.00000 | 0.00000 | 0.00000 | 0.00000 | 0.00000 | 0.00000 | 0.00000 | 0.00000 | 0.00000 | 0.00000
 |  |  |  |  |  | sign | 1 | 1 | 1 | 1 | 1 | 1 | 1 | 1 | 1 | 1 | 1 | 1
 |  |  |  |  |  | result | 0 | 0 | 0 | 0 | 0 | 0 | 0 | 0 | 0 | 0 | 0 | 0
 |  |  |  |  |  |  | sys EpsilonY
 |  |  |  |  |  | rotation condition | 0 | 0 | 0 | 0 | 0 | 0 | 0 | 0 | 0 | 0 | 0 | 0
 |  |  |  |  |  | rotation condition | 0 | 0 | 0 | 0 | 0 | 0 | 0 | 0 | 0 | 0 | 0 | 0
 |  |  |  |  |  | sign | 1 | 1 | 1 | 1 | 1 | 1 | 1 | 1 | 1 | 1 | 1 | 1
 |  |  |  |  |  | result | 0 | 0 | 0 | 0 | 0 | 0 | 0 | 0 | 0 | 0 | 0 | 0
 |  |  |  |  |  |  | sys EpsilonZ
 |  |  |  |  |  | rotation condition | 0 | 0 | 0 | 0 | 0 | 0 | 0 | 0 | 0 | 0 | 0 | 0
 |  |  |  |  |  | rotation condition | 0 | 0 | 0 | 0 | 0 | 0 | 0 | 0 | 0 | 0 | 0 | 0
 |  |  |  |  |  | sign | 1 | 1 | 1 | 1 | 1 | 1 | 1 | 1 | 1 | 1 | 1 | 1
 |  |  |  |  |  | result | 0 | 0 | 0 | 0 | 0 | 0 | 0 | 0 | 0 | 0 | 0 | 0
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
