tjankovic/2-77-ppd/desk CAD/twin_column_design/subassemblies/slider_assembly.SLDASM

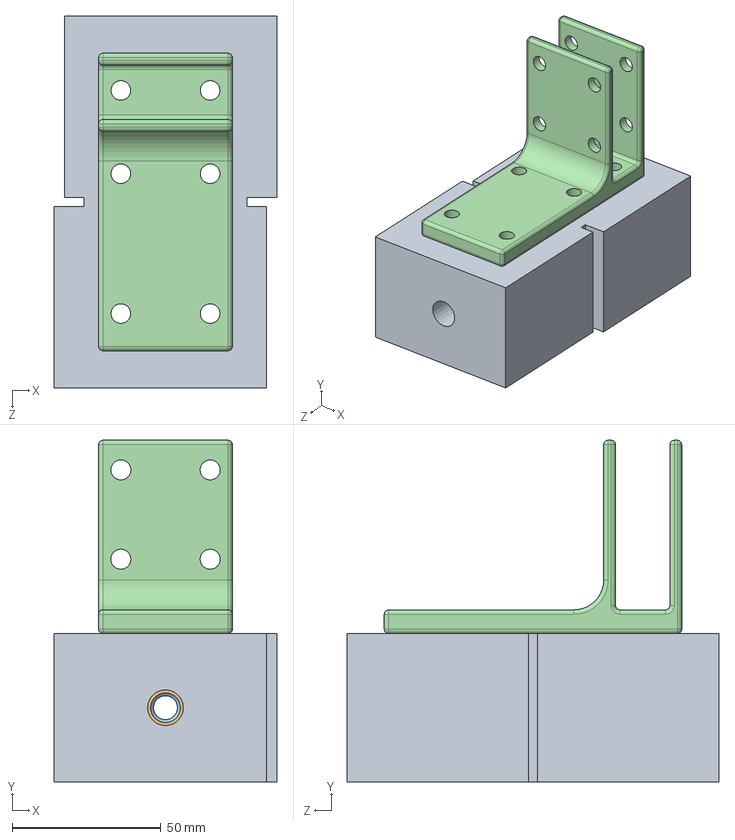
[picture p4: CAD file, 2017-05-09]
desk CAD/twin_column_design/subassemblies/slider_assembly.SLDASM
74.8 x 114.8 x 125.0 mm
slider
igus_lead_screw_cylindrical_nut_WSRM-2215TR10x2_1
igus_lead_screw_cylindrical_nut_WSRM-2215TR10x2
sandwich_bracket
