tjankovic/2-77-ppd/kinematic_coupling/CAD/R2/baseplate_assembly.SLDASM

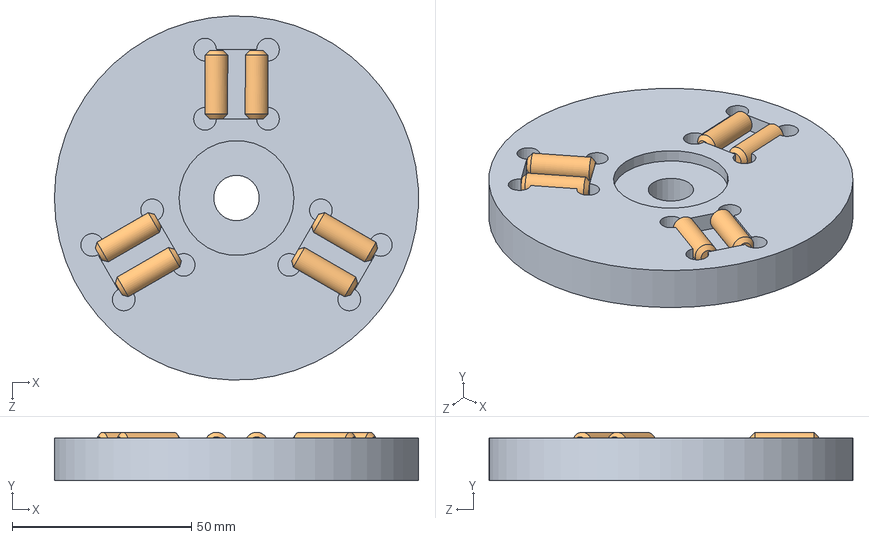
[picture p5: CAD file, 2017-02-19]
kinematic_coupling/CAD/R2/baseplate_assembly.SLDASM
101.6 x 13.5 x 101.6 mm
baseplate
dowel x 6
