tjankovic/2-77-ppd/desk CAD/twin_column_design/master_assem.SLDASM

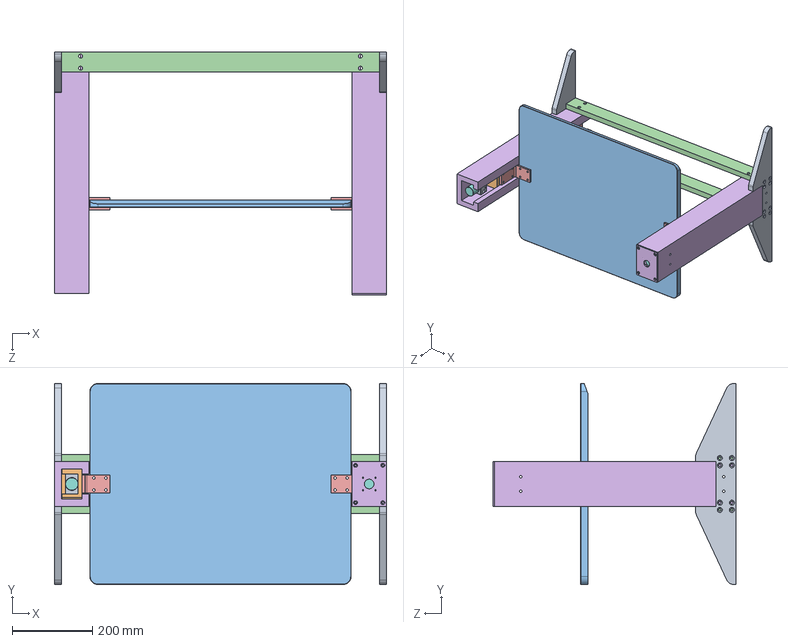
[picture p6: CAD file, 2017-05-09]
desk CAD/twin_column_design/master_assem.SLDASM
825.8 x 500.0 x 604.0 mm
leg x 2
slider x 2
igus_lead_screw_cylindrical_nut_WSRM-2215TR10x2_1 x 2
igus_lead_screw_cylindrical_nut_WSRM-2215TR10x2 x 2
sandwich_bracket x 2
boxway x 2
igus_leadscrew_metric_trapezoidal_PTGSG-10x2-01-R-550-ES x 2
igus_elastic_coupling_COU-AR-K-050-100-32-32-B-AAAA x 2
igus_leadscrew_fixed_bearing_blockSLS-10x2-FL x 2
leadscrew_block_standoff x 4
desktop
cross_tie x 2
igus_leadscrew_floating_bearing_block_SLS-10x2-LL x 2
motor_flange
