tjankovic/2-77-ppd/desk CAD/twin_column_design/subassemblies/linear_motion_axis.SLDASM

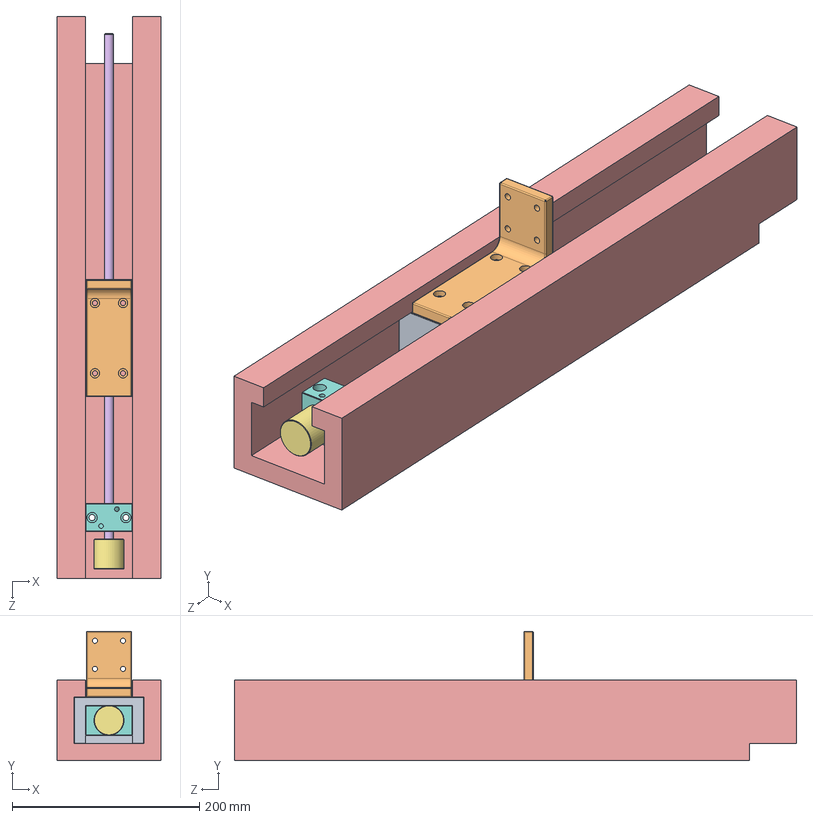
[picture p7: CAD file, 2017-04-10]
desk CAD/twin_column_design/subassemblies/linear_motion_axis.SLDASM
111.0 x 137.9 x 600.0 mm
slider
bearing_bracket
igus_lead_screw_cylindrical_nut_WSRM-2215TR10x2_1
igus_lead_screw_cylindrical_nut_WSRM-2215TR10x2
boxway
igus_leadscrew_metric_trapezoidal_PTGSG-10x2-01-R-550-ES
igus_elastic_coupling_COU-AR-K-050-100-32-32-B-AAAA
igus_leadscrew_fixed_bearing_blockSLS-10x2-FL
leadscrew_block_standoff
