tjankovic/2-77-ppd/kinematic_coupling/CAD/R2/topplate_assembly.SLDASM

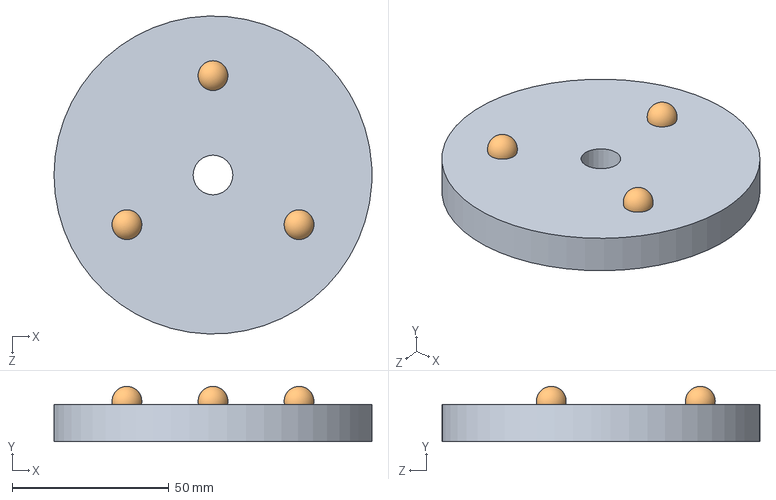
[picture p8: CAD file, 2017-02-19]
kinematic_coupling/CAD/R2/topplate_assembly.SLDASM
101.6 x 17.7 x 101.6 mm
topplate
ball x 3
