tjankovic/2-77-ppd/kinematic_coupling/CAD/R1/Assembled Coupling R1.SLDASM

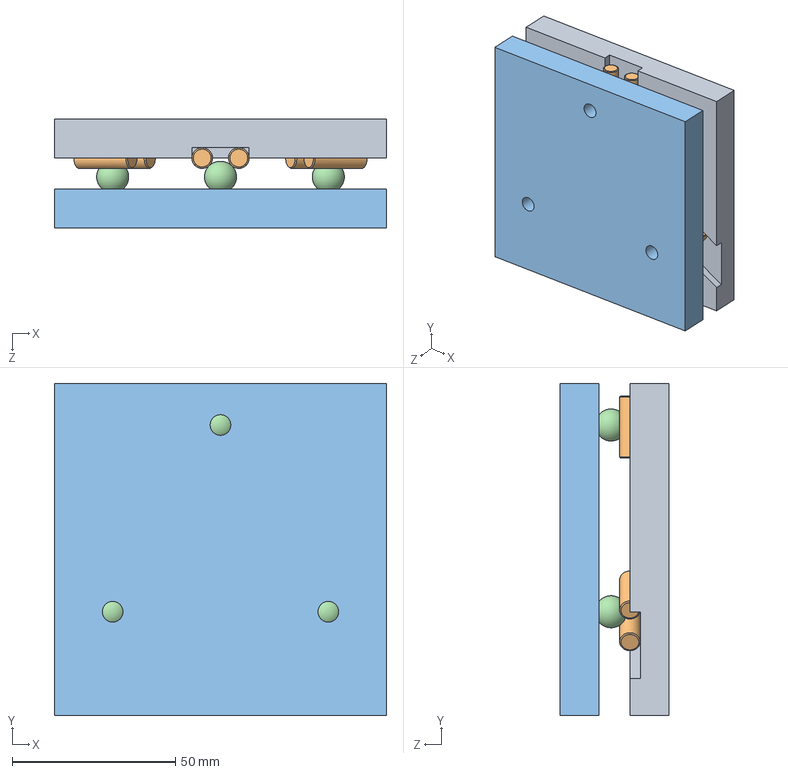
[picture p9: CAD file, 2017-02-19]
kinematic_coupling/CAD/R1/Assembled Coupling R1.SLDASM
101.6 x 101.6 x 33.4 mm
Base Plate R1
Dowel Pins R1 x 6
Top Plate R1
Ball R1 x 3
