tjankovic/2-77-ppd/linear_motion_axis/CAD/slider_assem.SLDASM

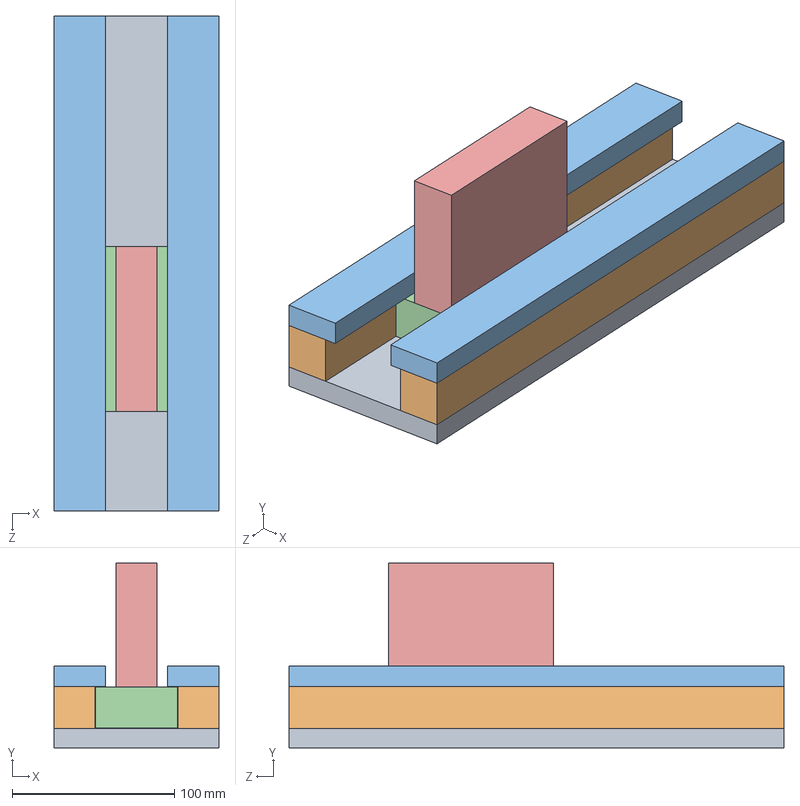
[picture p10: CAD file, 2017-03-19]
linear_motion_axis/CAD/slider_assem.SLDASM
101.6 x 113.8 x 304.8 mm
baseplate
side_plate x 2
keeper_plate x 2
slider
rail
