tjankovic/2-77-ppd/linear_motion_axis/CAD/motor_case_assembly.SLDASM

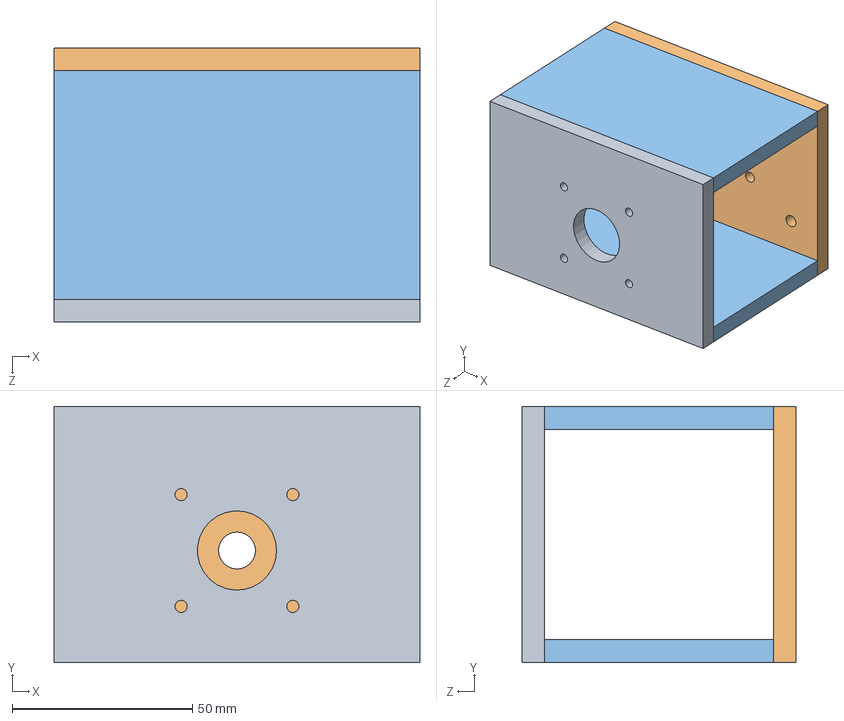
[picture p11: CAD file, 2017-03-19]
linear_motion_axis/CAD/motor_case_assembly.SLDASM
101.6 x 71.1 x 76.2 mm
motor endplate
endplate_delinked
endplate_standoff x 2
