tjankovic/2-77-ppd/kinematic_coupling/CAD/R1/Assembled Topplate R1.SLDASM

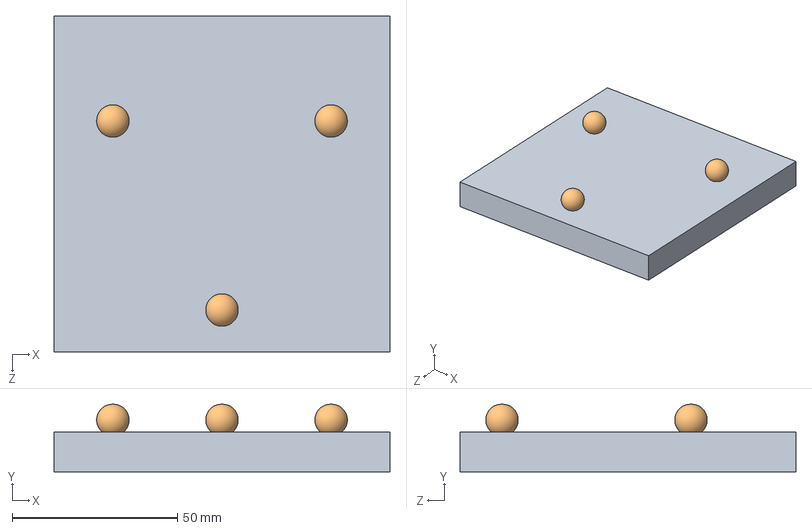
[picture p12: CAD file, 2017-02-19]
kinematic_coupling/CAD/R1/Assembled Topplate R1.SLDASM
101.6 x 20.4 x 101.6 mm
Top Plate R1
Ball R1 x 3
