tjankovic/2-77-ppd/kinematic_coupling/CAD/R2/full_assembly.SLDASM

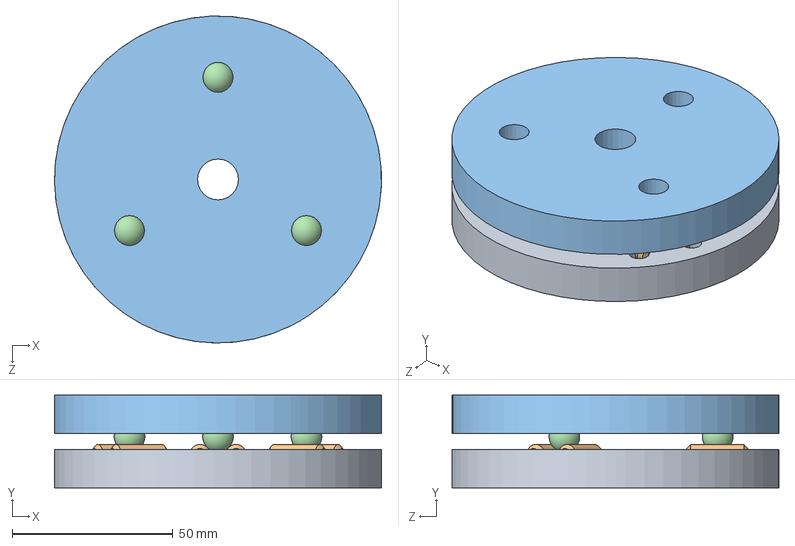
[picture p13: CAD file, 2017-02-19]
kinematic_coupling/CAD/R2/full_assembly.SLDASM
101.6 x 28.9 x 101.6 mm
baseplate
dowel x 6
topplate
ball x 3
