tjankovic/2-77-ppd/kinematic_coupling/CAD/R1/Assembled Baseplate R1.SLDASM

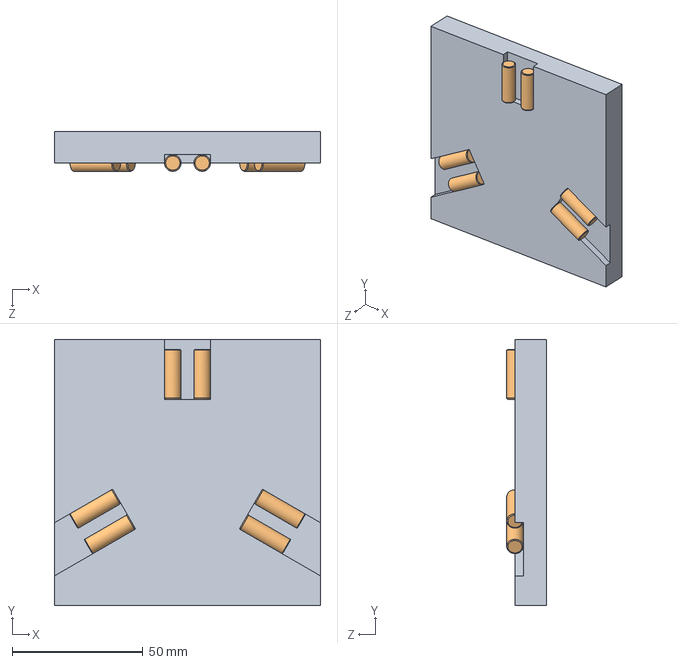
[picture p14: CAD file, 2017-02-19]
kinematic_coupling/CAD/R1/Assembled Baseplate R1.SLDASM
101.6 x 101.6 x 15.2 mm
Base Plate R1
Dowel Pins R1 x 6
