tjankovic/2-77-ppd/desk CAD/column_backplate.SLDPRT

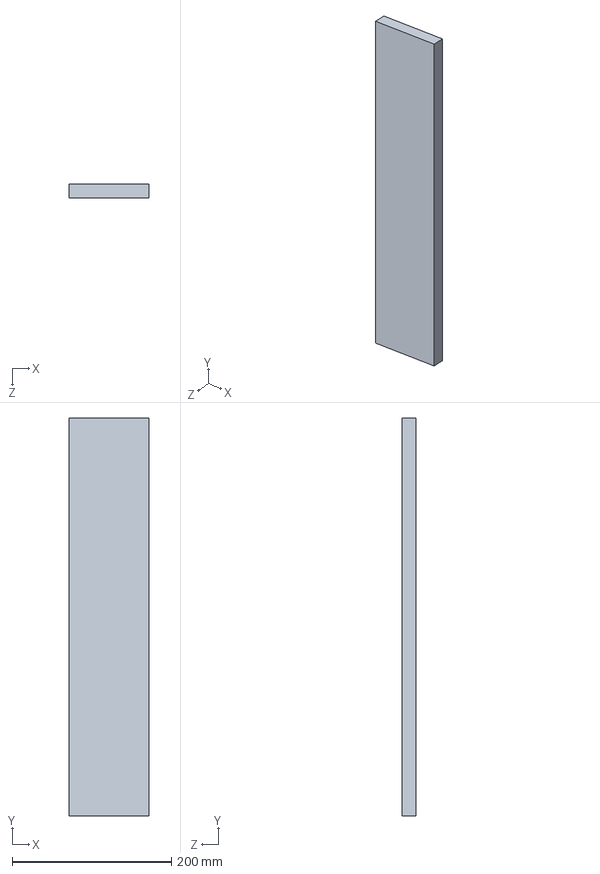
[picture p15: CAD file, 2017-03-27]
desk CAD/column_backplate.SLDPRT
100.0 x 500.0 x 18.0 mm
