tjankovic/2-77-ppd/desk CAD/twin_column_design/laser cut parts/radius template.SLDPRT

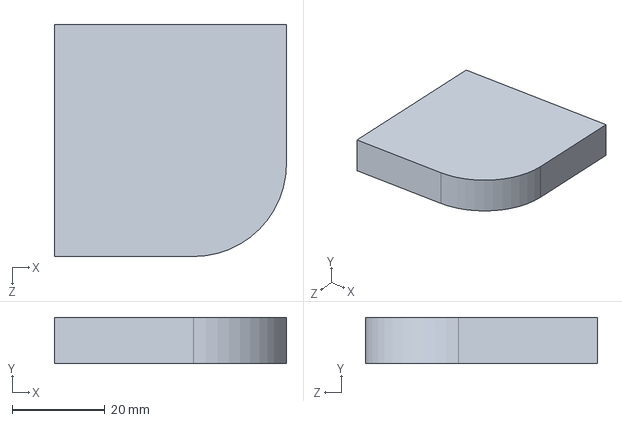
[picture p16: CAD file, 2017-05-09]
desk CAD/twin_column_design/laser cut parts/radius template.SLDPRT
50.0 x 10.0 x 50.0 mm
