tjankovic/2-77-ppd/desk CAD/twin_column_design/laser cut templates/radius template.DXF

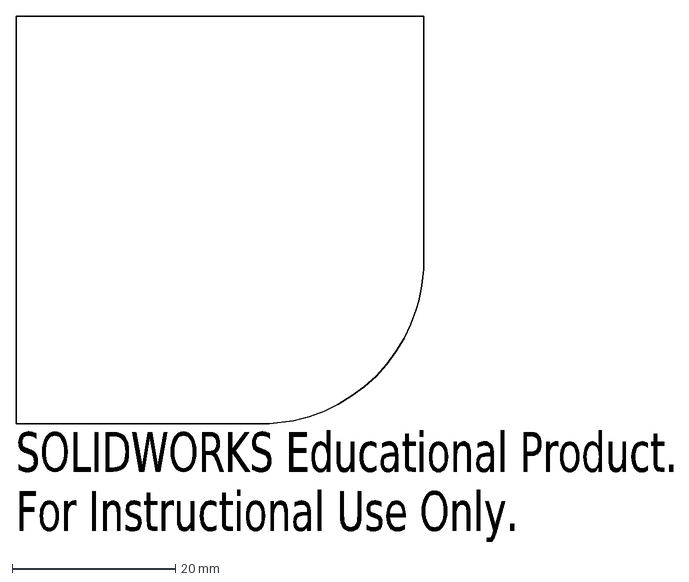
[picture p17: CAD file, 2017-05-09]
desk CAD/twin_column_design/laser cut templates/radius template.DXF
SOLIDWORKS Educational Product.
For Instructional Use Only.
