tjankovic/2-77-ppd/desk CAD/twin_column_design/new bracket/Composite/sandwich_bracket.SLDPRT

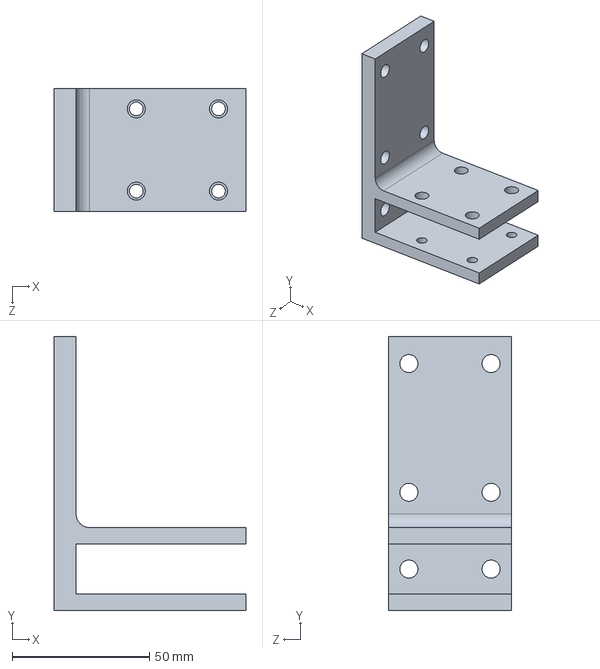
[picture p18: CAD file, 2017-05-09]
desk CAD/twin_column_design/new bracket/Composite/sandwich_bracket.SLDPRT
70.0 x 100.0 x 45.0 mm
