tjankovic/2-77-ppd/desk CAD/twin_column_design/new bracket/Steel/steel.SLDPRT

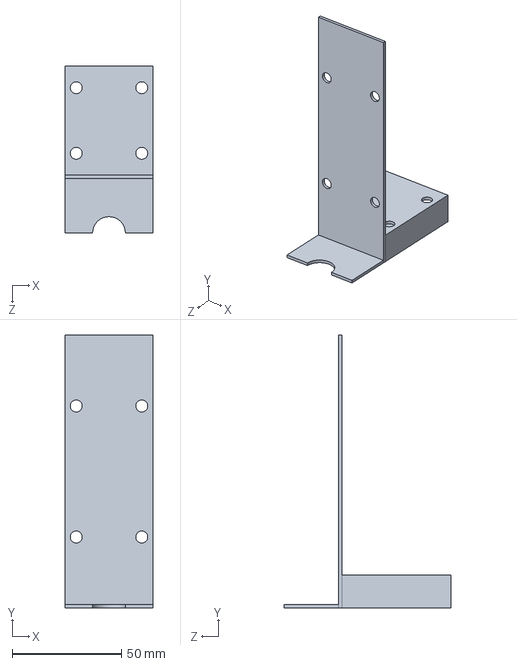
[picture p19: CAD file, 2017-04-10]
desk CAD/twin_column_design/new bracket/Steel/steel.SLDPRT
40.5 x 125.0 x 76.5 mm
