tjankovic/2-77-ppd/desk CAD/twin_column_design/slider.SLDPRT

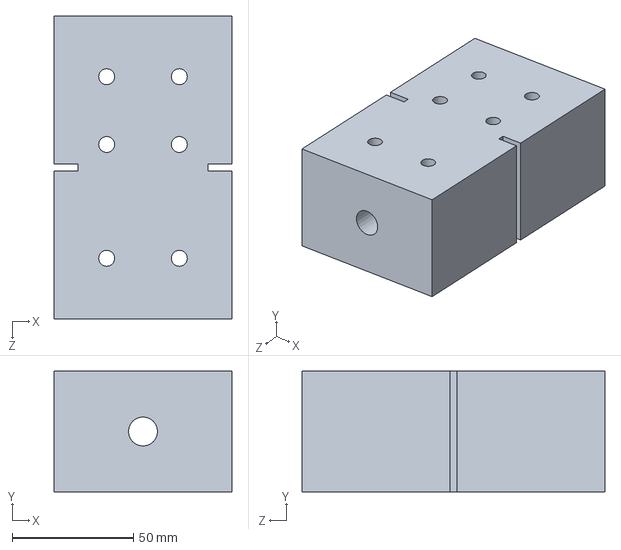
[picture p20: CAD file, 2017-05-10]
desk CAD/twin_column_design/slider.SLDPRT
73.5 x 49.8 x 125.0 mm
