tjankovic/2-77-ppd/desk CAD/twin_column_design/STLs/sandwich_bracket_1may.STL

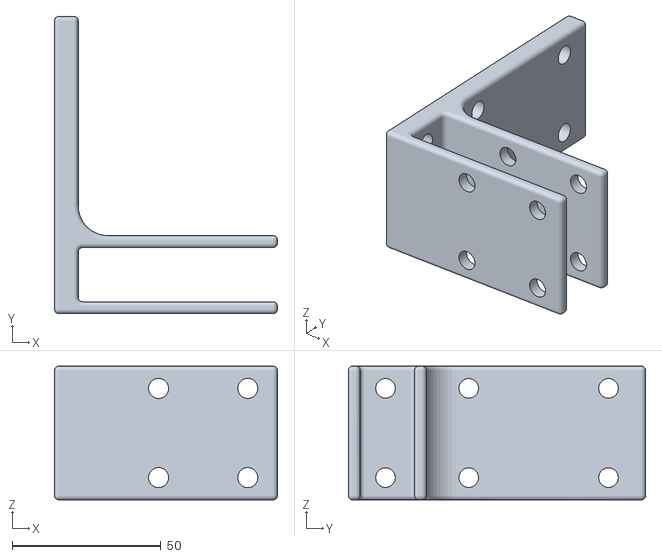
[picture p21: CAD file, 2017-05-09]
desk CAD/twin_column_design/STLs/sandwich_bracket_1may.STL
75.0 x 100.0 x 45.0
