tjankovic/2-77-ppd/kinematic_coupling/CAD/R1/Top Plate R1.SLDPRT

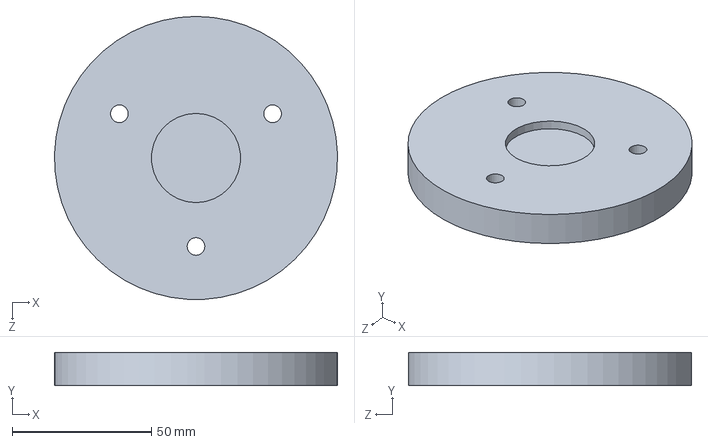
[picture p22: CAD file, 2017-02-19]
kinematic_coupling/CAD/R1/Top Plate R1.SLDPRT
101.6 x 12.0 x 101.6 mm
