tjankovic/2-77-ppd/linear_motion_axis/CAD/endplate_delinked.SLDPRT

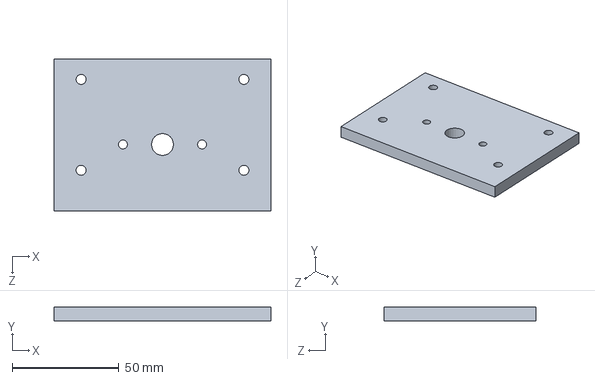
[picture p23: CAD file, 2017-03-19]
linear_motion_axis/CAD/endplate_delinked.SLDPRT
101.6 x 6.35 x 71.1 mm
