tjankovic/2-77-ppd/desk CAD/desktop.SLDPRT

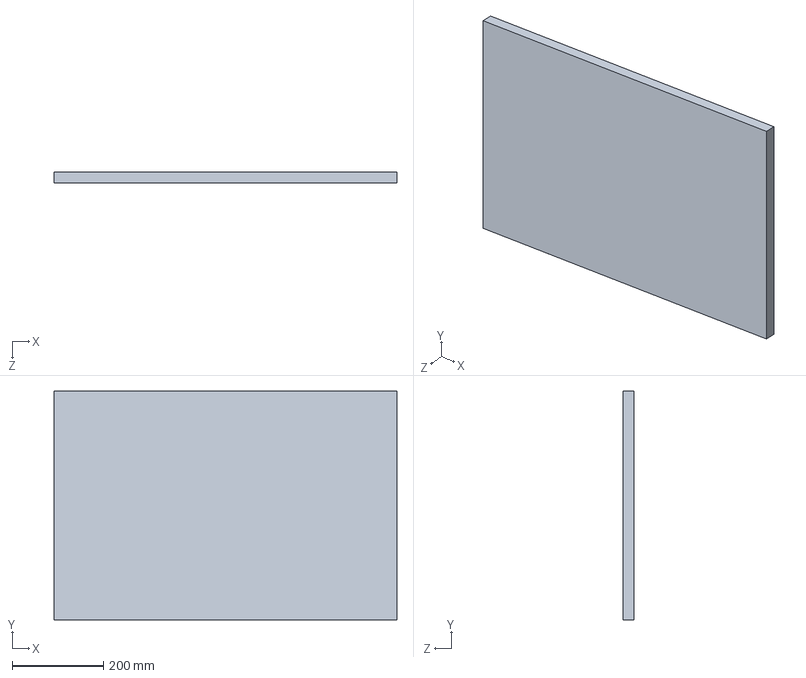
[picture p24: CAD file, 2017-03-27]
desk CAD/desktop.SLDPRT
750.0 x 500.0 x 25.0 mm
