tjankovic/2-77-ppd/desk CAD/twin_column_design/laser cut parts/motor_flange.DXF

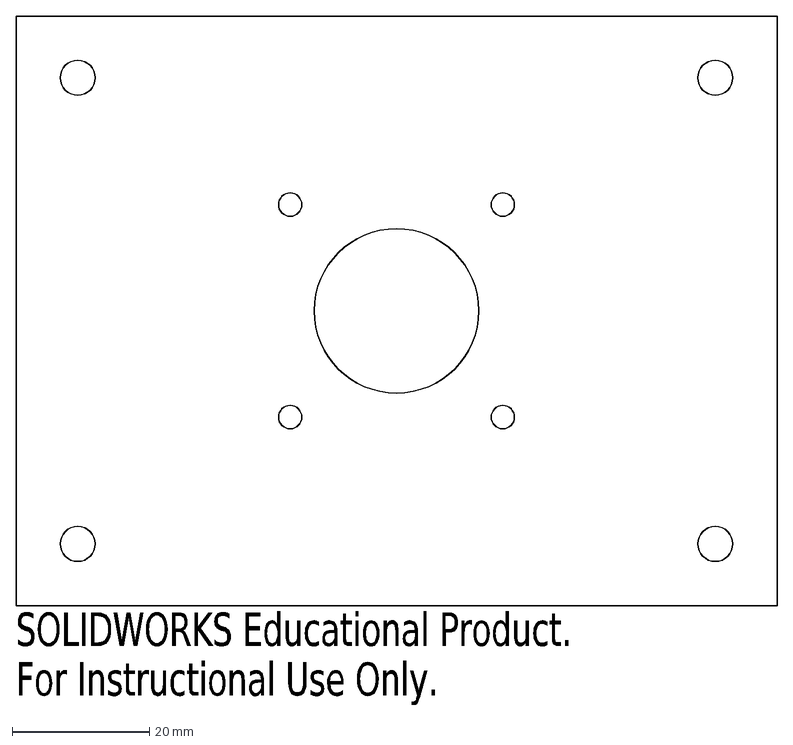
[picture p25: CAD file, 2017-05-09]
desk CAD/twin_column_design/laser cut parts/motor_flange.DXF
SOLIDWORKS Educational Product.
For Instructional Use Only.
