tjankovic/2-77-ppd/desk CAD/twin_column_design/laser cut templates/slider_apr19.DXF

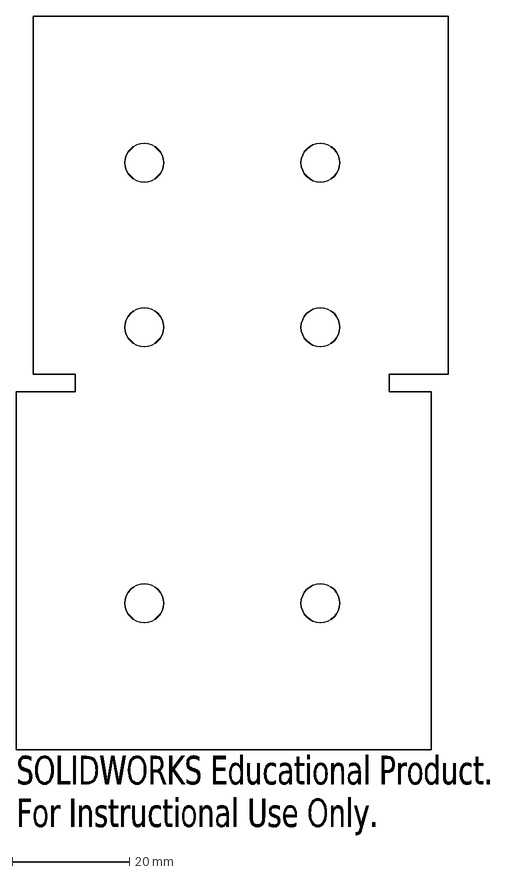
[picture p26: CAD file, 2017-04-20]
desk CAD/twin_column_design/laser cut templates/slider_apr19.DXF
SOLIDWORKS Educational Product.
For Instructional Use Only.
