tjankovic/2-77-ppd/desk CAD/twin_column_design/STLs/sandwich_bracket_17apr.STL

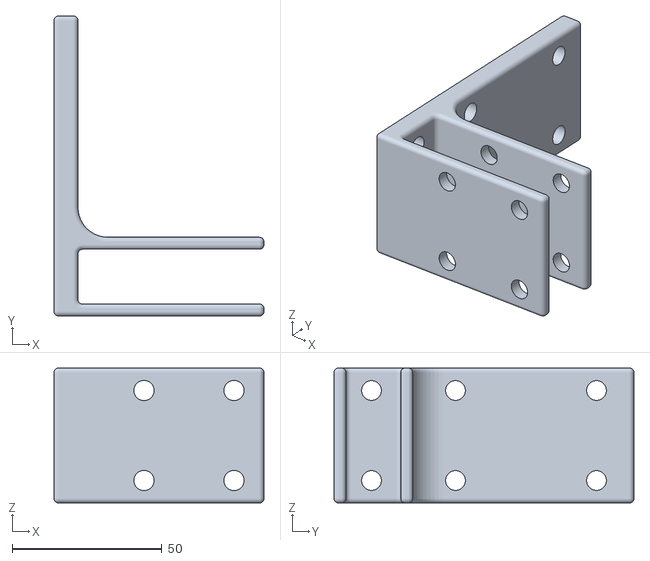
[picture p27: CAD file, 2017-04-18]
desk CAD/twin_column_design/STLs/sandwich_bracket_17apr.STL
70.0 x 100.0 x 45.0
