tjankovic/2-77-ppd/linear_motion_axis/CAD/keeper_plate.SLDPRT

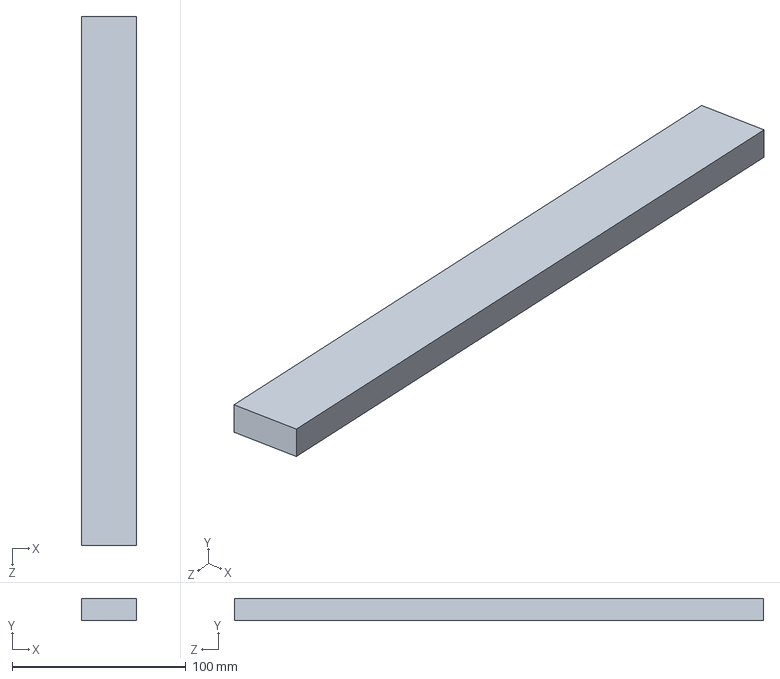
[picture p28: CAD file, 2017-03-19]
linear_motion_axis/CAD/keeper_plate.SLDPRT
31.8 x 12.7 x 304.8 mm
