tjankovic/2-77-ppd/desk CAD/twin_column_design/leg.SLDPRT

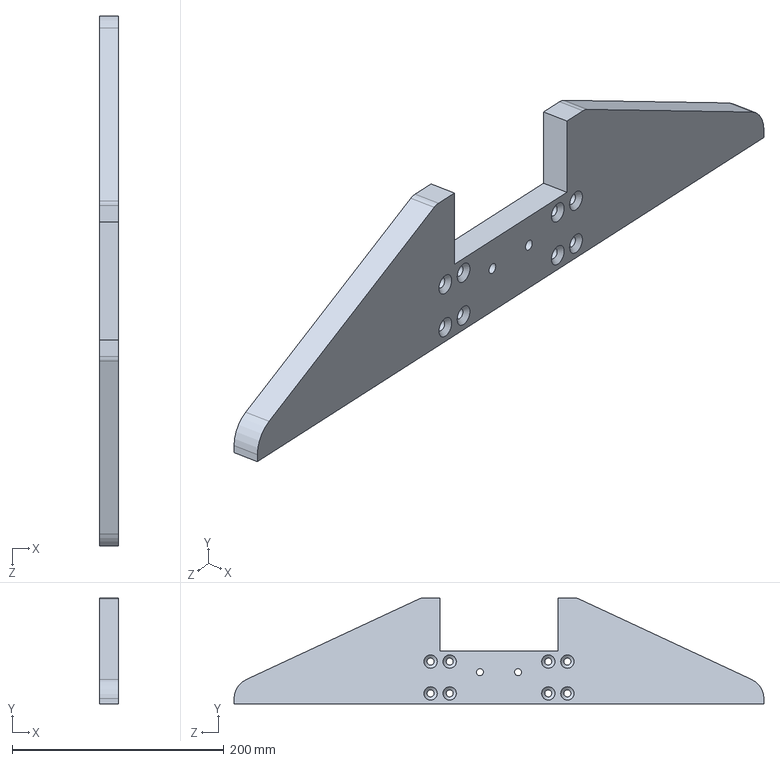
[picture p30: CAD file, 2017-04-21]
desk CAD/twin_column_design/leg.SLDPRT
18.0 x 100.0 x 500.0 mm
