tjankovic/2-77-ppd/kinematic_coupling/CAD/R2/dowel.SLDPRT

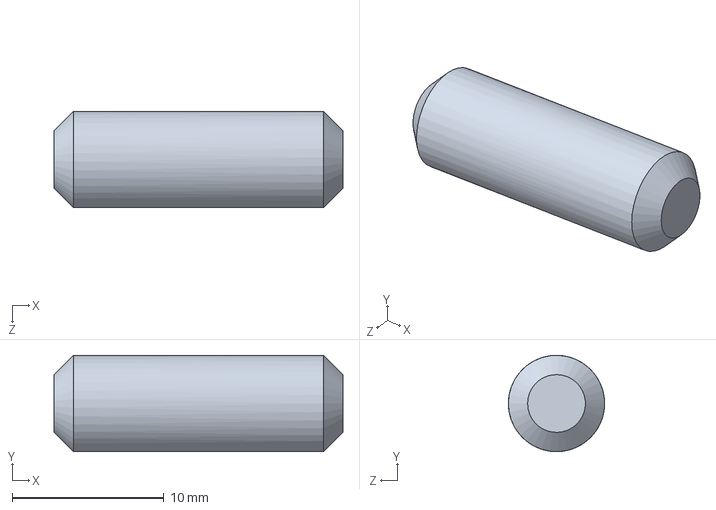
[picture p32: CAD file, 2017-02-19]
kinematic_coupling/CAD/R2/dowel.SLDPRT
19.1 x 6.34 x 6.35 mm
