tjankovic/2-77-ppd/linear_motion_axis/CAD/endplate_standoff.SLDPRT

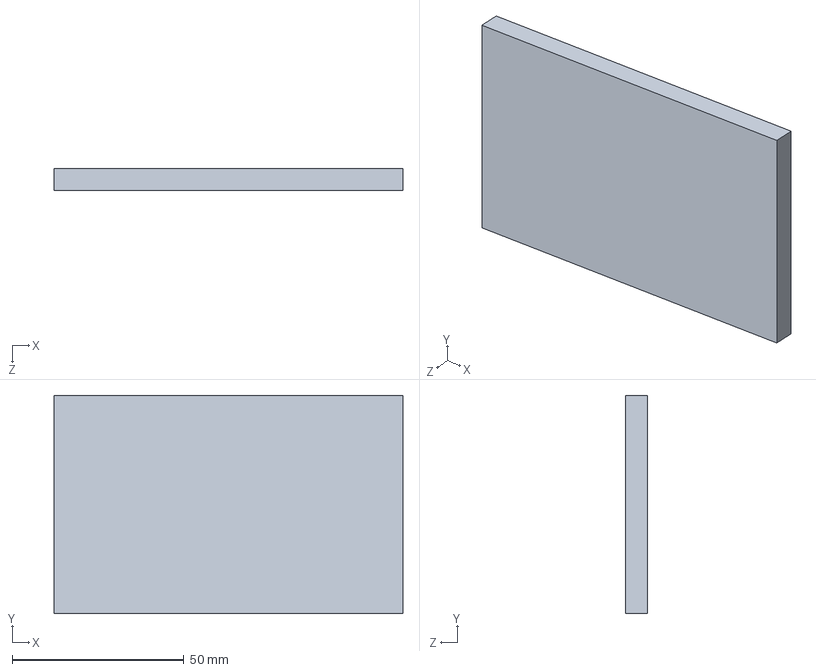
[picture p33: CAD file, 2017-03-19]
linear_motion_axis/CAD/endplate_standoff.SLDPRT
101.6 x 63.5 x 6.35 mm
