tjankovic/2-77-ppd/desk CAD/ots_components/igus_elastic_coupling_COU-AR-K-050-100-32-32-B-AAAA.sldprt

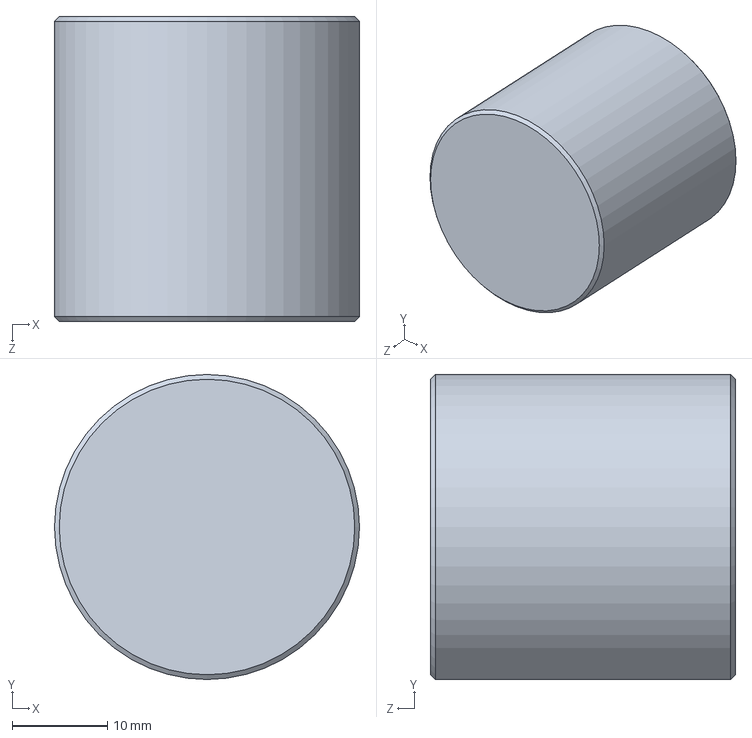
[picture p34: CAD file, 2017-03-27]
desk CAD/ots_components/igus_elastic_coupling_COU-AR-K-050-100-32-32-B-AAAA.sldprt
32.0 x 32.0 x 32.0 mm
