tjankovic/2-77-ppd/desk CAD/twin_column_design/boxway.SLDPRT

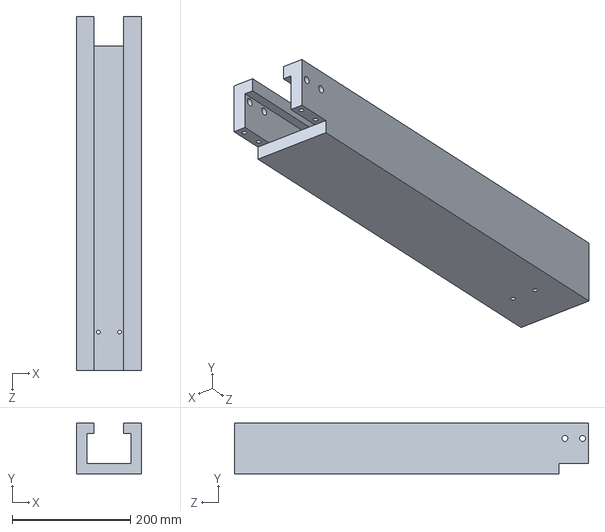
[picture p35: CAD file, 2017-04-21]
desk CAD/twin_column_design/boxway.SLDPRT
111.0 x 86.0 x 600.0 mm
