tjankovic/2-77-ppd/kinematic_coupling/CAD/R1/Base Plate R1.SLDPRT

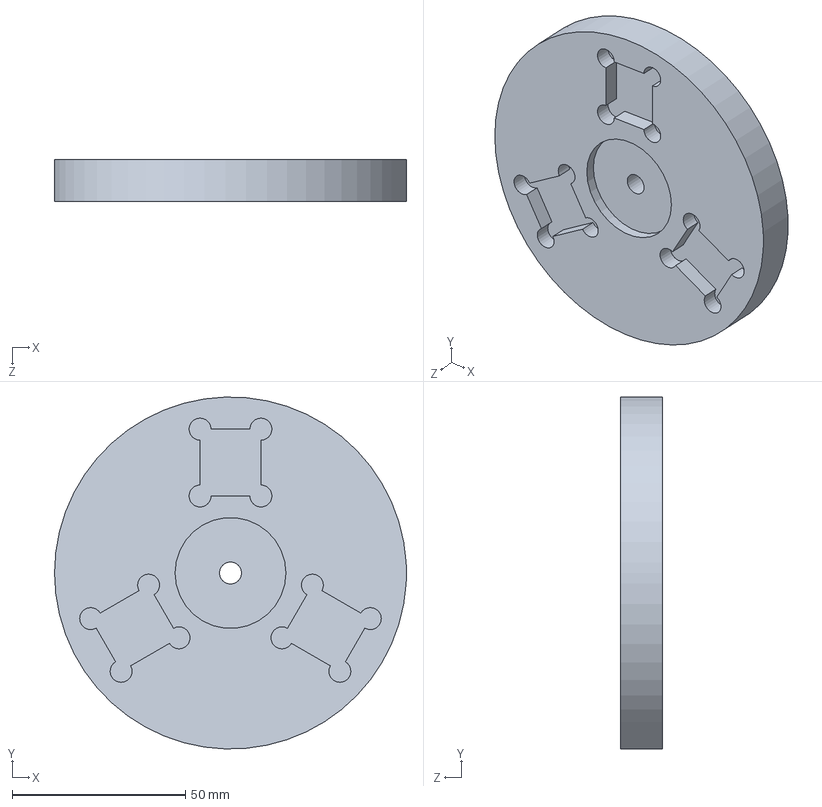
[picture p36: CAD file, 2017-02-19]
kinematic_coupling/CAD/R1/Base Plate R1.SLDPRT
101.6 x 101.6 x 12.0 mm
