tjankovic/2-77-ppd/desk CAD/twin_column_design/desktop.SLDPRT

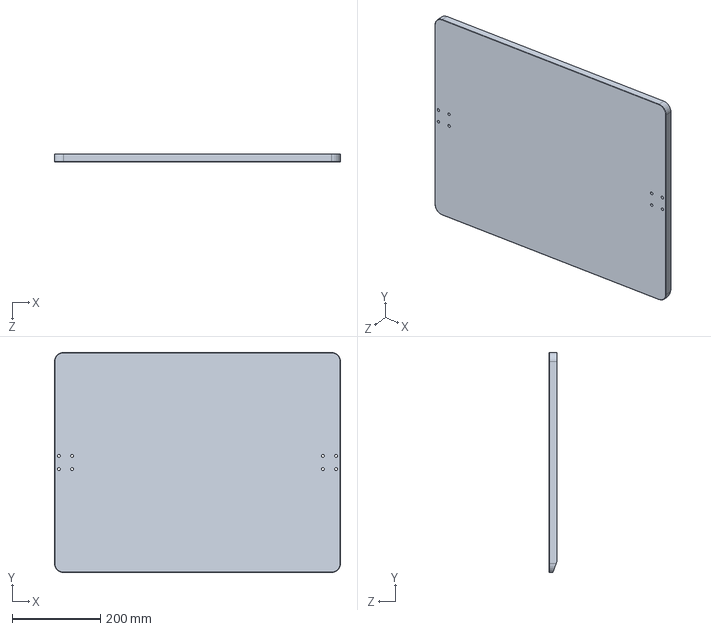
[picture p37: CAD file, 2017-04-21]
desk CAD/twin_column_design/desktop.SLDPRT
650.0 x 500.0 x 18.0 mm
