tjankovic/2-77-ppd/desk CAD/twin_column_design/laser cut templates/slider.DXF

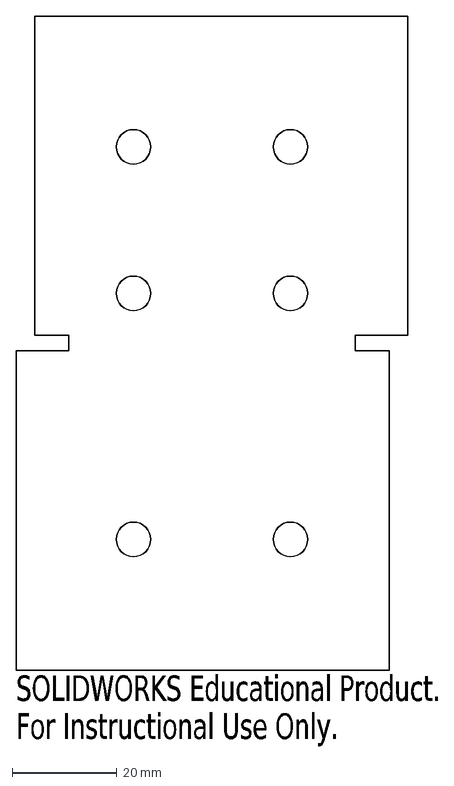
[picture p38: CAD file, 2017-04-18]
desk CAD/twin_column_design/laser cut templates/slider.DXF
SOLIDWORKS Educational Product.
For Instructional Use Only.
