tjankovic/2-77-ppd/desk CAD/twin_column_design/STLs/sandwich_bracket_9apr.STL

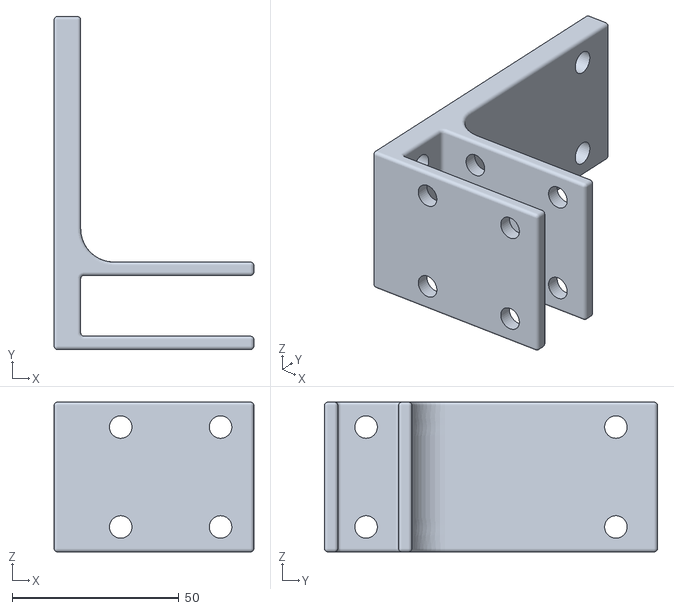
[picture p39: CAD file, 2017-04-10]
desk CAD/twin_column_design/STLs/sandwich_bracket_9apr.STL
60.0 x 100.0 x 45.0
