tjankovic/2-77-ppd/kinematic_coupling/CAD/R1/Ball R1.SLDPRT

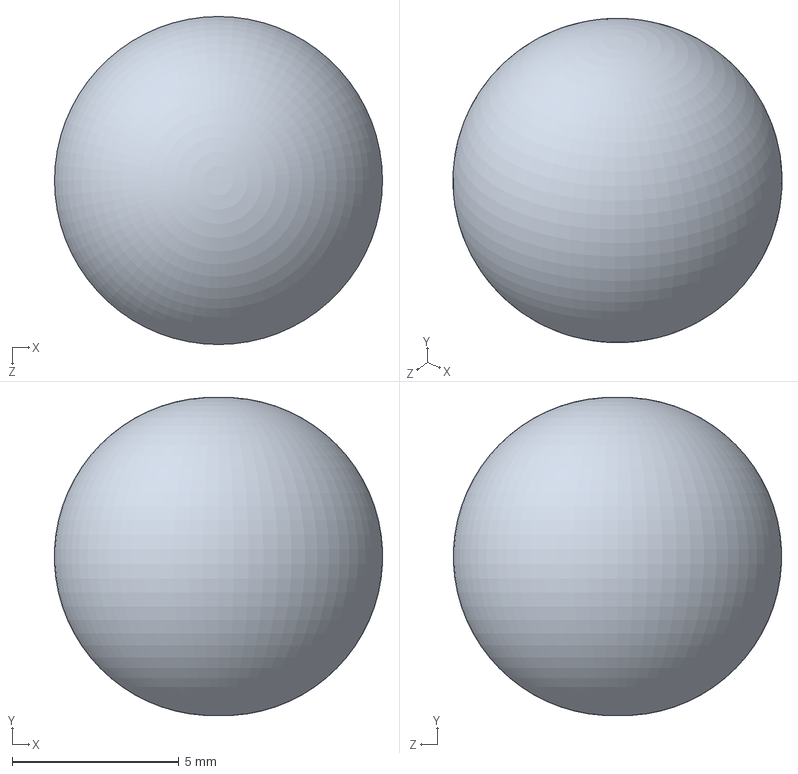
[picture p40: CAD file, 2017-02-19]
kinematic_coupling/CAD/R1/Ball R1.SLDPRT
9.82 x 9.53 x 9.82 mm
