tjankovic/2-77-ppd/linear_motion_axis/CAD/slider.SLDPRT

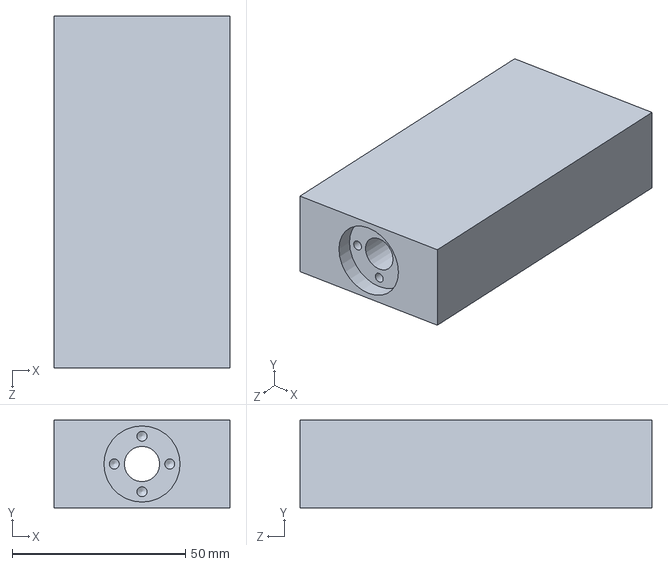
[picture p41: CAD file, 2017-03-19]
linear_motion_axis/CAD/slider.SLDPRT
50.8 x 25.4 x 101.6 mm
