tjankovic/2-77-ppd/desk CAD/twin_column_design/cross_tie.SLDPRT

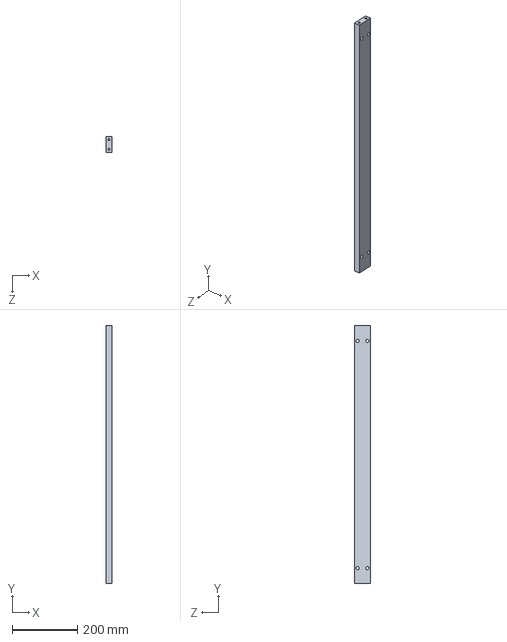
[picture p42: CAD file, 2017-04-21]
desk CAD/twin_column_design/cross_tie.SLDPRT
18.0 x 789.8 x 50.0 mm
