tjankovic/2-77-ppd/kinematic_coupling/CAD/R1/Dowel Pins R1.SLDPRT

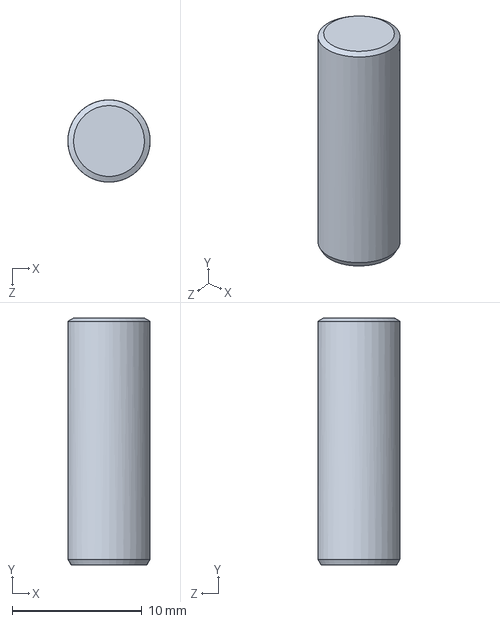
[picture p43: CAD file, 2017-02-19]
kinematic_coupling/CAD/R1/Dowel Pins R1.SLDPRT
6.34 x 19.1 x 6.35 mm
