tjankovic/2-77-ppd/kinematic_coupling/CAD/R2/ball.SLDPRT

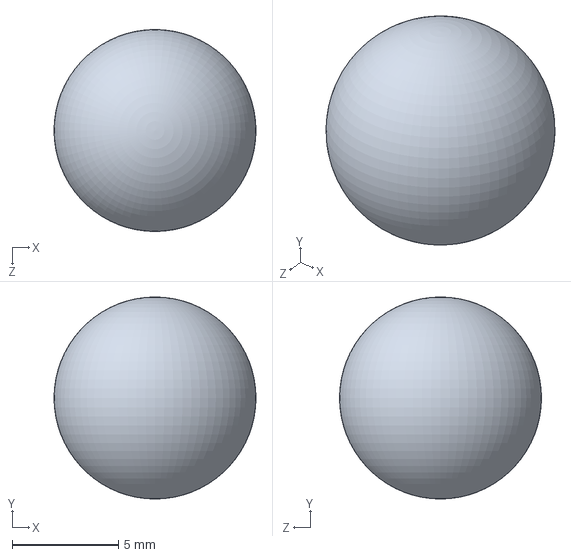
[picture p44: CAD file, 2017-02-19]
kinematic_coupling/CAD/R2/ball.SLDPRT
9.53 x 9.53 x 9.53 mm
