tjankovic/2-77-ppd/linear_motion_axis/CAD/rail.SLDPRT

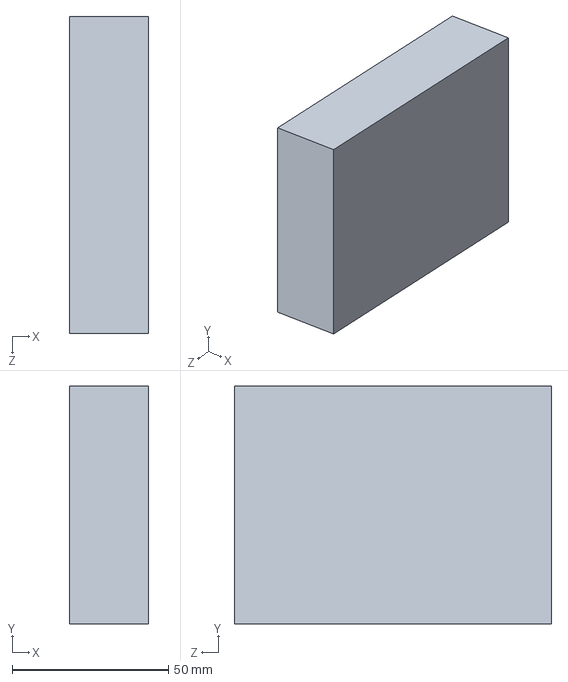
[picture p45: CAD file, 2017-03-19]
linear_motion_axis/CAD/rail.SLDPRT
25.4 x 76.2 x 101.6 mm
