tjankovic/2-77-ppd/desk CAD/twin_column_design/motor_flange.SLDPRT

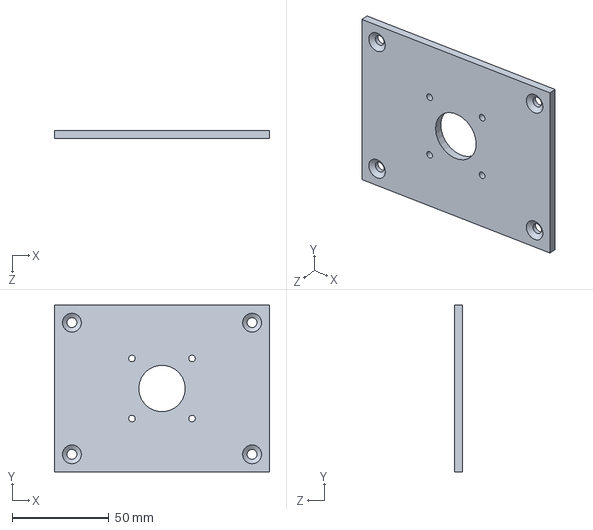
[picture p46: CAD file, 2017-04-20]
desk CAD/twin_column_design/motor_flange.SLDPRT
111.0 x 86.0 x 4.00 mm
