tjankovic/2-77-ppd/linear_motion_axis/CAD/endplate.SLDPRT

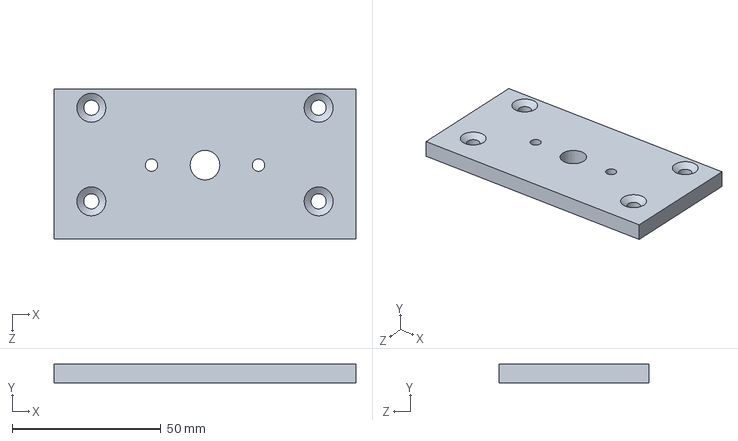
[picture p47: CAD file, 2017-03-19]
linear_motion_axis/CAD/endplate.SLDPRT
101.6 x 6.35 x 50.5 mm
