tjankovic/2-77-ppd/desk CAD/twin_column_design/leg_laser_template_transfer_holes.SLDPRT

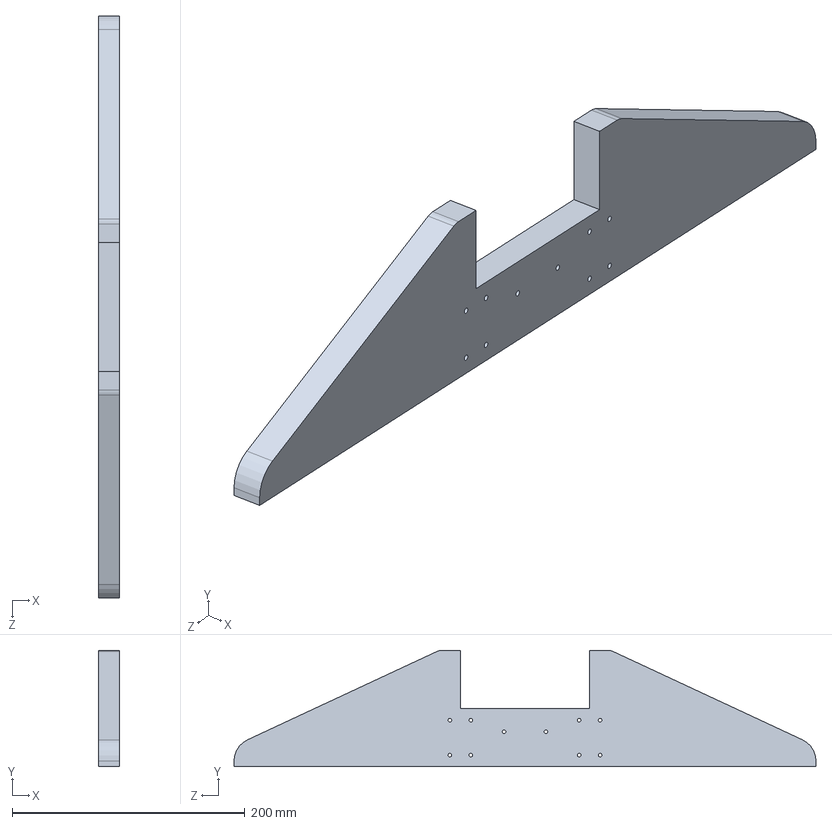
[picture p48: CAD file, 2017-04-19]
desk CAD/twin_column_design/leg_laser_template_transfer_holes.SLDPRT
18.0 x 100.0 x 500.0 mm
