tjankovic/2-77-ppd/linear_motion_axis/CAD/side_plate.SLDPRT

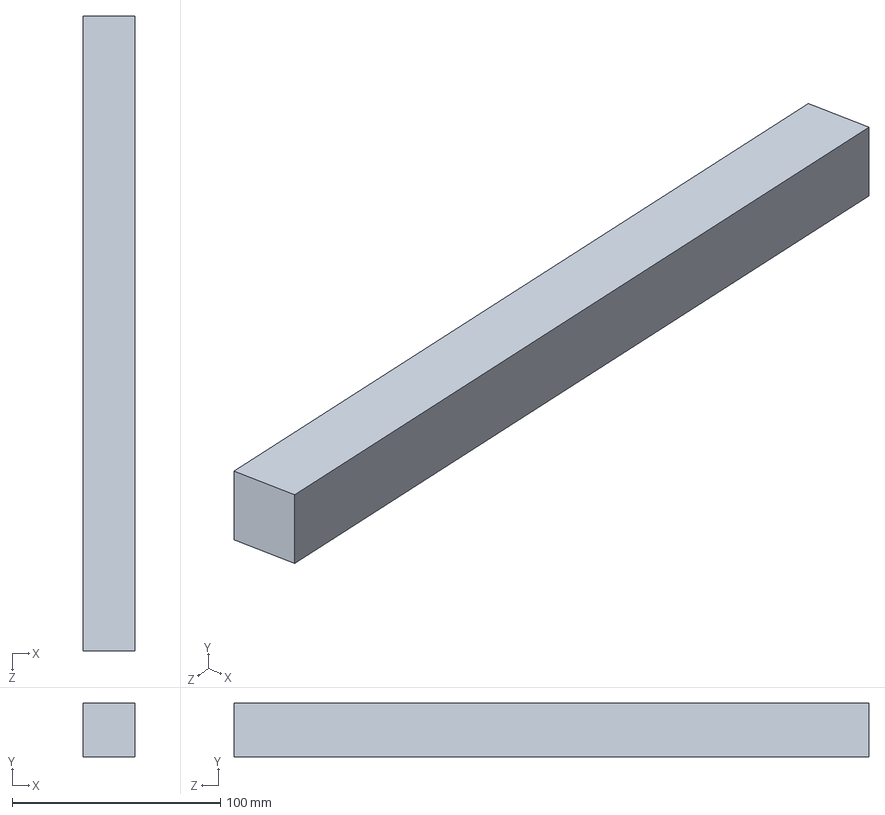
[picture p49: CAD file, 2017-03-19]
linear_motion_axis/CAD/side_plate.SLDPRT
25.1 x 25.9 x 304.8 mm
