tjankovic/2-77-ppd/desk CAD/twin_column_design/neoprene_pad.SLDPRT

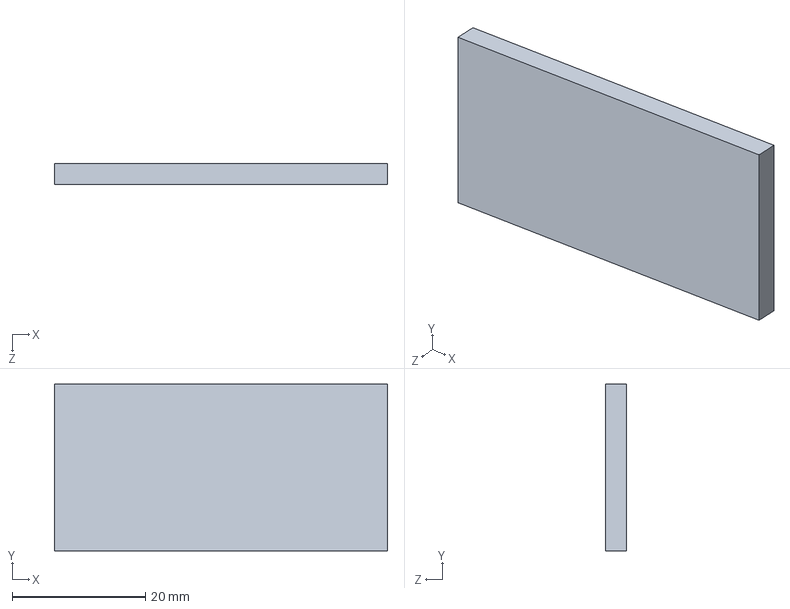
[picture p50: CAD file, 2017-04-18]
desk CAD/twin_column_design/neoprene_pad.SLDPRT
50.0 x 25.0 x 3.17 mm
