tjankovic/2-77-ppd/linear_motion_axis/CAD/baseplate.SLDPRT

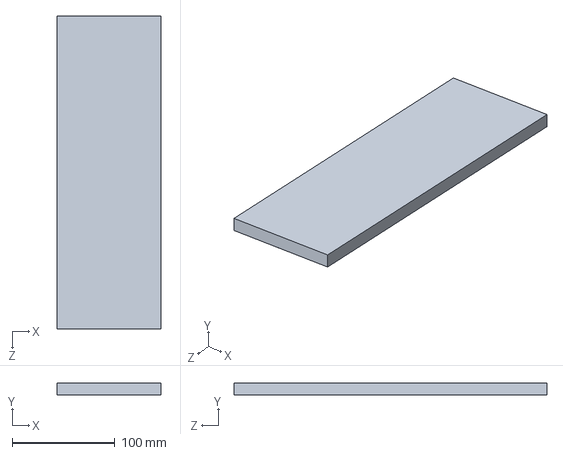
[picture p51: CAD file, 2017-03-19]
linear_motion_axis/CAD/baseplate.SLDPRT
101.6 x 11.9 x 304.8 mm
