tjankovic/2-77-ppd/desk CAD/twin_column_design/tribo_tape_pad.SLDPRT

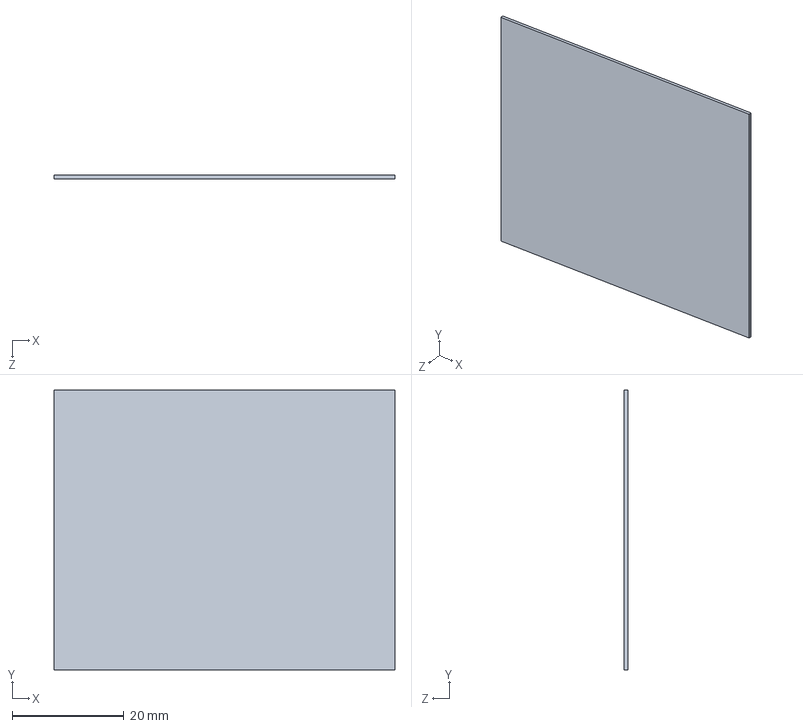
[picture p52: CAD file, 2017-04-18]
desk CAD/twin_column_design/tribo_tape_pad.SLDPRT
61.0 x 50.0 x 0.65 mm
