tjankovic/2-77-ppd/desk CAD/twin_column_design/bearing_bracket.SLDPRT

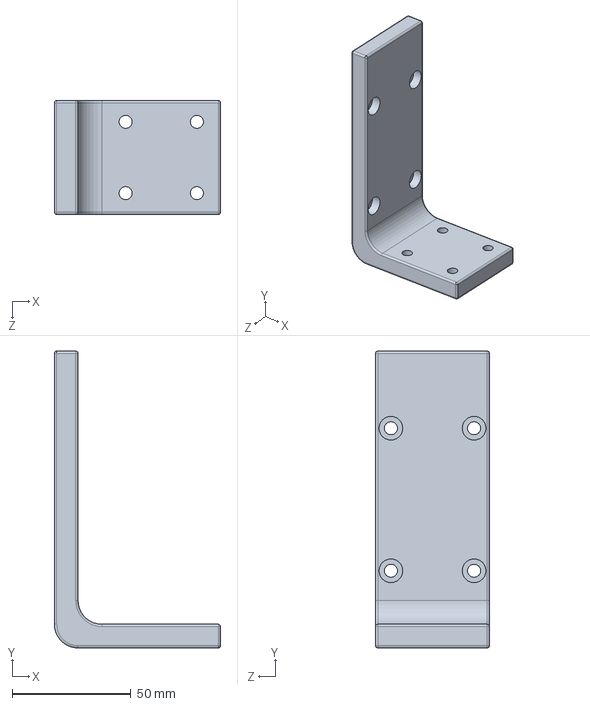
[picture p53: CAD file, 2017-04-10]
desk CAD/twin_column_design/bearing_bracket.SLDPRT
70.0 x 125.0 x 48.0 mm
