tjankovic/2-77-ppd/(list of files, cad)

Other CAD files:
kinematic_coupling/CAD/R1/Base Plate R2.SLDPRT
desk CAD/twin_column_design/STLs/sandwich_bracket_13apr.STL
kinematic_coupling/CAD/R2/topplate.SLDPRT
kinematic_coupling/CAD/R2/baseplate.SLDPRT
linear_motion_axis/CAD/motor endplate.SLDPRT
desk CAD/ots_components/igus_lead_screw_cylindrical_nut_WSRM-2215TR10x2.sldasm
desk CAD/ots_components/igus_lead_screw_cylindrical_nut_WSRM-2215TR10x2.sldprt
desk CAD/ots_components/igus_lead_screw_cylindrical_nut_WSRM-2215TR10x2_1.sldprt
desk CAD/ots_components/igus_leadscrew_fixed_bearing_blockSLS-10x2-FL.sldprt
desk CAD/ots_components/igus_leadscrew_flange_nut_JFRM-2525TR10x2.sldprt
desk CAD/ots_components/igus_leadscrew_floating_bearing_block_SLS-10x2-LL.sldprt
desk CAD/ots_components/igus_leadscrew_metric_trapezoidal_PTGSG-10x2-01-R-550-ES.sldprt
desk CAD/twin_column_design/STLs/bearing_bracket.STL
desk CAD/twin_column_design/laser cut templates/slide_nut_flange.DXF
desk CAD/twin_column_design/leadscrew_block_standoff.SLDPRT
desk CAD/twin_column_design/part drawings/boxway.SLDDRW
desk CAD/twin_column_design/part drawings/cross_tie.SLDDRW
desk CAD/twin_column_design/part drawings/desktop.SLDDRW
desk CAD/twin_column_design/part drawings/leadscrew_block_standoff.SLDDRW
desk CAD/twin_column_design/part drawings/leg.SLDDRW
desk CAD/twin_column_design/part drawings/motor_flange.SLDDRW
desk CAD/twin_column_design/part drawings/sandwich_bracket.SLDDRW
desk CAD/twin_column_design/part drawings/slider.SLDDRW
desk CAD/twin_column_design/slide_nut_flange.SLDPRT
kinematic_coupling/CAD/R1/Base Plate R1.SLDDRW
kinematic_coupling/CAD/R1/Top Plate R1.SLDDRW
linear_motion_axis/CAD/drawings/baseplate.SLDDRW
linear_motion_axis/CAD/drawings/keeper_plate.SLDDRW
linear_motion_axis/CAD/drawings/rail.SLDDRW
linear_motion_axis/CAD/drawings/side_plate.SLDDRW
linear_motion_axis/CAD/drawings/slider.SLDDRW
linear_motion_axis/CAD/drawings/slider_assem.SLDDRW
linear_motion_axis/CAD/drawings/slider_with_leadnuts.SLDDRW
