tjankovic/2-77-ppd/design_spreadsheets/Tests/Stiffness Measurements.xlsx

Sheet: bottom of travel
weight in lb | weight in kg | weight in N | deflection in 0.001" | deflection in mm | stiffness (N/mm) | Summary
10 | 4.563 | 44.7174 | 41 | 1.0414 | 42.93969656 | Mean measured stiffness (N/mm) | 50.1497935
20 | 9.126 | 89.4348 | 72 | 1.8288 | 48.90354331 | Stdev measured stiffness (N/mm) | 4.247763656
10 | 4.563 | 44.7174 | 31 | 0.7874 | 56.79121158 | 95% confidence interval (N/mm) | 2.775154593
10 | 4.563 | 44.7174 | 38 | 0.9652 | 46.32967261 | Upper bound (N/mm) | 52.9249481
20 | 9.126 | 89.4348 | 72 | 1.8288 | 48.90354331 | Lower bound (N/mm) | 47.37463891
10 | 4.563 | 44.7174 | 34 | 0.8636 | 51.78022233 | Predicted stiffness from error budget (N/mm) | 78.8
10 | 4.563 | 44.7174 | 36 | 0.9144 | 48.90354331 | Prediction relative error | 0.5712926115
20 | 9.126 | 89.4348 | 68 | 1.7272 | 51.78022233
10 | 4.563 | 44.7174 | 32 | 0.8128 | 55.01648622
 | yellow cells are differential deflections between 10lb and 20lb loadings, i.e. takes up any slop or geometric error, should be better measure of F=kx stiffness
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
