tjankovic/2-77-ppd/design_notebook/A_02.jpg

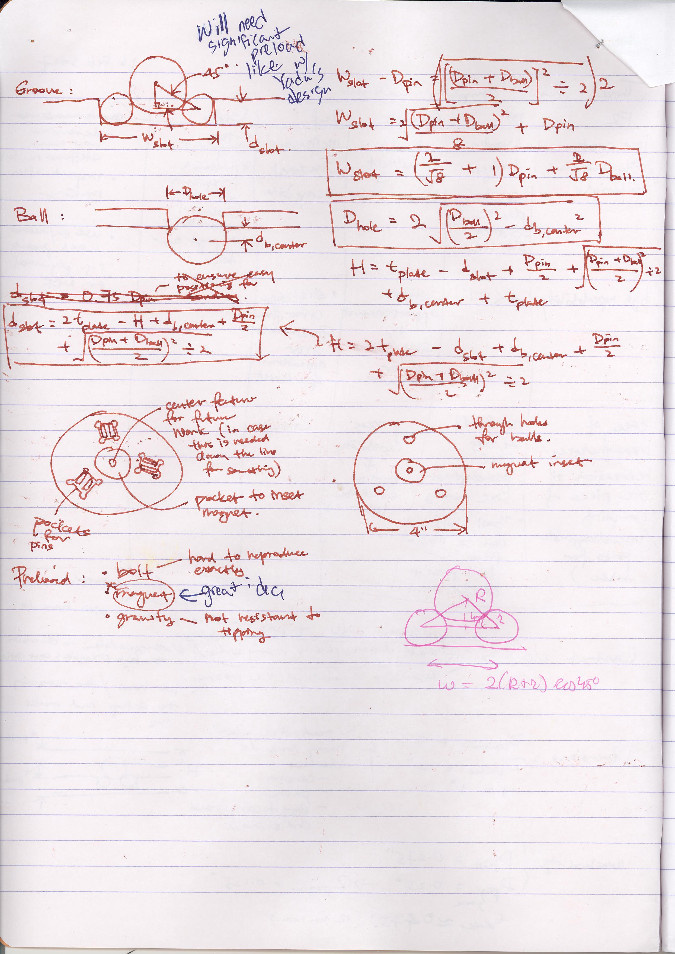
design_notebook/A_02.jpg
