tjankovic/2-77-ppd/design_notebook/A_02_a1.jpg

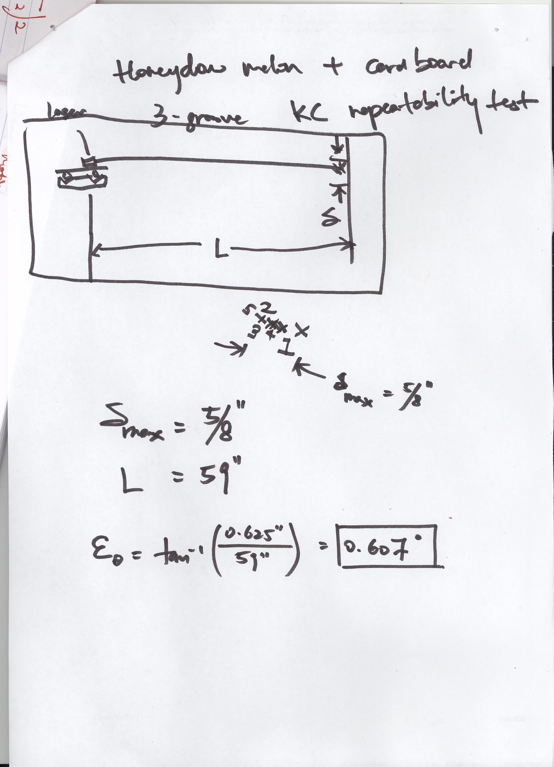
design_notebook/A_02_a1.jpg
