tjankovic/2-77-ppd/design_notebook/A_03.jpg

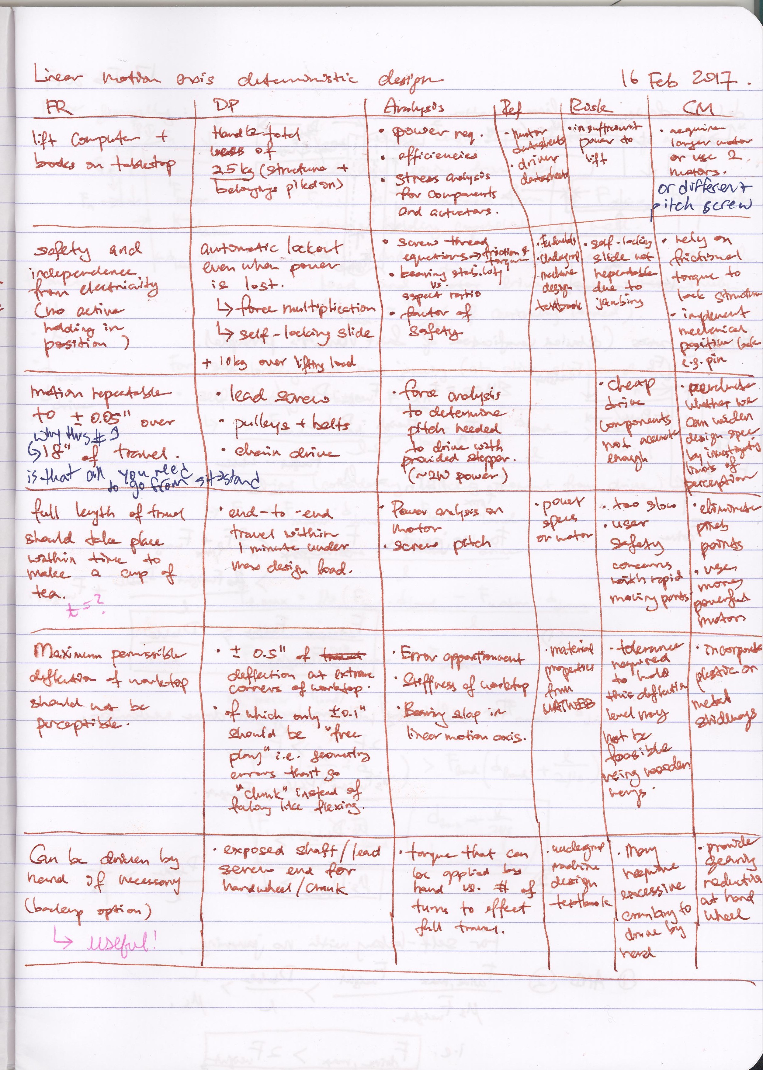
design_notebook/A_03.jpg
