tjankovic/2-77-ppd/design_notebook/A_05.jpeg

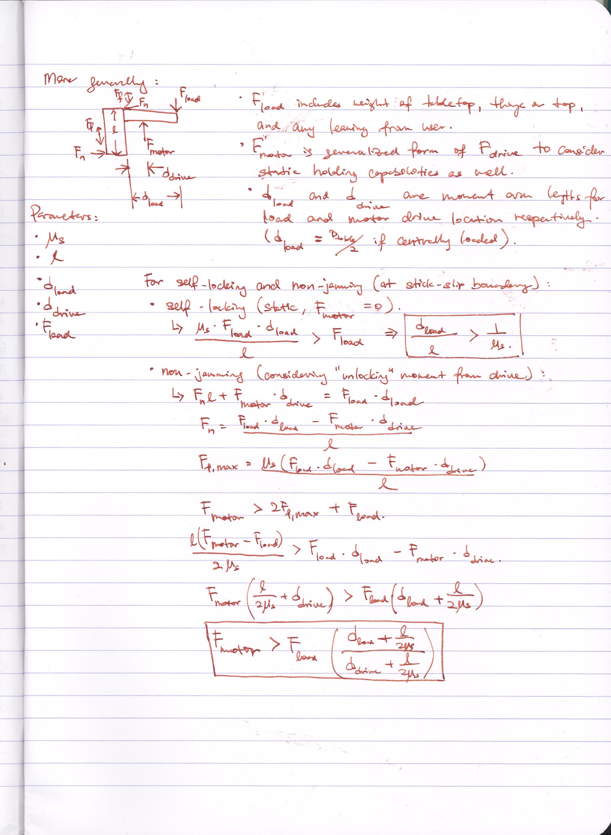
design_notebook/A_05.jpeg
