tjankovic/2-77-ppd/kinematic_coupling/CAD/R1/Base Plate R1.PDF

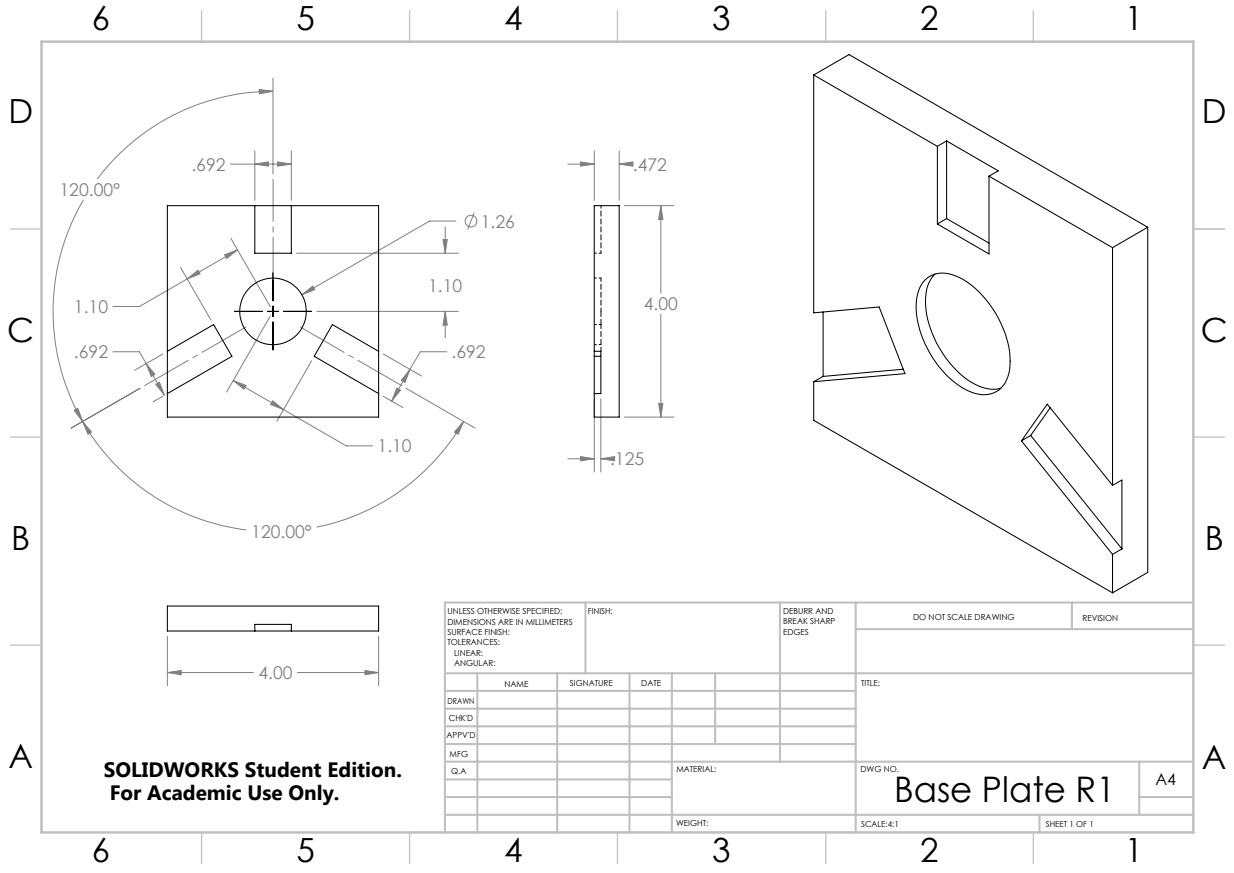
[picture p58: page 1]
FINISH:; DEBURR AND; BREAK SHARP; DO NOT SCALE DRAWING; REVISION; SCALE:4:1; SHEET 1 OF 1

UNLESS OTHERWISE SPECIFIED:
DIMENSIONS ARE IN MILLIMETERS
SURFACE FINISH:
TOLERANCES:
LINEAR:
ANGULAR:

NAME | SIGNATURE | DATE | | | | TITLE:

DRAWN
CHK'D
APPV'D
MFG

Q.A | | | | MATERIAL: | Base Plate R1 SOLIDWORKS Student Edition. DWG NO. | A4

For Academic Use Only.
