tjankovic/2-77-ppd/kinematic_coupling/CAD/R1/Top Plate R1.PDF

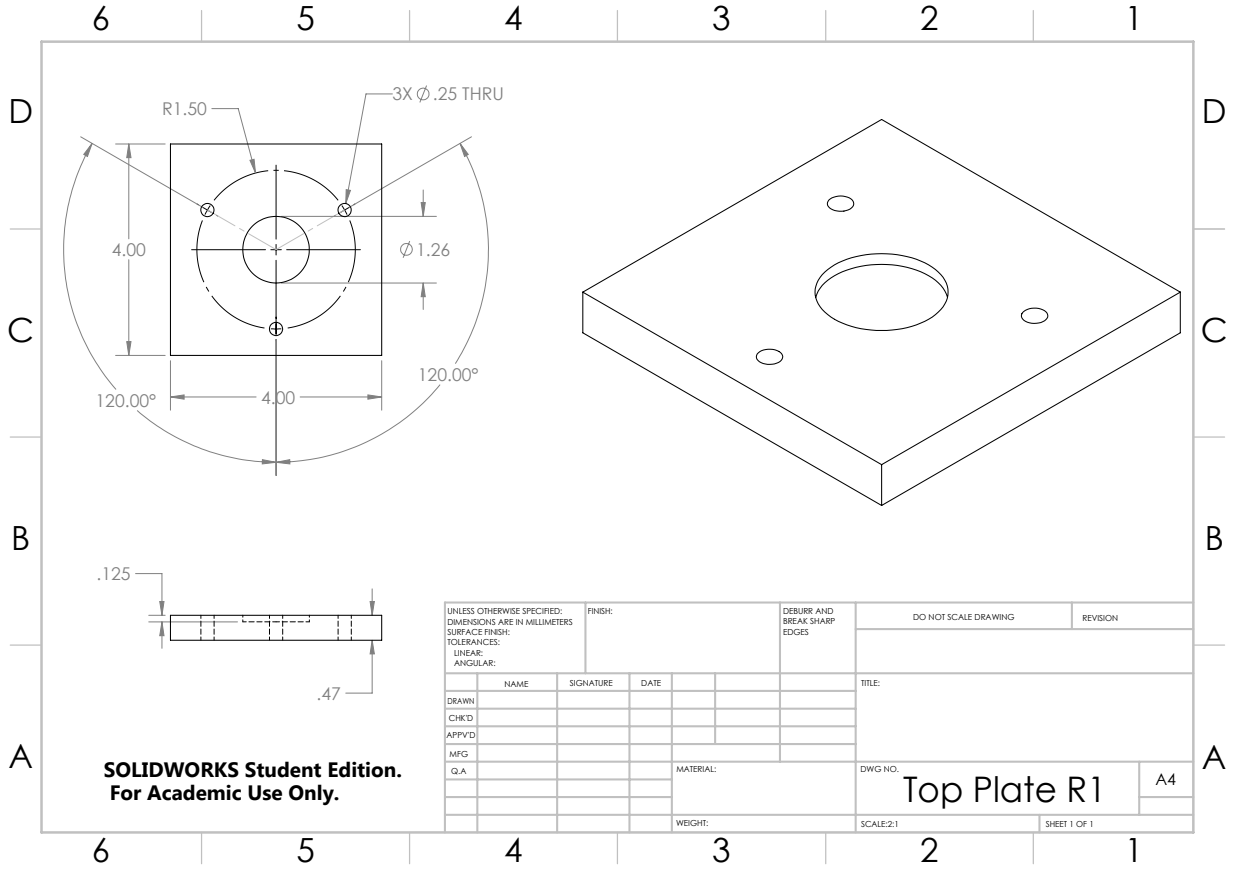
[picture p59: page 1]
3X .25 THRU; FINISH:; DEBURR AND; BREAK SHARP; DO NOT SCALE DRAWING; REVISION; SCALE:2:1; SHEET 1 OF 1

UNLESS OTHERWISE SPECIFIED:
DIMENSIONS ARE IN MILLIMETERS
SURFACE FINISH:
TOLERANCES:
LINEAR:
ANGULAR:

NAME | SIGNATURE | DATE | | | | TITLE:

DRAWN
CHK'D
APPV'D
MFG

Q.A | | | | MATERIAL: | Top Plate R1 SOLIDWORKS Student Edition. DWG NO. | A4

For Academic Use Only.
