tjankovic/2-77-ppd/desk CAD/twin_column_design/part drawings/PDFs/combined.pdf

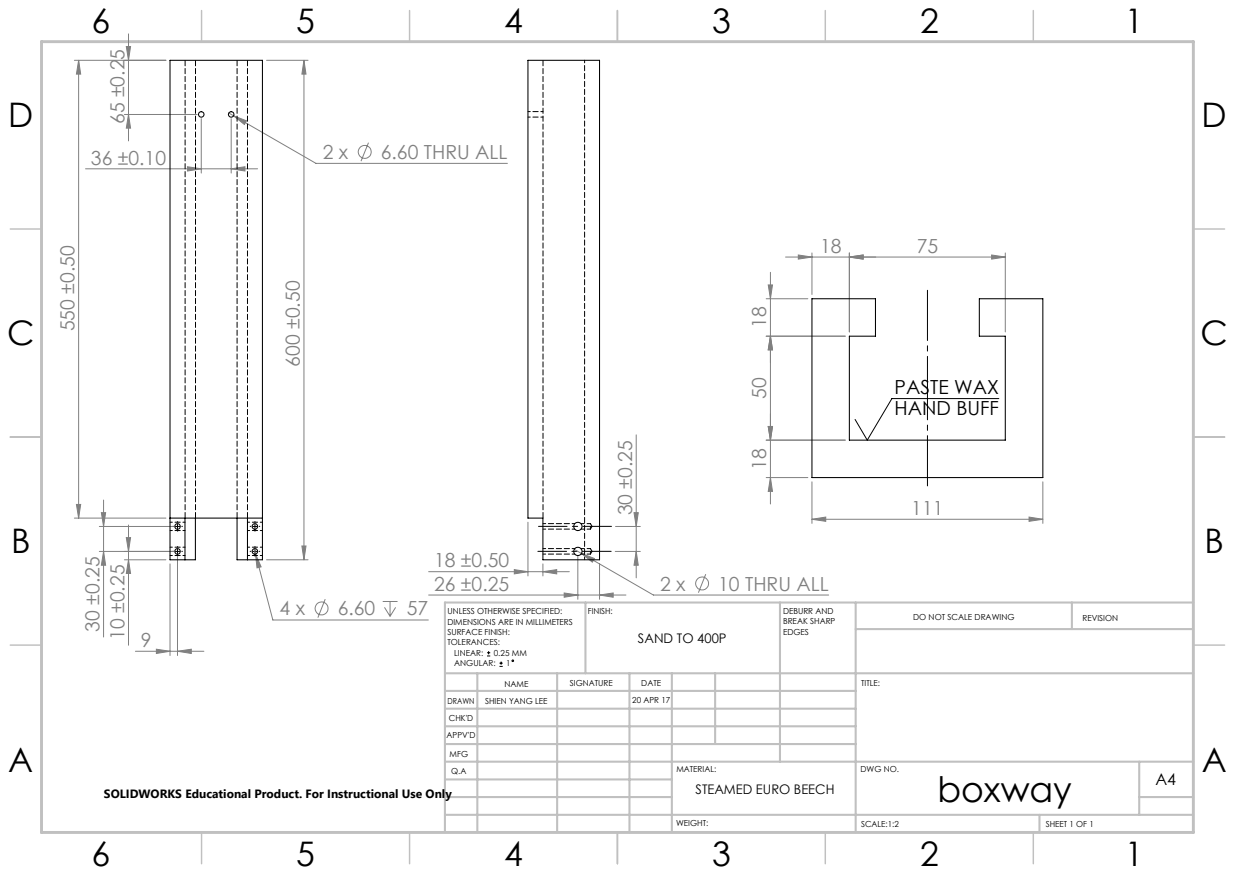
[picture p60: page 1]
HAND BUFF; PASTE WAX; 6.60 THRU ALL; 10 THRU ALL; FINISH:; DEBURR AND; BREAK SHARP; DO NOT SCALE DRAWING; REVISION; SCALE:1:2; SHEET 1 OF 1; SAND TO 400P

UNLESS OTHERWISE SPECIFIED:
DIMENSIONS ARE IN MILLIMETERS
SURFACE FINISH:
TOLERANCES:
LINEAR: 0.25 MM
ANGULAR: 1

NAME | SIGNATURE | DATE | | | | TITLE:

DRAWN | SHIEN YANG LEE | | 20 APR 17
CHK'D
APPV'D
MFG
Q.A | | | | MATERIAL: STEAMED EURO BEECH | DWG NO. boxway | A4

SOLIDWORKS Educational Product. For Instructional Use Only

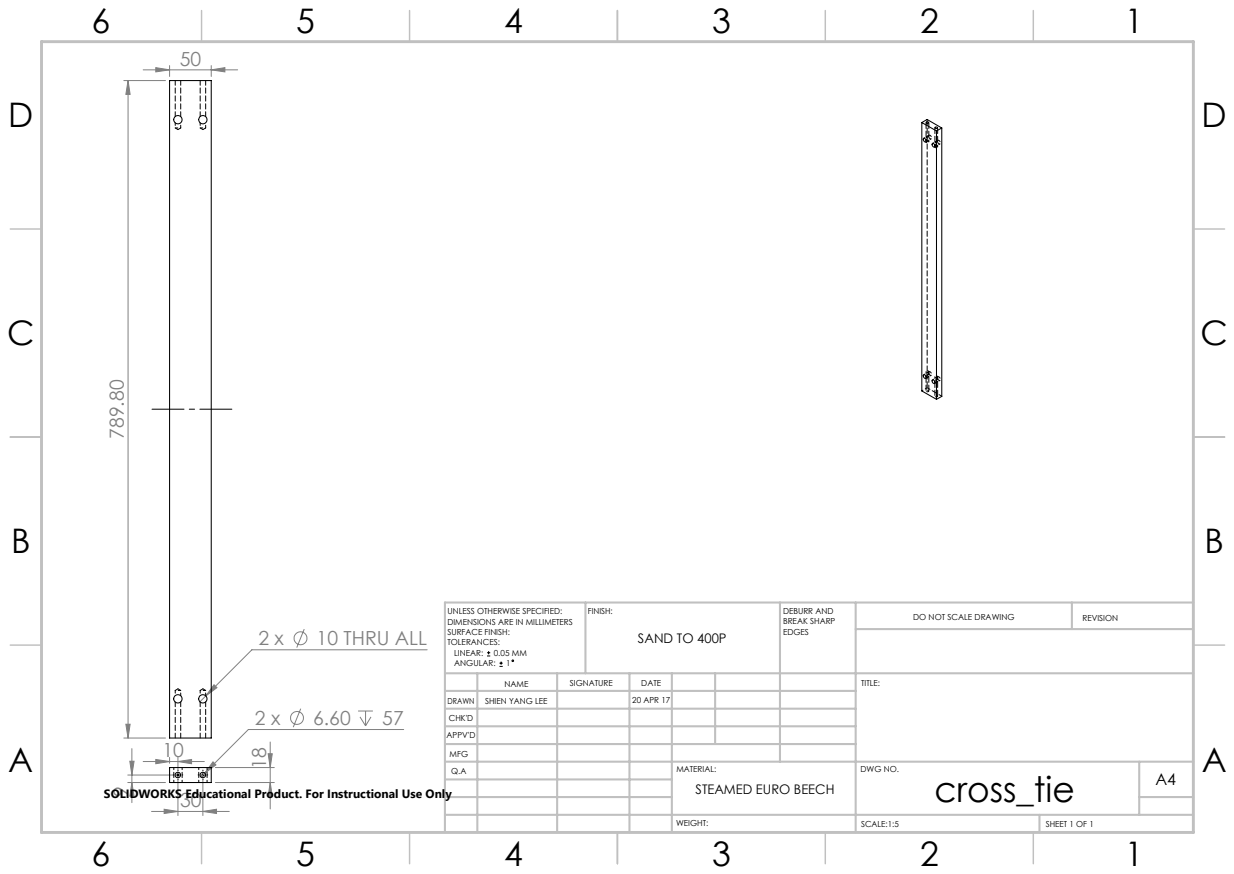
[picture p61: page 2]
10 THRU ALL; FINISH:; DEBURR AND; BREAK SHARP; DO NOT SCALE DRAWING; REVISION; SCALE:1:5; SHEET 1 OF 1; SAND TO 400P

UNLESS OTHERWISE SPECIFIED:
DIMENSIONS ARE IN MILLIMETERS
SURFACE FINISH:
TOLERANCES:
LINEAR: 0.05 MM
ANGULAR: 1

NAME | SIGNATURE | DATE | | | | TITLE:

DRAWN | SHIEN YANG LEE | | 20 APR 17
CHK'D
APPV'D
MFG
Q.A | | | | MATERIAL: STEAMED EURO BEECH | DWG NO. cross_tie | A4

SOLIDWORKS Educational Product. For Instructional Use Only

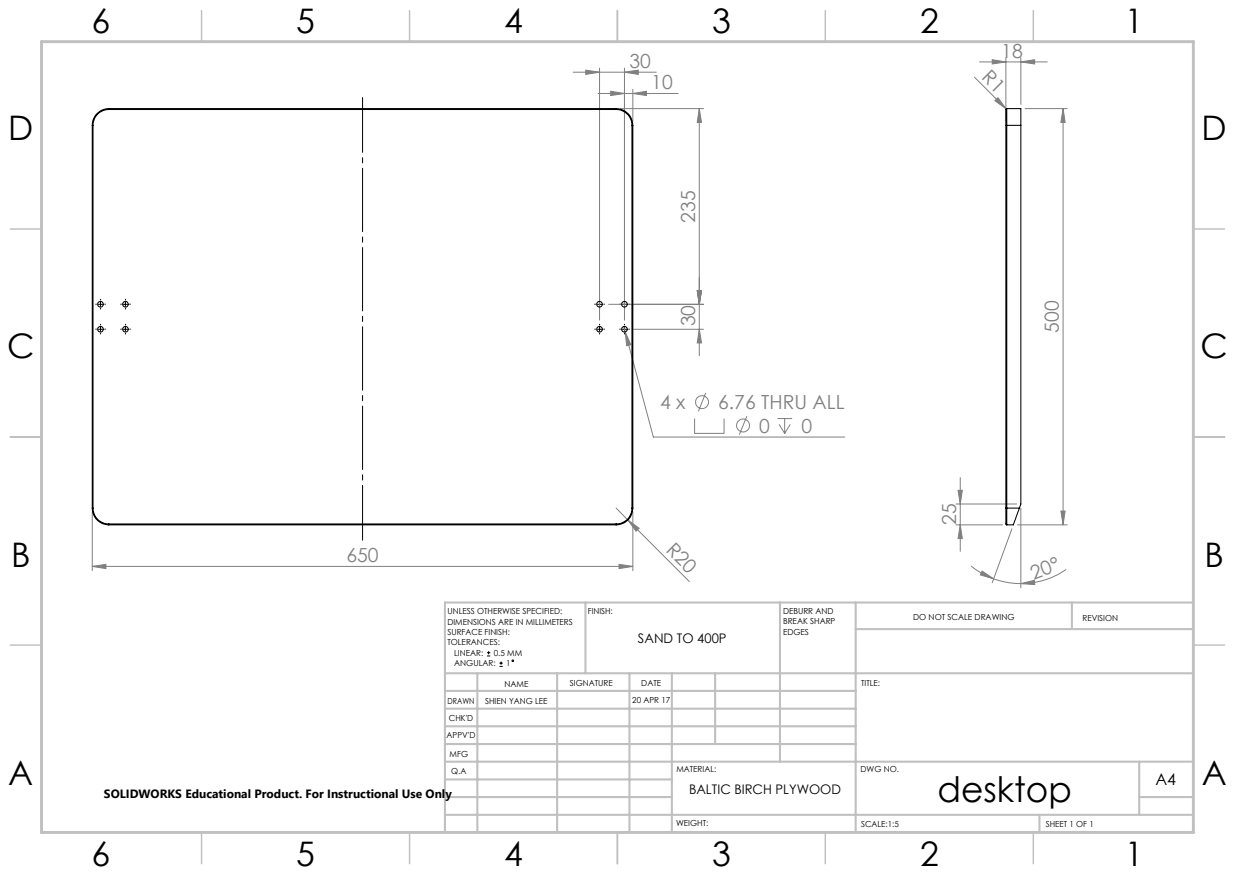
[picture p62: page 3]
6.76 THRU ALL; FINISH:; DEBURR AND; BREAK SHARP; DO NOT SCALE DRAWING; REVISION; SCALE:1:5; SHEET 1 OF 1; SAND TO 400P; SOLIDWORKS Educational Product. For Instructional Use Only; desktop

UNLESS OTHERWISE SPECIFIED:
DIMENSIONS ARE IN MILLIMETERS
SURFACE FINISH:
TOLERANCES:
LINEAR: 0.5 MM
ANGULAR: 1

NAME | SIGNATURE | DATE | | | | TITLE:

DRAWN | SHIEN YANG LEE | | 20 APR 17
CHK'D
APPV'D
MFG
Q.A | | | | MATERIAL: BALTIC BIRCH PLYWOOD | DWG NO. | A4

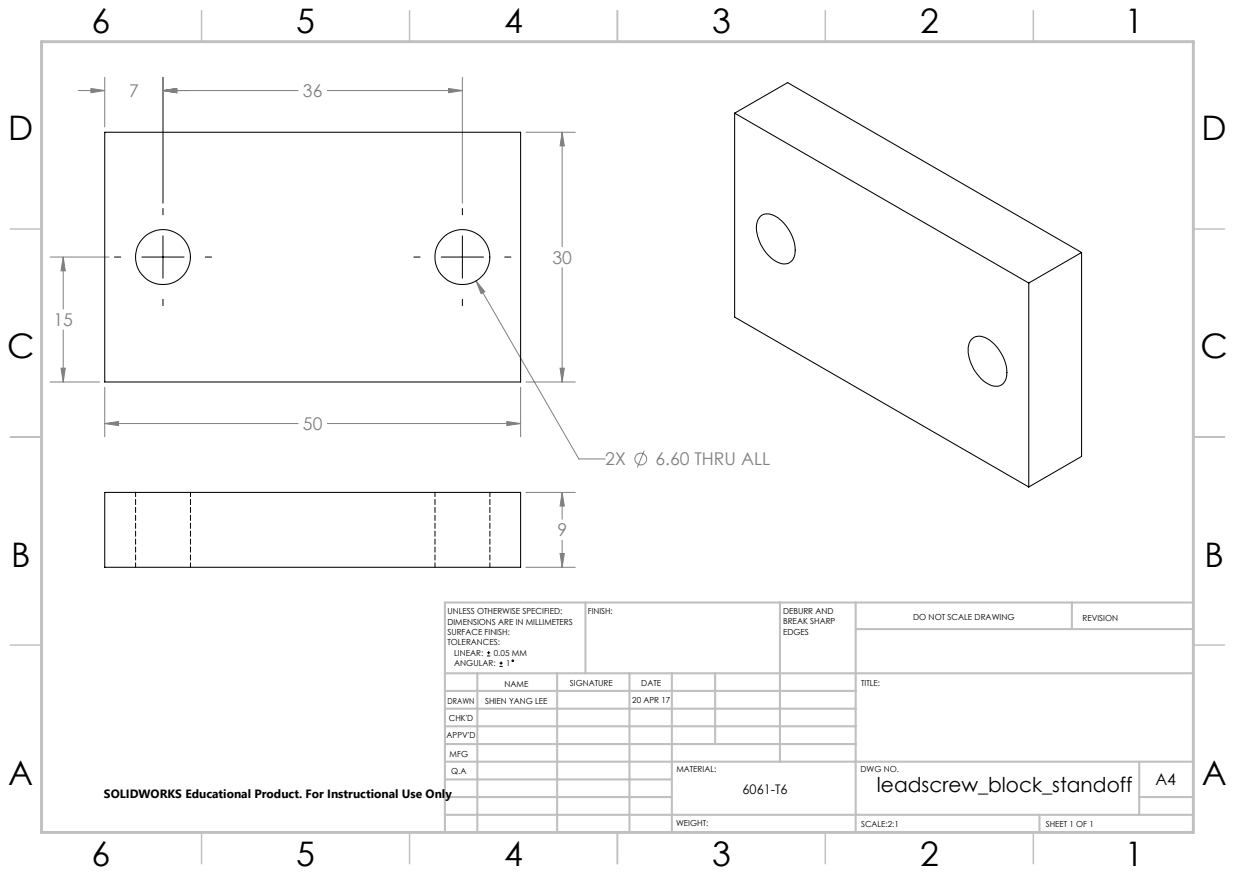
[picture p63: page 4]
6.60 THRU ALL; FINISH:; DEBURR AND; BREAK SHARP; DO NOT SCALE DRAWING; REVISION; SCALE:2:1; SHEET 1 OF 1

UNLESS OTHERWISE SPECIFIED:
DIMENSIONS ARE IN MILLIMETERS
SURFACE FINISH:
TOLERANCES:
LINEAR: 0.05 MM
ANGULAR: 1

NAME | SIGNATURE | DATE | | | | TITLE:

DRAWN | SHIEN YANG LEE | | 20 APR 17
CHK'D
APPV'D
MFG
Q.A | | | | MATERIAL: 6061-T6 | DWG NO. | A4

leadscrew_block_standoff SOLIDWORKS Educational Product. For Instructional Use Only

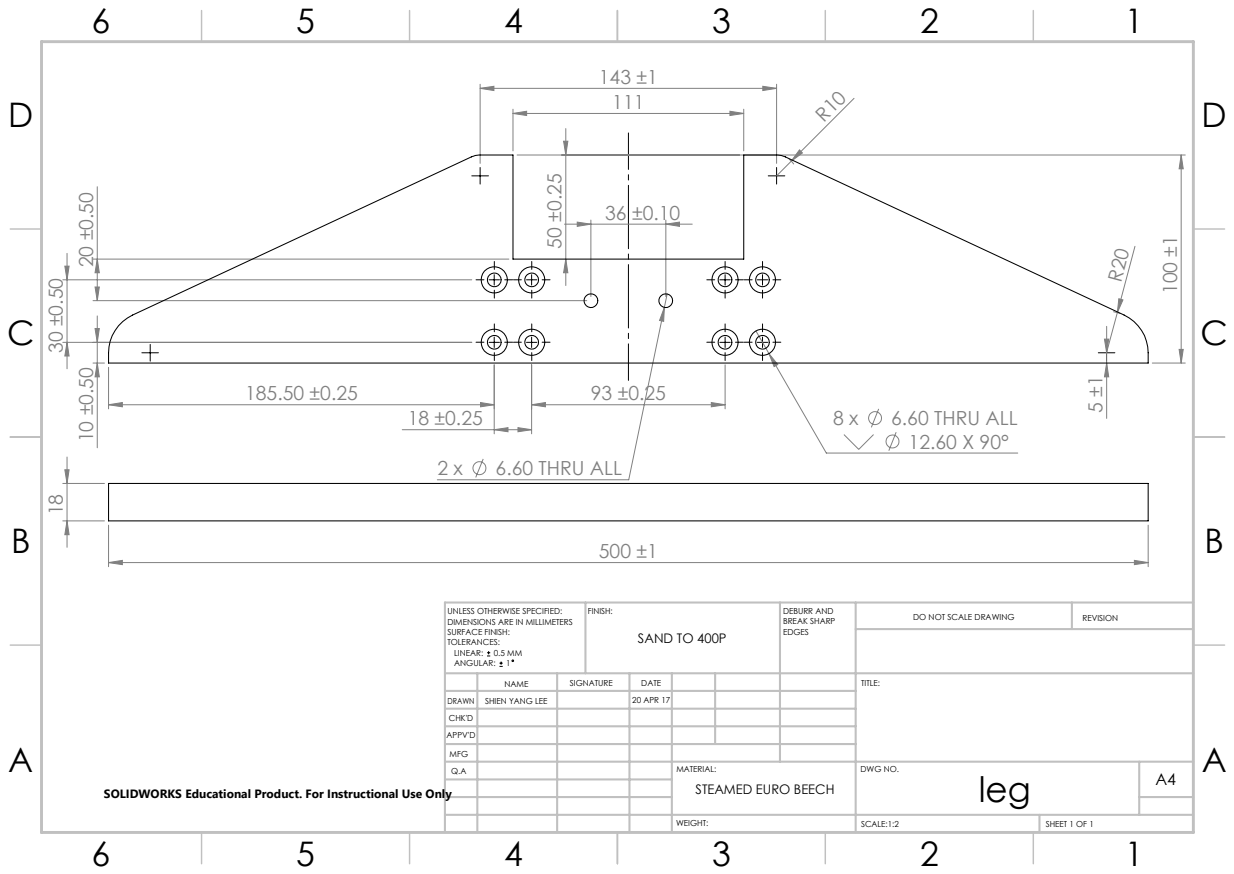
[picture p64: page 5]
6.60 THRU ALL; FINISH:; DEBURR AND; BREAK SHARP; DO NOT SCALE DRAWING; REVISION; SAND TO 400P

UNLESS OTHERWISE SPECIFIED:
DIMENSIONS ARE IN MILLIMETERS
SURFACE FINISH:
TOLERANCES:
LINEAR: 0.5 MM
ANGULAR: 1

NAME | SIGNATURE | DATE | | | | TITLE:

DRAWN | SHIEN YANG LEE | | 20 APR 17
CHK'D
APPV'D
MFG
Q.A | | | | MATERIAL: STEAMED EURO BEECH | DWG NO. leg | A4

SOLIDWORKS Educational Product. For Instructional Use Only

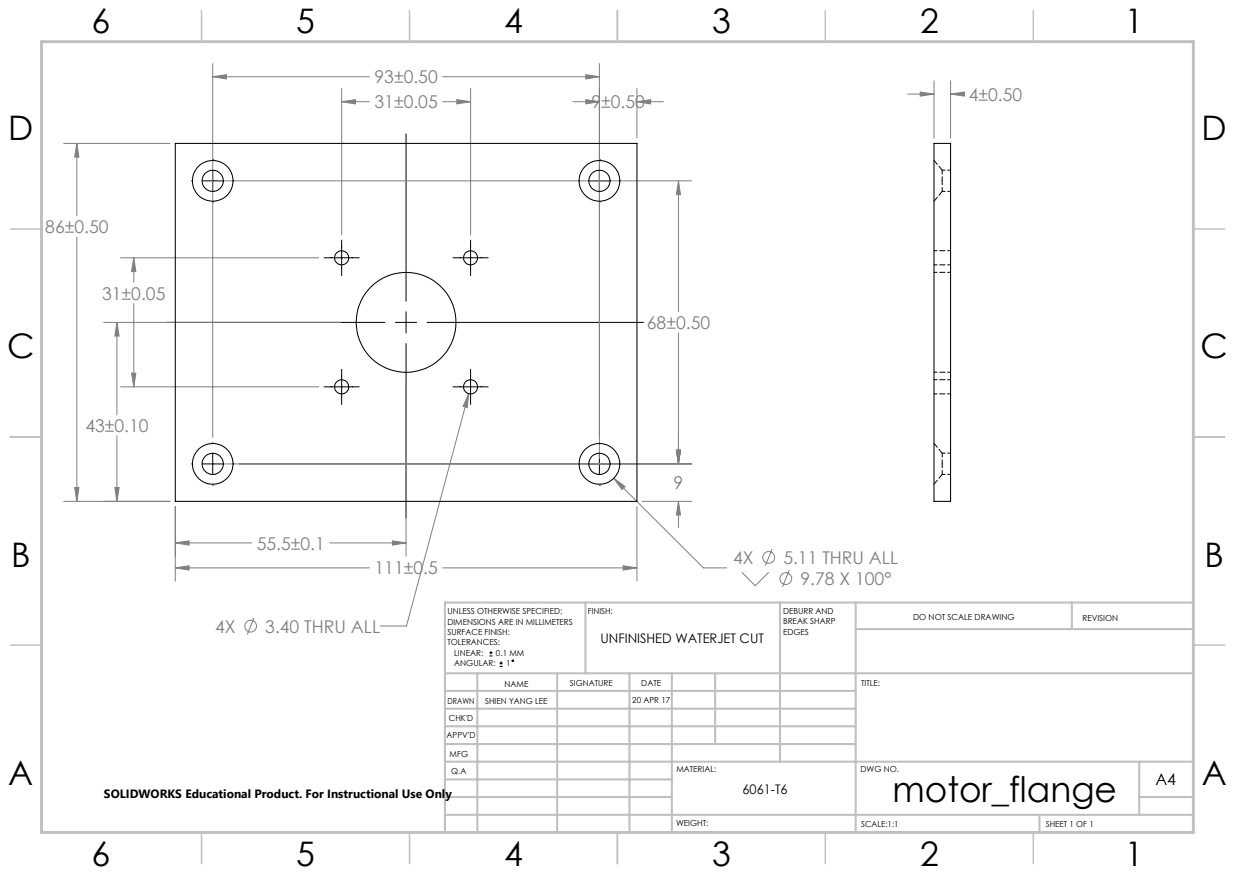
[picture p65: page 6]
5.11 THRU ALL; 3.40 THRU ALL; FINISH:; DEBURR AND; BREAK SHARP; DO NOT SCALE DRAWING; REVISION; SCALE:1:1; SHEET 1 OF 1; SOLIDWORKS Educational Product. For Instructional Use Only; motor_flange

UNLESS OTHERWISE SPECIFIED:
DIMENSIONS ARE IN MILLIMETERS
SURFACE FINISH:
TOLERANCES:
LINEAR: 0.1 MM
ANGULAR: 1

UNFINISHED WATERJET CUT

NAME | SIGNATURE | DATE | | | | TITLE:

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

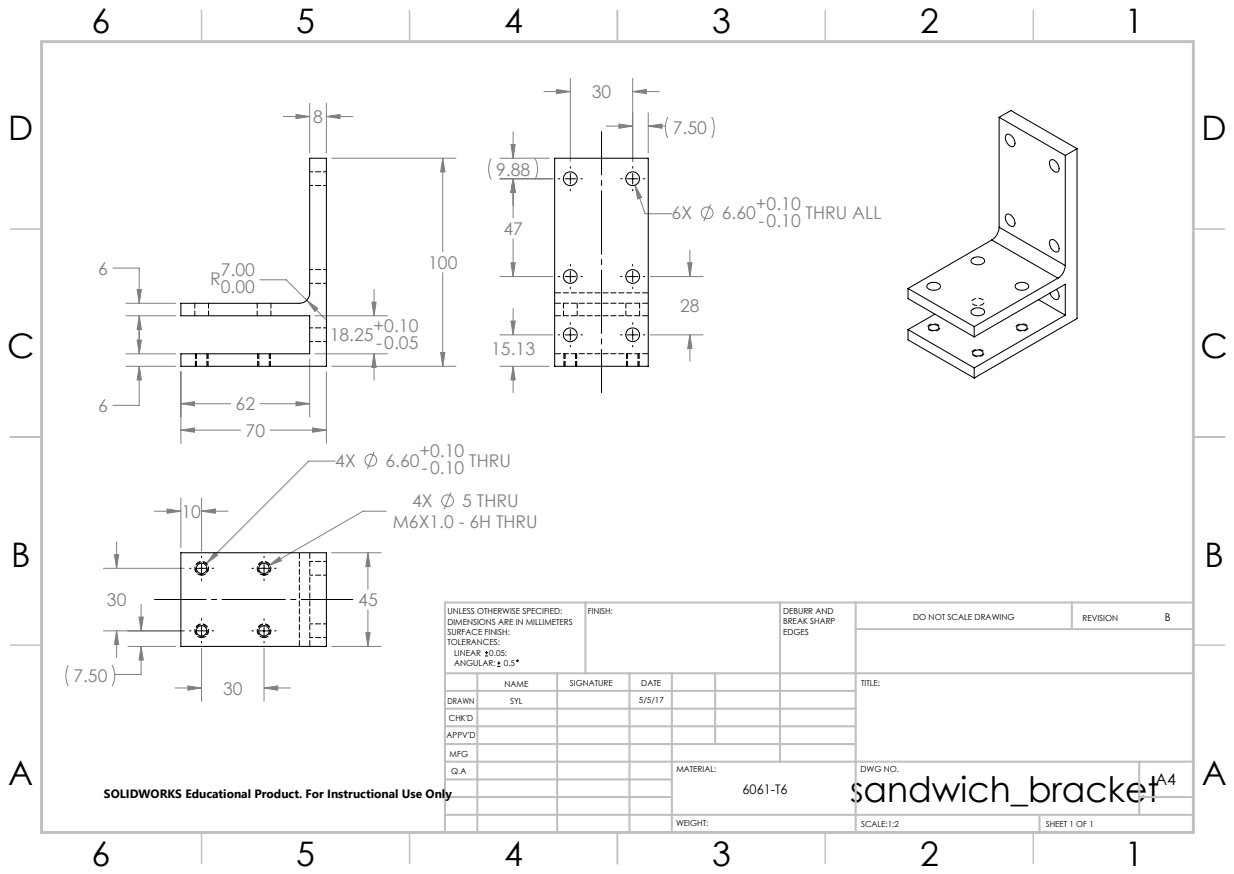
[picture p66: page 7]
0.10 THRU; 5 THRU; M6X1.0 - 6H THRU; 0.10 THRU ALL; FINISH:; DEBURR AND; BREAK SHARP; DO NOT SCALE DRAWING; REVISION

UNLESS OTHERWISE SPECIFIED:
DIMENSIONS ARE IN MILLIMETERS
SURFACE FINISH:
TOLERANCES:
LINEAR 0.05:
ANGULAR: 0.5

NAME | SIGNATURE | DATE | | | | TITLE:

DRAWN | SYL | | 5/5/17
CHK'D
APPV'D
MFG
Q.A | | | | MATERIAL: sandwich_bracket 6061-T6 | DWG NO. | A4

SOLIDWORKS Educational Product. For Instructional Use Only

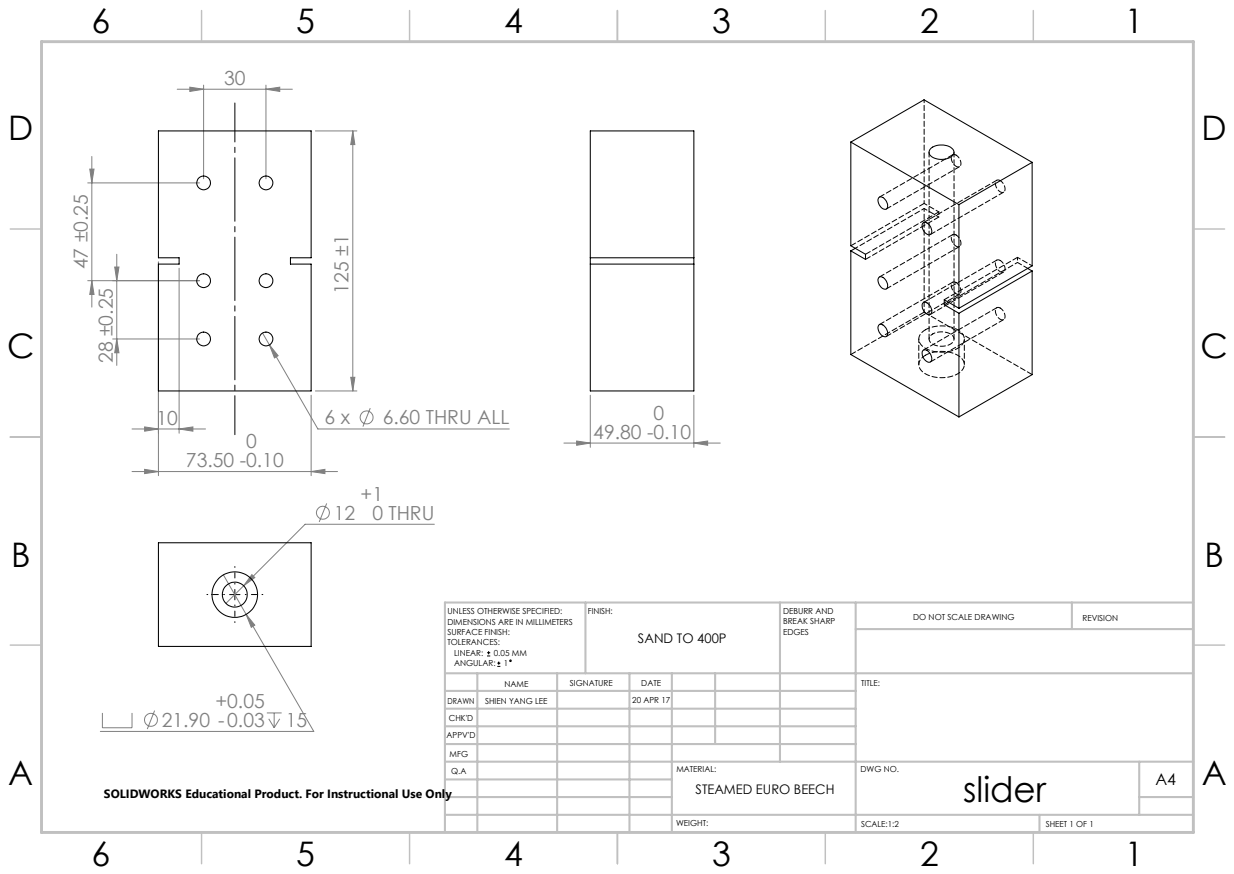
[picture p67: page 8]
6.60 THRU ALL; 0 THRU; FINISH:; DEBURR AND; BREAK SHARP; DO NOT SCALE DRAWING; REVISION; SAND TO 400P; SOLIDWORKS Educational Product. For Instructional Use Only; slider

UNLESS OTHERWISE SPECIFIED:
DIMENSIONS ARE IN MILLIMETERS
SURFACE FINISH:
TOLERANCES:
LINEAR: 0.05 MM
ANGULAR: 1

NAME | SIGNATURE | DATE | | | | TITLE:

DRAWN | SHIEN YANG LEE | | 20 APR 17
CHK'D
APPV'D
MFG
Q.A | | | | MATERIAL: STEAMED EURO BEECH | DWG NO. | A4
