tjankovic/2-77-ppd/linear_motion_axis/CAD/drawings/baseplate.PDF

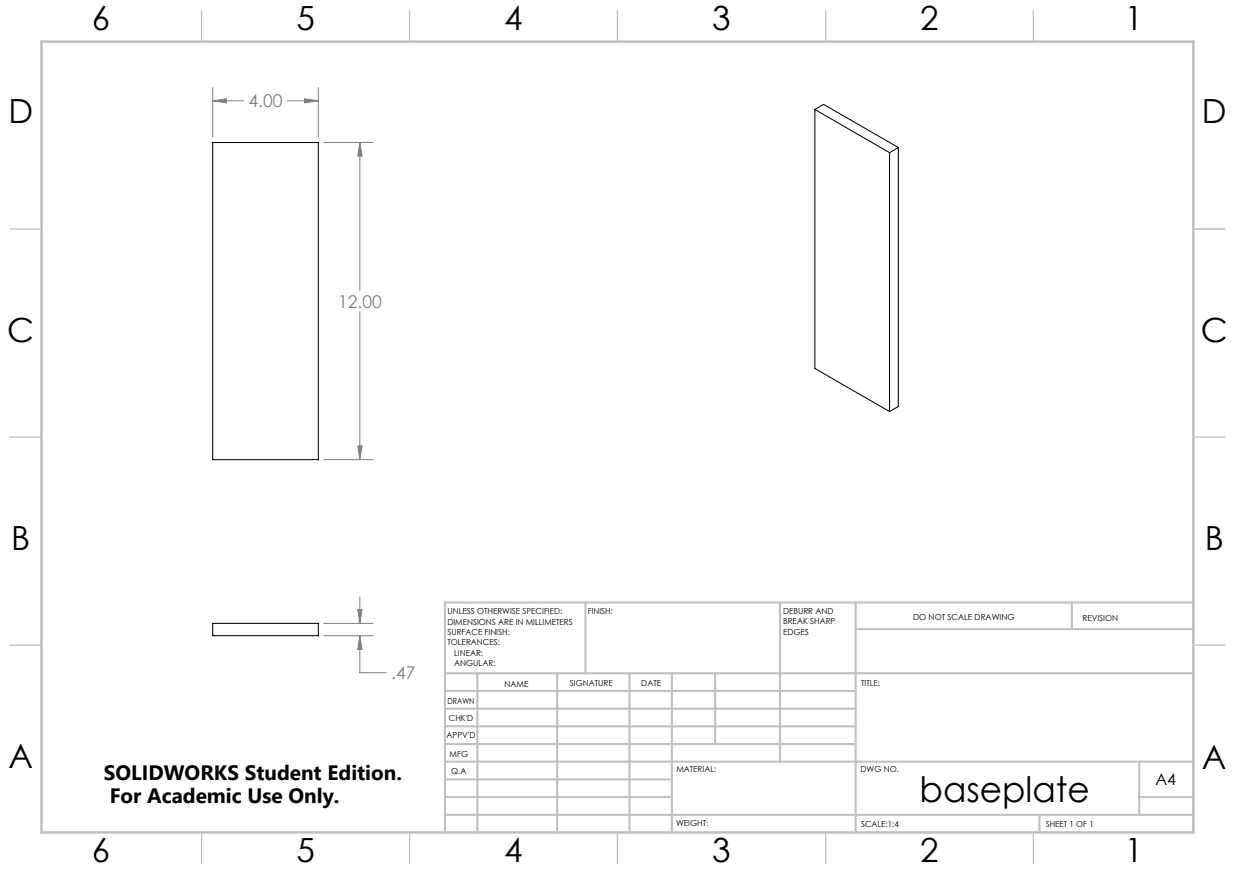
[picture p68: page 1]
FINISH:; DEBURR AND; BREAK SHARP; DO NOT SCALE DRAWING; REVISION; SCALE:1:4; SHEET 1 OF 1

UNLESS OTHERWISE SPECIFIED:
DIMENSIONS ARE IN MILLIMETERS
SURFACE FINISH:
TOLERANCES:
LINEAR:
ANGULAR:

NAME | SIGNATURE | DATE | | | | TITLE:

DRAWN
CHK'D
APPV'D
MFG

Q.A | | | | MATERIAL: | baseplate SOLIDWORKS Student Edition. DWG NO. | A4

For Academic Use Only.
