tjankovic/2-77-ppd/linear_motion_axis/CAD/drawings/keeper_plate.PDF

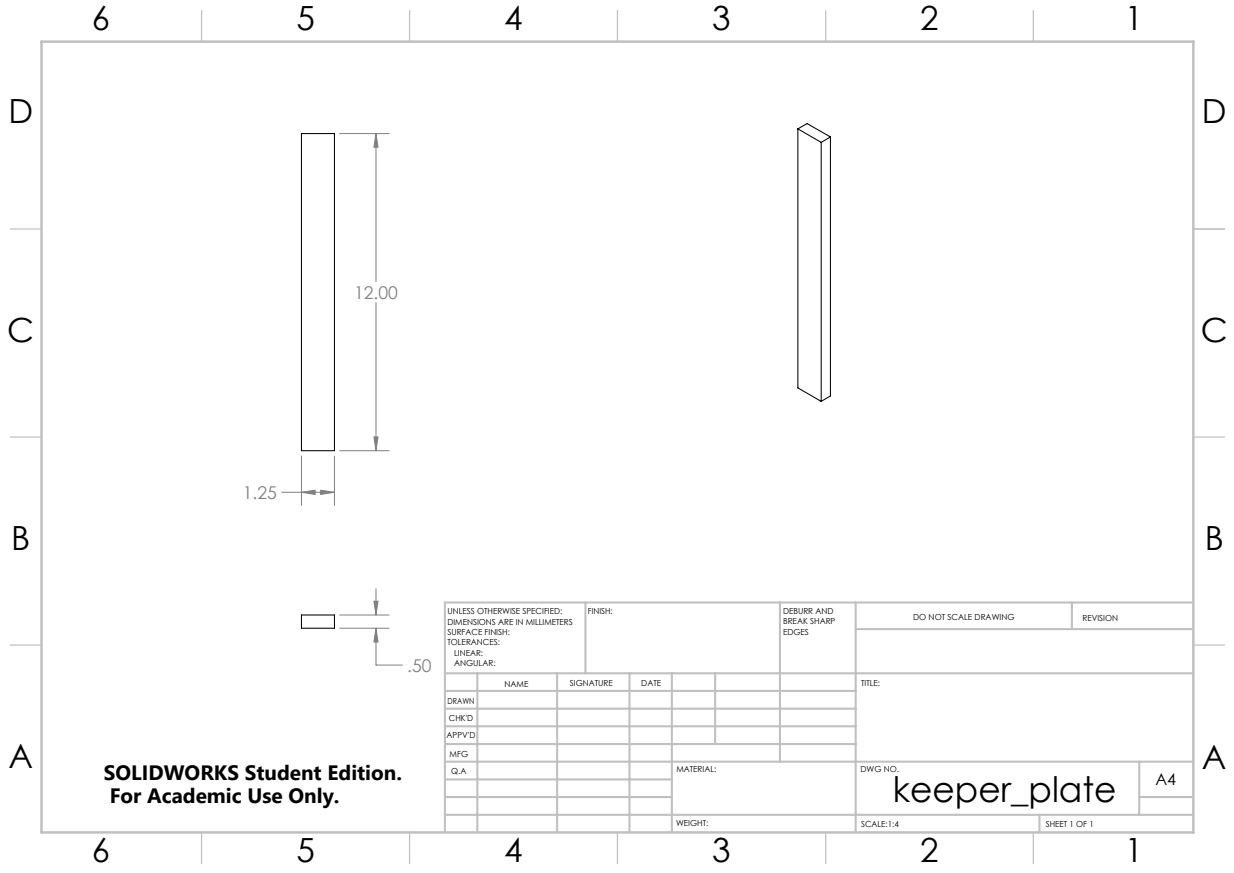
[picture p69: page 1]
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

UNLESS OTHERWISE SPECIFIED:
DIMENSIONS ARE IN MILLIMETERS
SURFACE FINISH:
TOLERANCES:
LINEAR:

NAME | SIGNATURE | DATE | | | | TITLE:

DRAWN
CHK'D
APPV'D
MFG

Q.A | | | | MATERIAL: | keeper_plate SOLIDWORKS Student Edition. DWG NO. | A4

For Academic Use Only.
