tjankovic/2-77-ppd/linear_motion_axis/CAD/drawings/slider_assem.PDF

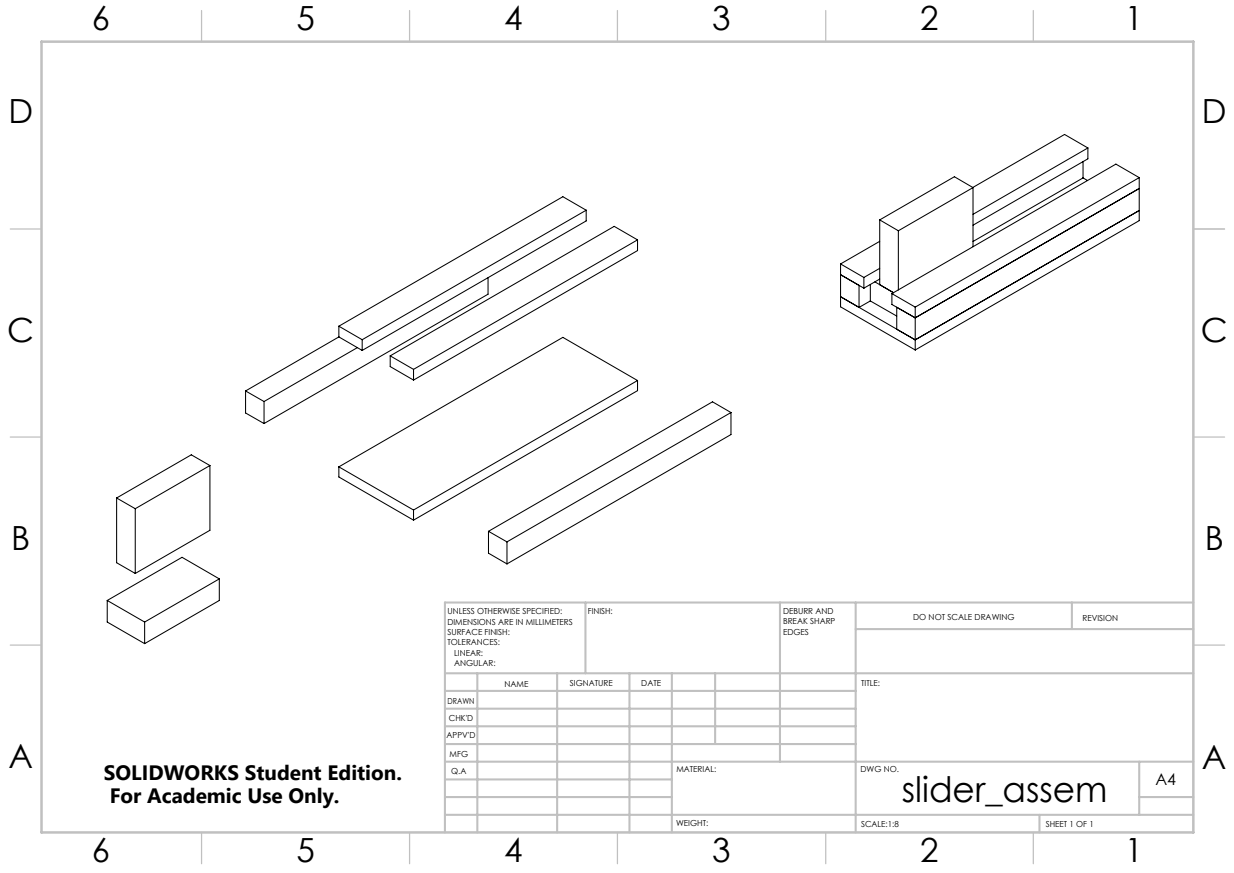
[picture p70: page 1]
FINISH:; DEBURR AND; BREAK SHARP; DO NOT SCALE DRAWING; REVISION; SCALE:1:8; SHEET 1 OF 1

UNLESS OTHERWISE SPECIFIED:
DIMENSIONS ARE IN MILLIMETERS
SURFACE FINISH:
TOLERANCES:
LINEAR:
ANGULAR:

NAME | SIGNATURE | DATE | | | | TITLE:

DRAWN
CHK'D
APPV'D
MFG

Q.A | | | | MATERIAL: | slider_assem SOLIDWORKS Student Edition. DWG NO. | A4

For Academic Use Only.
