tjankovic/2-77-ppd/(commit log)

2017-02-19 Add files for kinematic coupling design and notebook scans.
    [Assembled Baseplate R1.SLDASM, Assembled Coupling R1.SLDASM, Assembled Topplate R1.SLDASM, Ball R1.SLDPRT, Base Plate R1.SLDDRW, Base Plate R1.SLDPRT, Base Plate R2.SLDPRT, Dowel Pins R1.SLDPRT]
2017-02-19 Add linear motion axis design folder and error apportionment sheet.
    [linear motion axis error apportionment.xlsx]
2017-03-19 Add bearing preload design spreadsheet, error budget spreadsheets, and linear motion axis CAD files.
    [Bearing Preload Toy Design.ods, Error_Budget_Spreadsheet_one_axis_example.xlsx, Error_Budget_Spreadsheet_two_axis_example.xlsx, baseplate.SLDDRW, baseplate.SLDPRT, endplate.SLDPRT, endplate_delinked.SLDPRT, endplate_standoff.SLDPRT]
2017-03-27 Add error budget for twin column design and reorganize design spreadsheets.
    [Bearing Preload Toy Design.ods, Error_Budget_Spreadsheet_one_axis_example.xlsx, Error_Budget_Spreadsheet_two_axis_example.xlsx, error_budget_spreadsheet_single_rear_column.xlsx, error_budget_spreadsheet_twin_column..xlsx, first_order_analysis_single_column_rear_mounted.xls]
2017-03-27 Add CAD model of twin-column design.
    [bearing_bracket.SLDPRT, bearing_bracket.STL, boxway.SLDPRT, column_backplate.SLDPRT, cross_tie.SLDPRT, desktop.SLDPRT, igus_elastic_coupling_COU-AR-K-050-100-32-32-B-AAAA.sldprt, igus_lead_screw_cylindrical_nut_WSRM-2215TR10x2.sldasm]
2017-03-27 Add part purchase budget for final desk.
    [Budget.xlsx]
2017-03-27 Organize CAD folder and delete leftover files from bearing bracket FEA.
    [boxway.SLDPRT, cross_tie.SLDPRT, desktop.SLDPRT, leg.SLDPRT, linear_motion_axis.SLDASM, master_assem.SLDASM, slider.SLDPRT, slider_assembly.SLDASM]
2017-03-27 Continue organizing CAD folder.
    [column_backplate.SLDPRT, desktop.SLDPRT, igus_elastic_coupling_COU-AR-K-050-100-32-32-B-AAAA.sldprt, igus_lead_screw_cylindrical_nut_WSRM-2215TR10x2.sldasm, igus_lead_screw_cylindrical_nut_WSRM-2215TR10x2.sldprt, igus_lead_screw_cylindrical_nut_WSRM-2215TR10x2_1.sldprt, igus_leadscrew_fixed_bearing_blockSLS-10x2-FL.sldprt, igus_leadscrew_flange_nut_JFRM-2525TR10x2.sldprt]
2017-03-30 Revise budget for 0.75 in boards and add cut list.
    [Budget.xlsx, wood material list.xlsx]
2017-03-30 Fix broken file links in CAD assembly caused by reorganizing folder.
    [boxway.SLDPRT, cross_tie.SLDPRT, desktop.SLDPRT, error_budget_spreadsheet_twin_column..xlsx, igus_lead_screw_cylindrical_nut_WSRM-2215TR10x2.sldasm, leg.SLDPRT, linear_motion_axis.SLDASM, master_assem.SLDASM]
2017-03-30 Update CAD to match final ordered stock dimension and add part drawings.
    [boxway.SLDDRW, boxway.SLDPRT, cross_tie.SLDDRW, cross_tie.SLDPRT, desktop.SLDDRW, desktop.SLDPRT, error_budget_spreadsheet_twin_column..xlsx, leg.SLDDRW]
2017-04-04 move old design spreadsheets to archive folder.
    [first_order_analysis_self_locking_belt_drive.xls, first_order_analysis_single_column_rear_mounted.xls]
2017-04-04 Correct filename error due to mistake while saving new version.
    [error_budget_spreadsheet_twin_column..xlsx]
2017-04-04 Add detailed engineering analysis spreadsheet for structures, joints, bearings.
    [Detailed Engineering.xlsx]
2017-04-05 Add bolted joint analysis.
    [Detailed Engineering.xlsx]
2017-04-05 Change bearing slider-bracket bolt hole pattern to avoid thin walls.
2017-04-05 Add CAD for new slider bracket.
    [steel.SLDPRT]
2017-04-05 Fix mistake with moment of inertia for feet members -- don't need double-thickness feet after all.
    [Detailed Engineering.xlsx]
2017-04-08 Start tracking error apportionment sheet for linear motion axis demonstrator
    [linear motion axis error apportionment.xlsx]
2017-04-10 Update view orientation of steel bracket CAD during peer review.
    [steel.SLDPRT]
2017-04-10 Change bracket to sandwich version with glass fiber reinforcement.
    [error_budget_spreadsheet_twin_column.xlsx]
2017-04-10 Change bracket from Home Depot steel angle to glass fiber reinforced sandwich design
    [Detailed Engineering.xlsx]
2017-04-10 Update bearing block bolt hole pattern dimensions for composite bracket.
2017-04-10 Add CAD model for composite bracket.
    [sandwich_bracket.SLDPRT]
2017-04-10 Reorganize CAD and simulation files for tubular steel bracket concept into own folder.
    [steel.SLDPRT]
2017-04-10 Add STL for test print of sandwich bracket.
    [sandwich_bracket_9apr.STL]
2017-04-10 Shorten length of cantilever leg to be consistent with first generation bracket.
    [sandwich_bracket.SLDPRT]
2017-04-10 Change bolt clearances to 1/4-20 to be consistent with sandwich bracket.
    [desktop.SLDPRT]
2017-04-10 Add CAD model for bearing block standoff plate.
    [leadscrew_block_standoff.SLDPRT]
2017-04-10 Fix assembly errors for master assembly.
    [Detailed Engineering.xlsx, bearing_bracket.SLDPRT, boxway.SLDPRT, cross_tie.SLDPRT, desktop.SLDPRT, igus_lead_screw_cylindrical_nut_WSRM-2215TR10x2.sldasm, leg.SLDPRT, linear_motion_axis.SLDASM]
2017-04-18 Add analysis spreadsheet for slider preload.
    [Compliant Slider Preload.xlsx]
2017-04-18 Update composite bracket dimensions for additional screwhead clearance and incorporate preloaded slider into master assembly.
    [leg.DXF, leg.SLDPRT, master_assem.SLDASM, motor_flange.SLDPRT, neoprene_pad.SLDPRT, sandwich_bracket.SLDPRT, sandwich_bracket_11apr.STL, sandwich_bracket_13apr.STL]
2017-04-19 Update detailed engineering to consider bolt preload pullthrough at column-to-feet joint and fixed bearing block-to-boxway joint.
    [Detailed Engineering.xlsx]
2017-04-19 Duplicate leg model to create laser-cut templates with transfer holes.
    [leg_laser_template_transfer_holes.SLDPRT]
2017-04-19 Reconfigure desk to maximum travel limits to recalculate center of mass.
    [master_assem.SLDASM]
2017-04-20 Verify bearing preload inlay depth.
    [Compliant Slider Preload.xlsx]
2017-04-20 Update detailed design spreadsheet for tip vs. slip analysis.
    [Detailed Engineering.xlsx]
2017-04-20 Update slider CAD to account for tribotape thickness.
    [master_assem.SLDASM, slide_nut_flange.SLDPRT, slider.SLDPRT, slider_apr19.DXF]
2017-04-20 Update CAD models and drawings.
    [boxway.SLDDRW, boxway.SLDPRT, cross_tie.SLDDRW, cross_tie.SLDPRT, desktop.SLDDRW, leadscrew_block_standoff.SLDDRW, leadscrew_block_standoff.SLDPRT, leg.SLDDRW]
2017-04-21 Fix assembly issues after updating models.
    [boxway.SLDPRT, cross_tie.SLDPRT, desktop.SLDPRT, leg.SLDPRT, master_assem.SLDASM, sandwich_bracket.SLDPRT, slider.SLDPRT, slider_assembly.SLDASM]
2017-04-21 Complete tip vs. slip analysis.
    [Detailed Engineering.xlsx]
2017-04-23 Update slider radial clearance value to match observed angular random motion.
    [error_budget_spreadsheet_twin_column.xlsx]
2017-04-23 Update drawings for readability.
    [desktop.SLDDRW, motor_flange.SLDDRW]
2017-05-09 Update part drawings.
    [boxway.SLDDRW, leg.SLDDRW, motor_flange.SLDDRW, sandwich_bracket.SLDDRW]
2017-05-09 add laser fabricated parts and router templates; update sandwich bracket design for aluminum version.
    [master_assem.SLDASM, motor_flange.DXF, radius template.DXF, radius template.SLDPRT, sandwich_bracket.SLDPRT, sandwich_bracket_1may.STL, slider_assembly.SLDASM]
2017-05-09 Update error budget and detailed structural calculations to account for mispositioned bolt holes.
    [Detailed Engineering.xlsx, error_budget_spreadsheet_twin_column.xlsx]
2017-05-10 Update drawings to clean up tolerances and generate PDFs.
    [boxway.SLDDRW, cross_tie.SLDDRW, leadscrew_block_standoff.SLDDRW, sandwich_bracket.SLDDRW, slider.SLDDRW, slider.SLDPRT]
2017-05-10 Update error budget and add data + analysis for final integration tests.
    [Stiffness Measurements.xlsx, error_budget_spreadsheet_twin_column.xlsx]
2017-05-14 Update stiffness test data.
    [Stiffness Measurements.xlsx]
2017-05-14 Update error budget spreadsheet for more realistic modelling. See Edit History sheet in file for detailed changelogs.
    [error_budget_spreadsheet_twin_column.xlsx]
2017-05-14 Calculate summary statistics and prediction error for stiffness measurements.
    [Stiffness Measurements.xlsx]
2017-05-23 Add parameter sweep analysis for actuator lifting force.
    [Detailed Engineering.xlsx, error_budget_spreadsheet_twin_column.xlsx]
2017-05-23 Rename worksheets for greater clarity.
    [Detailed Engineering.xlsx]
2017-05-23 Fix minimum deviation parameter sweep. Now uses sum of squares instead of linear sum to force even spread of error.
    [Detailed Engineering.xlsx]
